LighthouseXy/VoxConductor/hardware/checks/README.md

# 2026-10-11 整理校验

工具：KiCad 10.0.6。本轮只迁移资料，没有修改电路设计。

- [DRC](drc.json)：违规 0，未连接 0，原理图一致性问题 0；读取原有铺铜状态，没有改写 PCB。
- [ERC](erc.json)：错误 0、警告 1。U6 PAD 的“未指定”类型与 GND 电源输入相连，是已有的引脚类型提示。
- 原理图 PDF 重新导出并渲染核对，BOM 与 PCB 顶层 SVG 从当前源文件导出。
- V3 STEP / STL、复用光学件及螺丝/接口通道复查通过；详细记录位于 [V3 checks](../mechanical/V3-SLA/checks/)。
- 后续逐文件复核发现原光学/扬声器报告为空：FreeCAD 内部对象名带下划线，旧筛选跳过了六个结构件。已修正为按零件标签筛选并要求六件/18 组检查；通过 `complete_assembly.py --check-only` 补检，18 组参考包络交叠均为 0。此次未改写 CAD 几何、STEP、STL 或 FreeCAD 装配。
- 当前 KiCad 与原制造版本哈希一致；自定义库、供应商路径与 V3 重建输入保留。

静态校验不代表返修焊点、SD 卡座、树脂公差或全部功能已通过实物验收。
