LighthouseXy/VoxConductor/hardware/docs/audio/README.md

# 扬声器与线束资料

[3020腔体..3瓦.docx](3020腔体..3瓦.docx) 是供应商原始资料，保留原样。文档含 LLX3020B8-02 / LLX3020B4-03 型号混用及功率说明不一致，不能把“最大 3 W”作为连续额定功率。

结构尺寸依据：30 ± 0.2 × 20 ± 0.2 mm，工作高度 6.8 ± 0.3 mm；线长 120 ± 10 mm，30AWG、外径 0.8 mm。阻抗标为 4Ω ± 20%，额定 1.8 W、最大 3 W，先低音量验证。

板端 J3 为 Molex PicoBlade 53261-0271，线端配 51021-0200 与 50058-8000 端子 ×2。供应商原资料只写“1.25-2P”，不保证原线端插头兼容；按具体系列配套。

J3 两脚是 MAX98357A 的桥接输出，两端均不得接地。按脚号核对线序，不凭照片左右猜测。线束转弯、实际长度和固定方式需实配。

V3 托架、压框与紧固件见 [装配说明](../../mechanical/V3-SLA/README.md)。供应商资料保留原有署名和版权。
