LighthouseXy/VoxConductor/docs/HARDWARE_DESIGN.md

# 从电路到整机：我的硬件设计与装配

更新：2026-10-11。这里按设计和装配过程介绍硬件；信号连接、GPIO 与电气检查另见 [硬件与接线](HARDWARE_V1.md)。

我希望它既能完成显示与语音交互，也是一台可以独立摆在桌上的设备。因此，我把模块原型逐步整理为定制 PCB，再围绕屏幕、棱镜、按键和声音设计外壳。下面分别展示电路设计、PCB、加工实物、结构图与整机，不把设计图当作实测结果。

## 1. 先看整机：正面、侧面与后侧

| 正面 | 侧面 | 后侧 |
| --- | --- | --- |
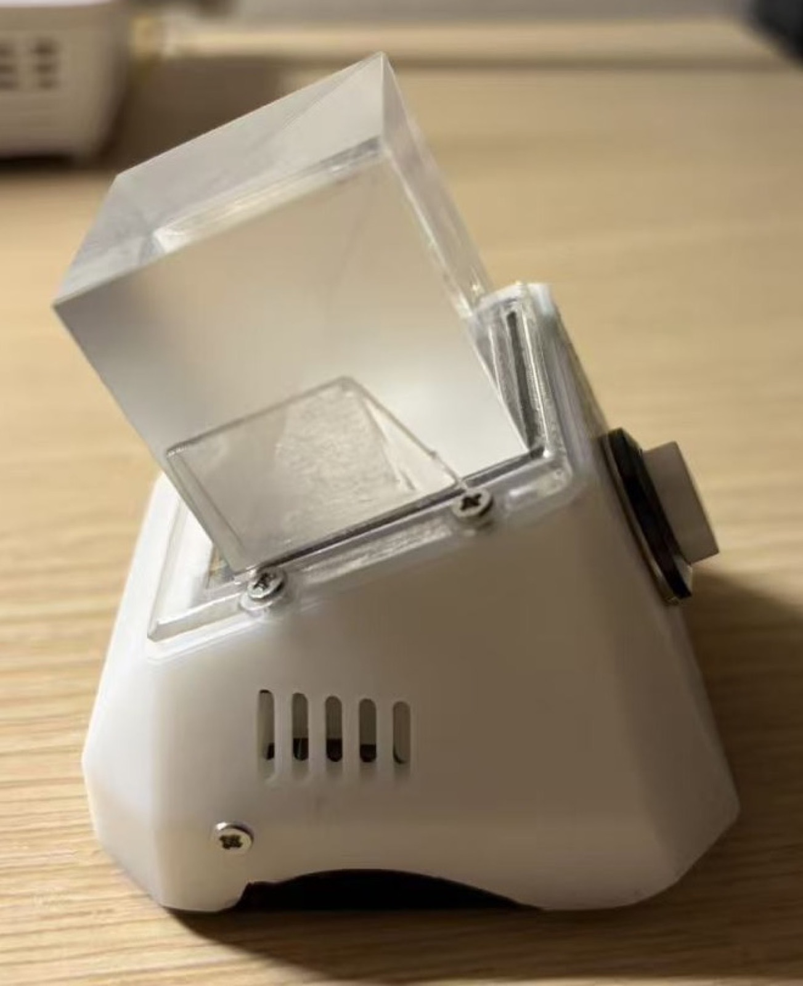
[picture p6: docs/images/2026-10-11/device-side.jpg]
侧面：棱镜倾角与外壳开孔
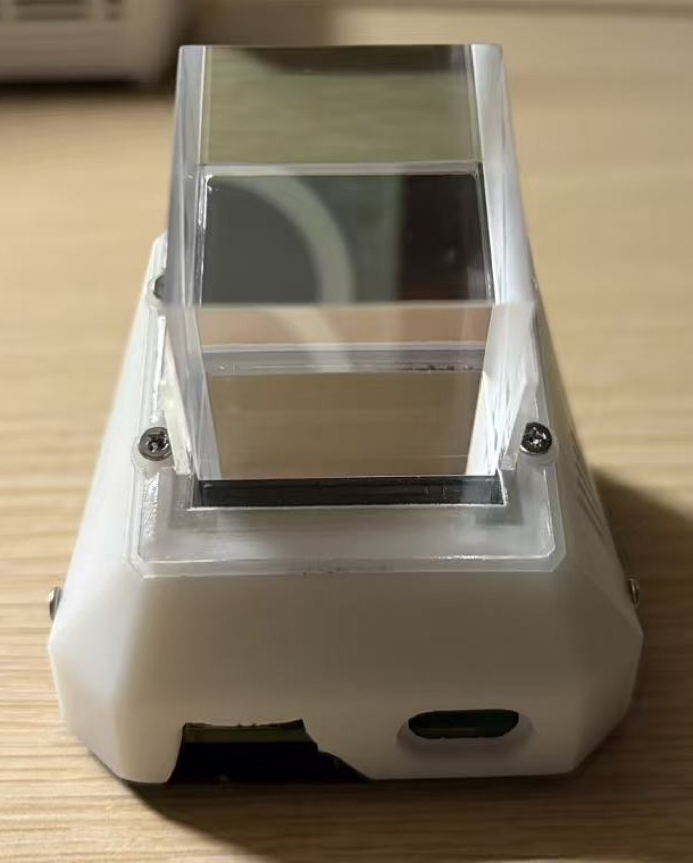
[picture p7: docs/images/2026-10-11/device-rear.jpg]
后侧：底部接口与结构
| 正面：棱镜、屏幕窗口与实体按键 |  |  |

这组是整机三个方向的实拍，不是带尺寸的工程三视图。另一侧的 [卡槽与结构开口照片](images/2026-10-11/device-side-slot.jpg) 用于补充接口观察。照片已从原图直接裁去多余背景，没有重绘设备或修改屏幕内容。

## 2. 电路：把显示、声音和交互放到同一块板上

| 模块 | 器件或接口 | 在设备中的职责 |
| --- | --- | --- |
| 主控与联网 | ESP32-S3-WROOM-1 | 运行固件、管理外设、连接 Wi-Fi 与云服务 |
| 显示 | ST7789 系列，240×240，FPC | 绘制时钟、天气、菜单与语音状态 |
| 采音 | INMP441，独立 I2S 输入 | 为语音识别、唤醒与声学诊断采集声音 |
| 播放 | MAX98357A、外接扬声器 | I2S 音频输出、语音播报与本地媒体 |
| 姿态 | MPU6050，I²C | 倾斜翻页、滚动与时间调节 |
| 存储 | microSD，独立 SPI | 媒体、文字记录、任务与快照 |
| 手动交互 | 外接实体按键 | 确认、返回、按住说话和取消会话 |
| 供电与维护 | USB、电源转换、复位/下载电路 | 供电、烧录、调试与外围电源管理 |

主原理图，从 KiCad 工程直接导出

[打开可放大的主原理图 SVG](images/2026-10-11/schematic-main.svg) · [完整原理图 PDF](../hardware/exports/VoxConductor-schematic.pdf) · [KiCad 工程](../hardware/VoxConductor.kicad_pro)。器件值和网络名称保留工程原样，核对接线请放大查看。

我将显示、SD、采音和播放安排到各自对应的接口上。这样软件可以分别管理它们的速率、队列和错误恢复；并不意味着外设之间不存在 CPU、内存或总线竞争。Flash/PSRAM 容量需要依据模组完整后缀和启动日志确认，不能只看到 WROOM-1 就推断容量。

## 3. PCB：设计布局与加工实物对应看

| 顶层布局（铜层、丝印、板框） | 底层布局（镜像查看底面） |
| --- | --- |
| PCB 顶层导出 | PCB 底层导出 |

当前工程为 52 × 50 mm 四层板：顶层主要布置器件和信号，内层包含地与电源分配，底层辅助布线与铺铜。这两张展示图只导出了外层；完整生产输出见 [2026-09-16 制造资料](../hardware/fabrication/2026-09-16/README.md)。[电子 BOM](../hardware/BOM.md) 单独列出 24 个电阻、22 个电容位置、6 个 IC/模组及连接器等，共 61 个位置；其中 C8、C9 不装配。逐位号明细已与原理图网表核对，采购规格未确认的部分明确留待补齐。

| 贴片前：裸板批次 | 贴片后：器件装配 |
| --- | --- |
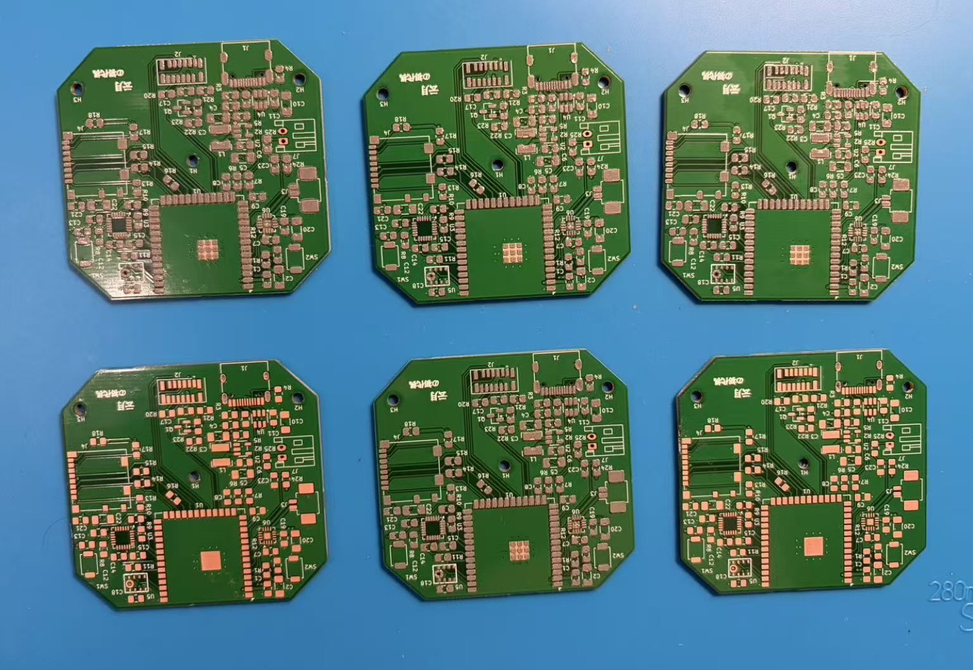
[picture p8: docs/images/2026-10-11/pcb-bare-batch.jpg]
加工完成的裸 PCB
|  | 装配元件后的 PCB |

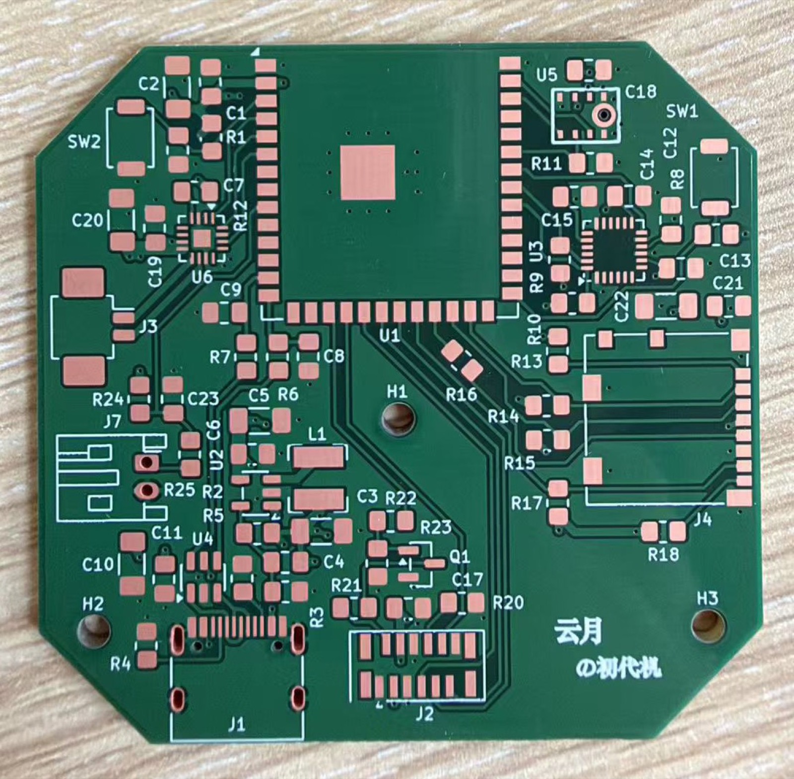
[picture p9: docs/images/2026-10-11/pcb-bare-detail.jpg]
裸板焊盘、板框与丝印细节


从裸板到贴片板，可以对应看到模组焊盘、FPC、USB、卡座和外围器件的位置。照片记录实际加工和装配；电源、焊接质量、音频噪声与长时间稳定性仍通过专项检查判断。

本轮硬件整理保留了 [ERC/DRC 校验记录](../hardware/checks/README.md)。KiCad 主文件仍与 9 月制板版本相同：实物屏幕接口 J2 曾旋转 180° 返修，但尚未写回设计。再次生产前必须完成这项修订并重新审图，不能直接将现有制造文件视为已修正版。

## 4. 装配部件：每一部分负责什么

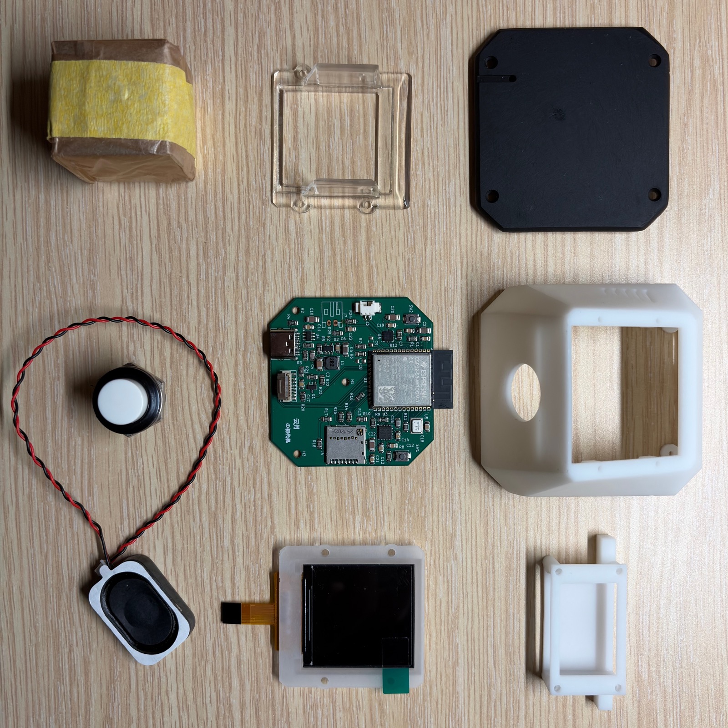
[picture p10: docs/images/2026-10-11/assembly-parts-overview.jpg]
装配部件全景，保留部件之间的位置关系


另一张 [不同角度的部件全景](images/2026-10-11/assembly-parts-angle.jpg) 补充屏幕、外壳和透明件的形状。图中黄色纸包裹的是方形分光棱镜；我补充了去掉包装的独立实拍，下面按电子、显示光学、结构与交互部件介绍。

| 部件 | 用途与装配关注点 |
| --- | --- |
| 主板 | 承载主控与外围电路，按底盖柱位固定，避免排线和线束压住接口 |
| 显示组件 | 屏幕与 FPC 提供图像；接触面和针序按实物接口确认，排线不能夹在接缝中 |
| 主壳与底盖 | 定位电路板、按键和光学组件，保留 USB、SD 与声音通道 |
| 显示固定框 | 固定屏幕/光学组件，检查螺钉、边缘压力和观察方向 |
| 方形分光棱镜 | 将屏幕光线通过分光界面反射至观察方向，形成悬浮显示观感；保护光学面，避免磕碰与污染 |
| 透明支架 | 承托光学组件并保持与屏幕的相对位置；装配时避免划伤或过紧夹持 |
| 实体按键 | 在不依赖语音时完成确认、返回、录音与取消，注意活动空间和走线 |
| 扬声器 | 播报语音与媒体，固定后检查出声通道、线束和结构振动 |

| 主板 | 屏幕与排线 | 外壳 |
| --- | --- | --- |
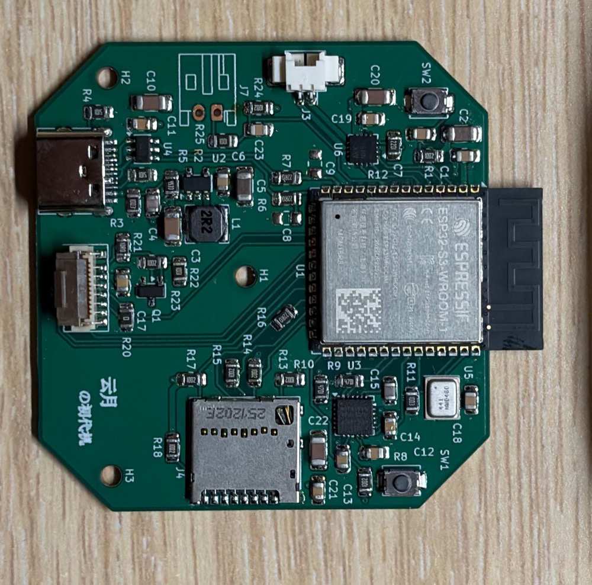
[picture p11: docs/images/2026-10-11/part-mainboard.jpg]
装配主板局部
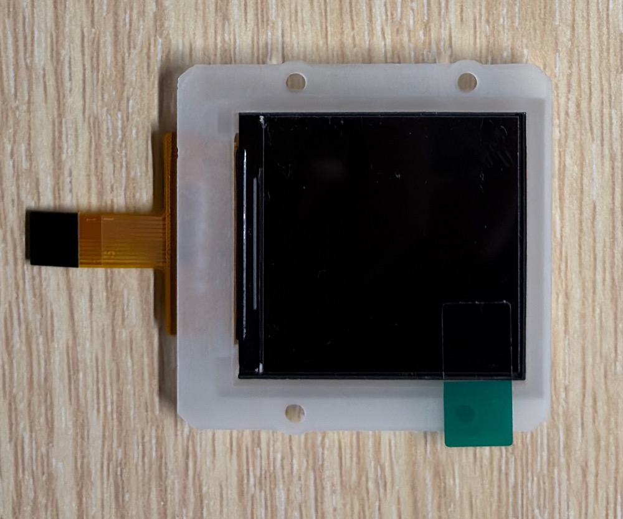
[picture p12: docs/images/2026-10-11/part-display.jpg]
显示组件局部
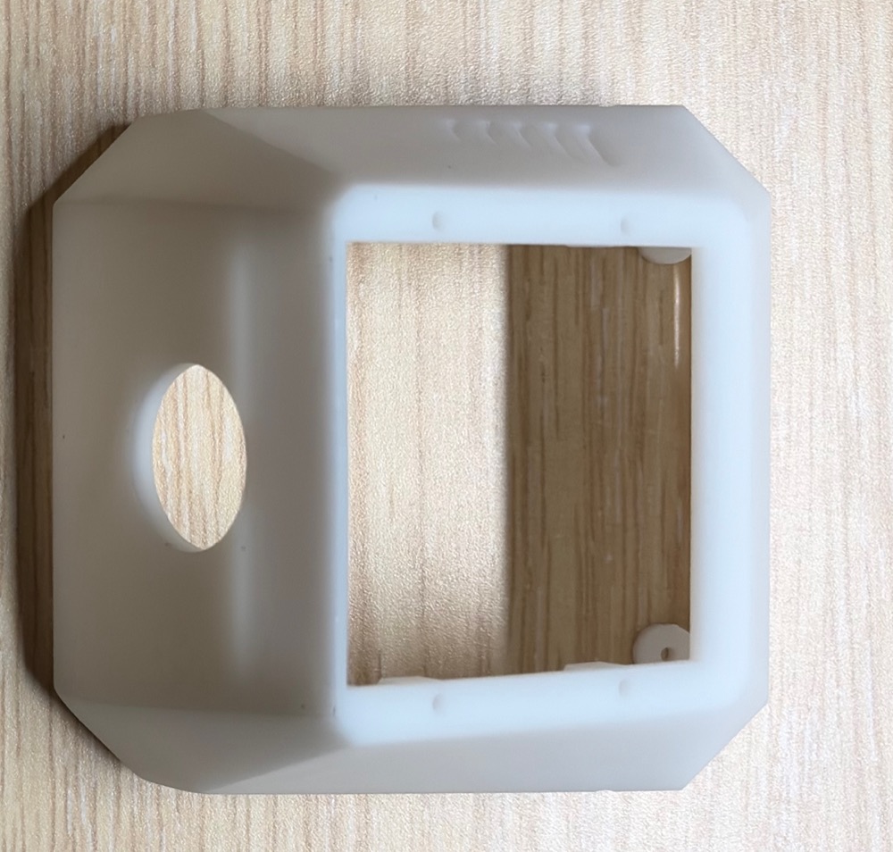
[picture p13: docs/images/2026-10-11/part-enclosure.jpg]
外壳局部
|  |  |  |

| 底盖 | 显示固定框 | 透明支架 |
| --- | --- | --- |
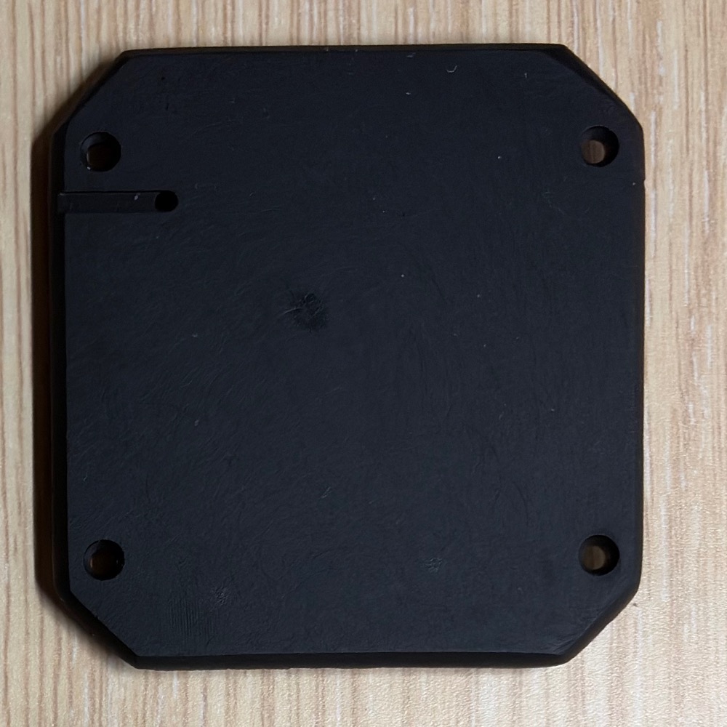
[picture p14: docs/images/2026-10-11/part-base.jpg]
底盖局部
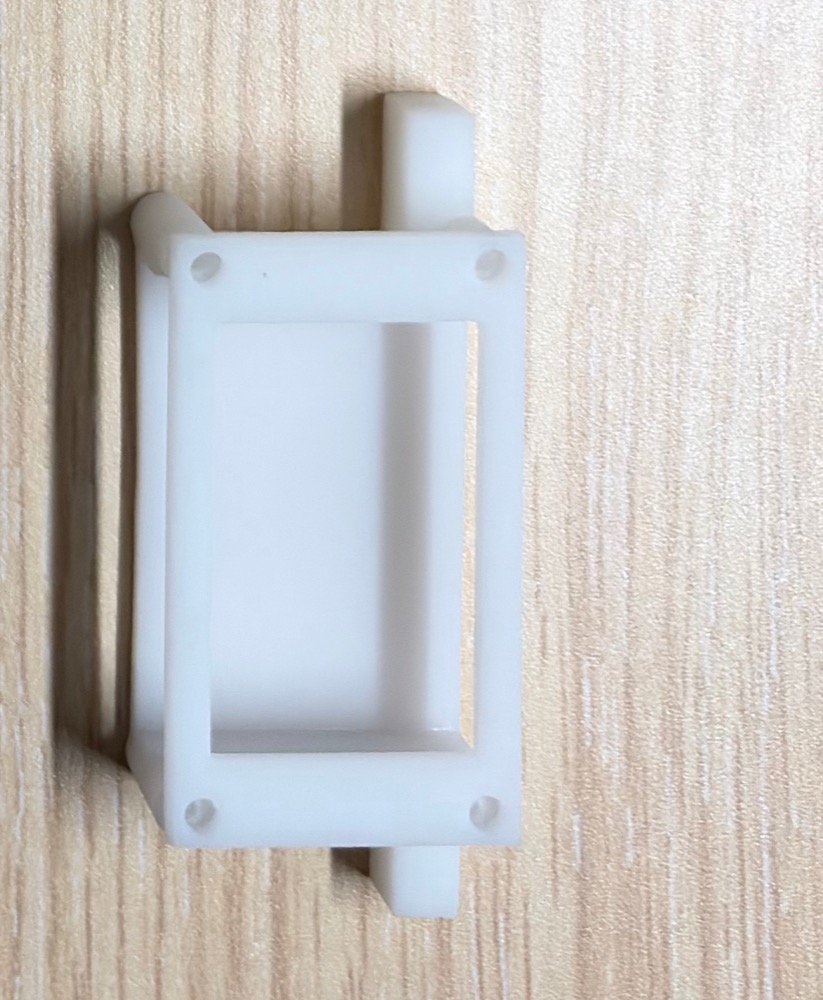
[picture p15: docs/images/2026-10-11/part-screen-frame.jpg]
显示固定框局部
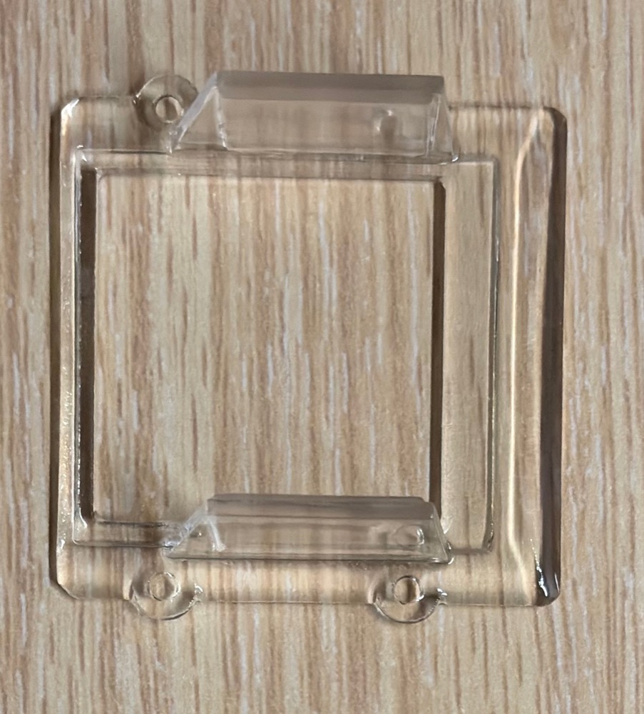
[picture p16: docs/images/2026-10-11/part-prism-carrier.jpg]
透明支架局部
|  |  |  |

| 实体按键 | 扬声器 |
| --- | --- |
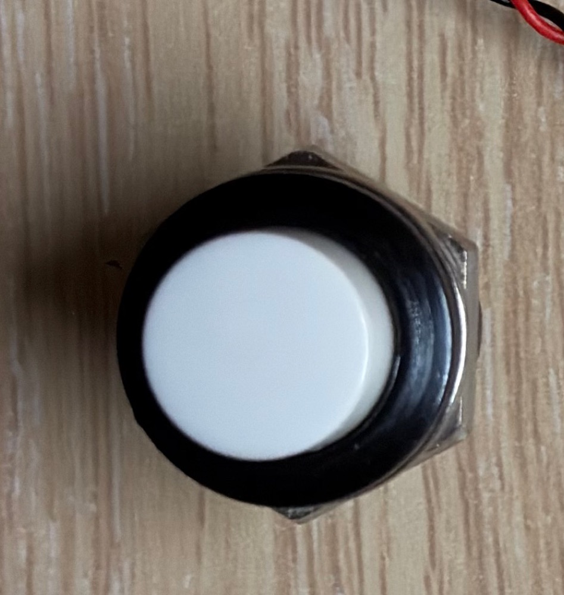
[picture p17: docs/images/2026-10-11/part-button.jpg]
实体按键局部
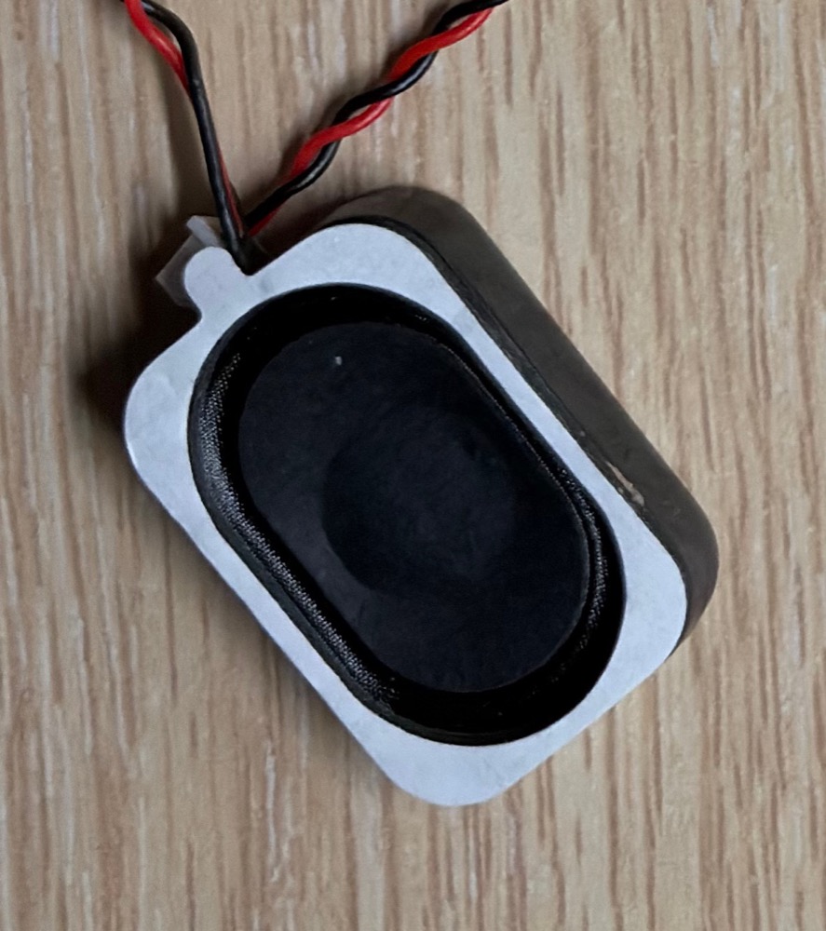
[picture p18: docs/images/2026-10-11/part-speaker.jpg]
扬声器局部
|  |  |

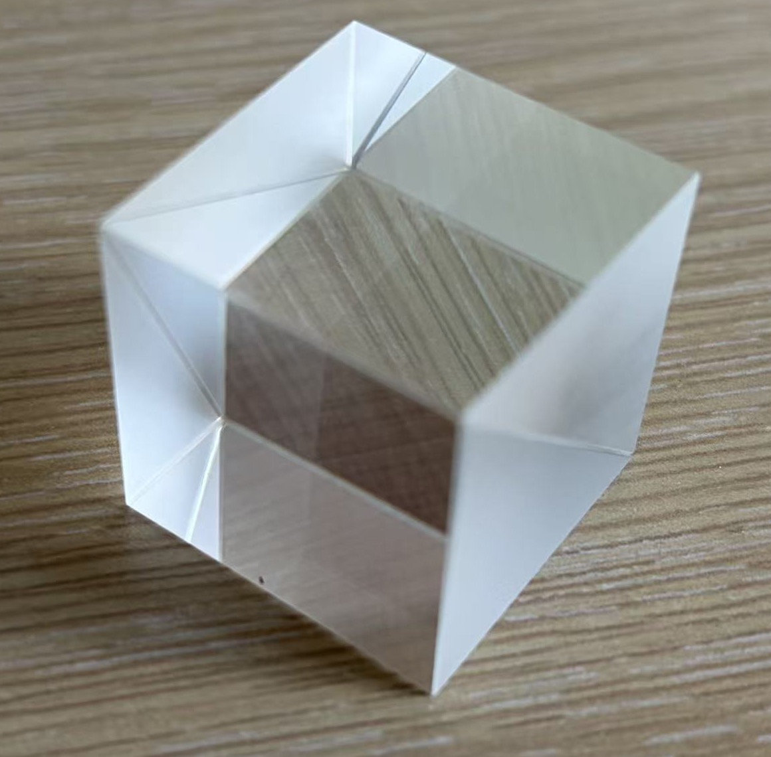
[picture p19: docs/images/2026-10-11/part-beamsplitter-prism.jpg]
去除包装后的方形分光棱镜实拍


八张局部图从部件全景裁出，棱镜图使用 10 月 11 日新增实拍，均未重绘器件。棱镜的分光比例、材料和镀膜规格没有可靠采购记录，不从照片推断。全景与局部图不代替采购清单；[原始部件照片](images/2026-10-10/assembly-parts-overview.jpg) 保留高分辨率版本。

显示链路是“SPI 屏幕图像 → 分光棱镜的内部界面 → 观察者”，不是体积全息显示。黑底减弱背景杂光，亮色字符提供反差；镜像/旋转补偿决定观察方向上的字形。光学件的定位、环境照明和观察角度共同影响清晰度，不能仅提高屏幕亮度解决。结构还要兼顾按键触达、接口插拔、麦克风收音与扬声器固定。

## 5. 3D 结构：已装配实物与后续设计分开记录

以下为 **V3-SLA-20261011 结构设计导出，待打印与试装**。它比上面的实物照片更新，不能把实物照片当作这个版本已经装配成功的证明。

| 外壳设计 | 内部装配分解 |
| --- | --- |
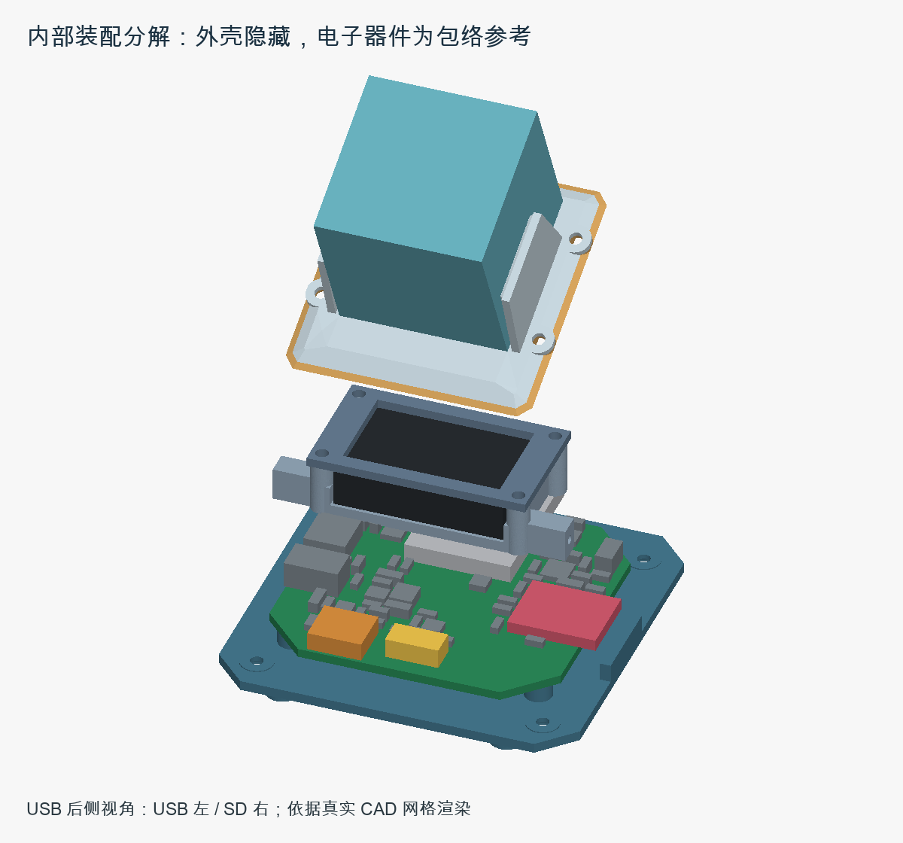
[picture p20: hardware/mechanical/V3-SLA/preview/02_internal_exploded.png]
V3 内部装配 CAD 渲染，待试装
| V3 外壳 CAD 渲染，待试装 |  |

[PCB 与固定柱关系图](../hardware/mechanical/V3-SLA/preview/03_board_and_bosses.png) · [STEP/STL、打印清单与装配说明](../hardware/mechanical/V3-SLA/README.md)。渲染中的电子器件为装配包络参考，不是每个器件的精细外形模型。

这轮结构迭代主要处理 PCB 方向映射、固定柱与装配路径、USB/SD 开口和麦克风位置。设计资料采用“先验证入口框和底盖，再替换外壳相关件”的试装顺序。模型检查只覆盖几何关系；树脂收缩、打印公差、排线弯折、螺钉咬合和声学表现仍需实物确认。

## 6. 资料版本与下一步补齐

| 材料 | 本次记录方式 | 不能据此推断 |
| --- | --- | --- |
| 主原理图与 PCB | 10 月 11 日从现有 KiCad 工程导出 | 不是本次重新电气审核或重新打板 |
| 裸板、贴片板、部件、整机 | 桌面文件夹中的真实照片，裁边展示 | 不保证与最新结构版本一一对应 |
| V3 结构图 | 独立标注版本和待试装状态 | 不等于已打印、装好、通过声学测试 |
| GPIO 与电气说明 | 保留已确认映射，另文维护 | 旧模块 BOM 不能代替定制板 BOM |

工程文件统一收录在 [hardware/](../hardware/README.md)，说明文档直接引用它们，不复制多套 STEP、STL 或 ZIP。必要的冻结输入用于重建 V3，会继续保留；展示照片和工程文件分别管理。

接下来我会将 J2 实物修正写回设计，补全采购料号和实物验收记录，并按 V3 打印清单完成试装。当前资料用于说明与复现设计，不作为量产验收结论。

[返回项目概述](../README.md) · [软件功能与页面](FEATURES.md) · [电气与 GPIO](HARDWARE_V1.md)
