LighthouseXy/VoxConductor/docs/GITHUB_PUBLICATION_CHECKLIST.md

# GitHub 文档、素材与后续代码发布

整理日期：2026-10-11。

2026-10-15 调整发布范围：开发日志和个人面试技术资料仅在本机保留，已从公开版本撤下，并由忽略规则排除后续提交。下文保留原批次的发布记录；当前公开范围以此项调整为准。

## 10 月 10 日展示素材发布范围

此节记录当日首次发布；完整视频在 10 月 11 日后续校订中改为提问阶段变调版，见本文末节。

我先把当前实物、功能演示与开发进展整理清楚。本次只提交 README、docs 文档及精选展示素材；不顺带提交本机尚未发布的固件、服务器代码或构建配置。

- 精选 15 张实拍：整机、PCB、组装部件、天气、闹钟、设置与语音状态。
- 两段完整原声视频：唤醒后查询时间/天气、语音调节音量。
- 两段原声回答阶段节选：保留原速度，注明来源时间，不作为端到端延迟证明。
- 两张视频取帧封面、逐文件来源与 SHA-256 清单。
- 当前使用说明、后续计划及管理网页设计。原已发布的按日开发日志现已撤下，改为仅本地保留。

[展示图集](SHOWCASE.md) · [素材清单](images/2026-10-10/manifest.json) · [文件清单](GITHUB_FILE_MANIFEST.md)

桌面的原始素材全部保留。重复角度和信息相近的照片没有全部放进仓库；高分辨率部件全景采用链接，避免首页自动加载大图。旧 V1 照片和验证记录保留为历史，不拿来证明新固件已经通过验收。

## 这次不发布的内容

- 最新固件、测试、工具、examples、server 代码及 .gitignore 的未提交修改。
- Wi-Fi 密码、API Key、局域网设备令牌、真实配置头文件和 .env。
- BIN/ELF、build、managed_components、本机缓存、虚拟环境与原始串口日志。
- SD 对话、快照、个人记忆、诊断录音、数据库和电脑备份。
- backups 下的旧工程/游戏归档。
- 完整音乐与壁纸资源包；第三方素材必须先核对分发许可和署名。

文档中的“当前开发版”描述我的实机开发进展，不表示这个文档提交已经带上全部新代码。代码发布另做完整性检查，不零散补几份文件制造不可构建的中间状态。

## 后续代码同步要准备什么

1. 固定固件版本和 ESP-IDF/组件锁文件，核对实际板卡、Flash、PSRAM、模型与分区。
2. 以 CMake 引用为准整理源码和辅助头文件，不把已移除游戏、旧播放路径当成当前依赖。
3. 同步配置示例、字体/提醒等必要资源、主机测试与工具，明确哪些测试需要额外媒体包。
4. 用占位符替换示例凭据；检查固件二进制是否包含个人密钥，不直接公开私人烧录文件。
5. 在干净克隆上检查依赖完整性，再构建、烧录和实测；三者与源码检查分别记录。
6. 完整媒体包另行发布，保留作者、许可、来源、格式和校验值，不同时提交 ZIP 与展开副本。

没有实际发布 Release 时不写下载地址，也不将历史资源包大小当作新版本统计。

## 还值得补拍的内容

| 素材 | 用途 |
| --- | --- |
| 长回答完整录音及同轮日志 | 验证卡顿，不靠短成功片段代替 |
| 打断成功、只唤醒后静音的对照 | 验证新输入不是旧回答尾音 |
| 音量/主页操作前后及重启回读 | 验证真正生效与持久保存 |
| 手机与电脑上的管理网页 | 展示当前页面，不使用未落地设计冒充实装 |
| 闹钟到期、预报滚动与姿态调节 | 静态照片看不到的交互 |
| 采购级料号与实测结构尺寸 | 位号级 BOM 已整理；公差、耐压、完整料号和装配实测仍需补齐 |

## 公开表述

我会使用第一人称讲清楚自己做了什么，同时保留事实边界：棱镜是二维屏幕反射；ASR/LLM/TTS 需要云服务；空气质量为网络模型数据与 US AQI；“已接入”“已有成功演示”“重复验收通过”分别表述。

目前不会写“稳定全双工”“零延迟”“所有功能均已验证”或“最新固件已完整发布”。项目文档独立维护，小红书稿暂停，不由 GitHub 推送代替社交平台发布。

## 提交检查

只按明确路径暂存，检查暂存清单与差异、链接、文件校验、凭据和大文件。远端无冲突才正常推送，不强推，不覆盖本机其他改动。最终推送结果以提交记录和远端 SHA 核对为准。

## 10 月 11 日硬件资料同步

新增整理后的 [hardware/](../hardware/README.md)，更新相关文档入口。原理图、PCB 主文件未改写；当前导出的 PDF/BOM/顶层图与生产资料有明确版本说明。V3 保留 CAD 校验与实物试配待完成的边界，实物 J2 返修未被描述为已写回 KiCad。未提交本机固件、凭据、构建或个人资料。

## 10 月 11 日作品文档更新

首页先说明项目目标和技术路线，再介绍硬件与软件。硬件说明增加三个实拍方向、两张部件全景和八个局部，直接链接更新后的工程资料；软件先列总览，再逐页介绍。文档导航区分作品、工程、验证和历史，不采用社交博文格式。

新增裁边展示图、原理图/PCB SVG 和网页模拟截图，来源与校验单独记录。网页改版保留在本机开发版：本批只推送说明与预览，不将未发布固件文件零散混入文档提交。10 月 11 日后续接口修改已编译通过，烧录与实机回归仍待完成。

更新后的硬件资料另做逐文件复核，修正光学/扬声器校验脚本的对象筛选，补齐原空报告的 18 组检查与文件哈希；几何和装配源文件没有改动。这项资料校验修正单独提交，不与固件改动混在一起。

## 10 月 11 日后续校订

补充技术架构，逐项区分当前开发版与 V1 历史说明，修正接线文档中的旧交互描述。定制 PCB BOM 展开为 61 个位号，并与新导出网表核对；采购规格未确认的部分明确保留，不把分组值当完整采购表。

新增方形分光棱镜照片并更正装配部件介绍。两段完整演示提问阶段变调，时间线与画面保留，视频移到首页功能与技术说明后；处理范围和历史原声边界写入视频说明。已有历史提交不重写。
