LighthouseXy/VoxConductor/docs/logs/2026-10-11.md

# 2026-10-11｜硬件归档、作品文档与网页布局

## 今日目标

将项目介绍、硬件工程和功能说明整理为清晰的阅读层次，补充我拍摄的部件照片，并改进同网设备管理网页。小红书稿暂停，不影响项目文档格式。

## 硬件资料整理

现有原理图、PCB、制造文件与 V3-SLA 结构统一归入 `hardware/`。保留源文件、供应商尺寸资料、板载 BOM、校验记录和必要重建输入；旧整包、临时文件和重复 ZIP 不在活动目录里。硬件整理已独立提交，本文档更新直接引用该目录。

KiCad 主文件与 9 月投板版本一致，J2 实物旋转返修尚未写回设计。V3 的 USB 镜像、固定柱干涉和通道已经进行 CAD 检查，打印公差、线束弯折和紧固强度仍待试装，不将模型检查写成实物验收。

逐文件复核发现光学/扬声器报告为空：FreeCAD 内部名称带下划线，脚本的数字前缀筛选跳过了结构件。改用零件标签并检查数量后，以只检查模式补跑 18 组参考包络，交叠均为 0；CAD 几何、STEP/STL 与装配文件未改变。校验报告与重建脚本保留，哈希同步刷新。

## 作品文档与图片

首页按“项目概述 → 演示 → 硬件 → 软件总览 → 实现与问题 → 计划”组织。硬件介绍与 GPIO 参考分开；功能说明先汇总再按页面展开；文档索引区分作品、工程、验证和历史。

部件照片使用一个主要全景、一个补充角度和八张局部图。原图保持不变，展示图裁去多余背景，核对 EXIF 方向后再裁切。包裹部分不猜测内部型号；结构预览直接引用硬件目录，避免重复副本。

两段完整视频和回答阶段节选沿用 10 月 10 日整理结果。本轮没有重剪或加速视频，也不将回答阶段节选作为响应延迟证明。

## 网页实现与问题处理

管理页从长页面改为概览、外观、媒体、事项、对话、诊断六区：电脑侧栏，手机底部导航。复用现有 API，不新增前端框架或云账号。

加入配置草稿提示、刷新保留脏字段、保存前合并最新状态、结果回读、事项筛选和稳定编号。修正图片预览/导出的压黑一致性，保留串行上传并显示传输进度；诊断默认折叠，按需手动开始。

检查中发现百分比单位与唤醒复选框被表单网格拆到独立行，调整为明确的单位标签与横向勾选；上传进度容器也改为实际传输时可见。

## 验证与发布边界

主机测试覆盖媒体上传/WAV、配置草稿与合并、非法数值、失败提示、任务时间、历史分页和安全文本。浏览器使用模拟接口检查电脑/手机布局及设置、事项、历史和诊断入口；截图明确标注未连接实机。

本轮没有编译、烧录或网页实机验收，没有据此修改语音卡顿与打断的结论。文档和展示素材单独提交推送，保留本机其他未发布改动。

## 遗留事项

1. 新固件烧录后回归配置保存、重启保持、媒体上传、语音忙与会话过期。
2. 旧媒体命令统一持久结果、轻量状态接口及有界传输工作槽仍需后端设计。
3. 写回 J2 修正，补采购料号并打印 V3 入口框/底盖试装。
4. 继续用同版本长回答和唤醒词打断对照，验证播报与新问题采集。

[文档导航](../README.md) · [网页说明](../WEB_MANAGEMENT_DESIGN.md) · [硬件介绍](../HARDWARE_DESIGN.md)

## 上午后续更新：技术说明、BOM 与管理功能

继续校订首页、硬件、板级接线、视频与管理说明，新增当前技术架构。视频入口移到功能和实现之后；旧 V1 说明保留历史口径，删除重复迁移提示。上面“未编译”的记录对应此前布局阶段，以下为这轮新增接口的结果。

黄色包装内的部件已确认为方形分光棱镜，新增去包装实拍并裁去背景。电子 BOM 从分组表展开为逐位号 CSV，与新导出 KiCad XML 网表逐项核对：61 个位置，59 个拟装配，C8/C9 为 DNP。补齐无源元件、IC、连接器说明，未确认的采购规格不猜填。

网页增加不读 SD 历史的轻量状态 GET、媒体命令回执查询、上传取消与单段 Range 试听；纪念日刷新保留草稿，未修改字段同步设备。继续复用有限作业槽，不新增前端框架。传输尚非独立异步任务，取消不保证撤回已提交文件。

两段完整视频提问阶段降低音高并补偿时长，视频画面流校验相同，桌面原件保留。没有分离说话者，同区间的环境或设备声音可能一同变调；也不承诺强匿名化或删除旧 Git 历史中的原声。

本轮增量固件编译通过，应用占 4 MiB 分区约 94%，尚未烧录。主机测试覆盖配置与纪念日草稿、媒体回执、取消清理、Range 边界、任务和历史流程。新增接口仍需设备回归，采购料号、J2 修订与 V3 试装继续保留为待办。

完整主机回归最初因测试日志桩缺少 `ESP_LOGW` 宏而停止；补齐桩后通过。该问题属于测试环境，不修改播放策略。最终检查涵盖 TTS 协议、队列取消、工具确认、存储快照、天气、任务与按键；它仍不验证扬声器听感。

## 后续更新：网页播报语速与音色

“主页与声音”加入 0.50～2.00 倍语速（0.05 步长）与六种内置音色，保留“固件默认”。音色列表由设备返回，草稿不立即改变设备；保存共用原协调任务与 NVS 提交，并回读实际值。语音占用时等待空闲，保存成功后从下一次 TTS 会话生效。

云端接收 `voice` / `speech_rate`，设备不做本地变速、不增加音频任务，24 kHz PCM、原播放缓冲和取消路径保持不变。新设置用于回答和云端提醒，不改变音乐、离线提示音或麦克风。旧 NVS v1～v4 迁移到 v5，使用两个保留整数，配置体积不增加；回退旧固件前仍应备份配置。

主机测试覆盖实际 TTS 请求、各音色、语速边界、会话快照、提醒、旧配置迁移、无效值拒绝、草稿与保存回读。电脑和 390 像素手机布局使用模拟接口检查，手机音色控件单独占一行，无横向溢出。固件编译通过，没有烧录、真实云端合成或扬声器听测。

下一步实机用同一句问题比较 0.80、1.00、1.25 倍与男女音色，随后检查重启保存、唤醒/打断、取消和提醒。语速设置不是卡顿修复，卡顿仍按音频供给与 I2S 输出的分层证据验证。
