LighthouseXy/VoxConductor/docs/logs/2026-09-25.md

# 2026-09-25｜定制 PCB 接入与屏幕排查

## 今日目标

把原模块化原型迁移到定制 PCB，核对外设引脚，解决黑屏与显示方向问题。

## 已完成

- 核对显示、按键、音频、SD 和 MPU6050 接口，固件采用新板引脚，不再沿用原型接线。
- 根据板级资料区分复位与下载按键：SW2 为 EN 复位，SW1 为 GPIO0 下载按键；不能仅凭编号判断其他板子的按键。
- 针对无背光，分开检查 3.3 V 电源、GPIO9 控制与背光电流回路。用户测得 GPIO9 约 3.23 V；C17 供电约 3.3 V，R22 两端对地约 0.73/3.23 V，R23 约 0.73/0 V，R21 两端约 0 V。
- 把板级测量和照片交给 PCB 对话继续核对。当天后续照片已出现正常画面，但方向倒置；显示初始化加入对应旋转/镜像调整。
- 保留新板迁移前的工程备份，不覆盖旧版本。

## 问题与解决

| 问题 | 分析与处理 | 结果边界 |
| --- | --- | --- |
| 初始化日志正常，屏幕却不亮 | 软件初始化完成不证明背光电流通路正常；电阻“跨两端电压”和“两端分别对地电压”需区分 | 后续照片证明屏幕可显示；没有足够记录确认最终进行了哪项硬件维修 |
| 画面上下颠倒 | 棱镜反射方向和面板安装方向需要统一处理 | 当日显示方向代码已调整并构建；不能代替后续装壳实测 |
| 不清楚当前亮度 | 当时背光为 GPIO 常高，软件占空比相当于 100% | 不是实测光亮度；后续才增加 PWM 调节 |

## 结论与遗留事项

不凭照片指定未核实的 A/K 焊点，不通过短接猜测背光故障。当前接线以 [硬件说明](../HARDWARE_V1.md) 为准；装壳后的姿态方向、背光与音频仍需联合测试。

本篇依据当日对话、串口截图、板级照片和测量记录补记；未保存到仓库的照片不算公开展示素材。
