LighthouseXy/VoxConductor/docs/logs/2026-09-27.md

# 2026-09-27｜姿态翻页诊断、方向修正与诊断日志收口

## 今日目标

解决装壳后左倾触发反向翻页、右倾没有反应的问题，并使日志便于采集。

## 已完成

- 备份工程名称整理为 Firmware backup，备份的工作区与构建配置同步，不把备份缓存混回主工程。
- 增加原始加速度、滤波、中位、偏移、有效性和 armed 状态诊断，区分采样频率与日志输出频率。
- MPU 检测保持约 20 ms 一次，诊断输出按用户要求降到约 500 ms 一次；不是每次采样都必须打印日志。
- 根据左倾三次、右倾三次的对照日志修正重新武装与安装方向映射；有效重力范围调整到约 0.65～1.50 g。
- 排查结束后移除 XYZ、偏移与识别过程日志，保留实际页面切换、启动和错误信息。
- 分析不改 PCB 的外接 5 V USB 电池模块方案，没有接入充电、电量采样或修改供电硬件。

## 问题与解决

右倾时日志已有约 -458～-480 mg 偏移，却出现 armed=0，不能归因于“用户倾斜不够”。重新回中与稳定状态判断使动作资格提前丢失；部分姿态的加速度模长又超过旧上限。处理包括稳定回中后再武装、离开水平时不提前清除动作资格，以及调整有效性范围。

方向映射在安装坐标到屏幕坐标的入口统一处理，不让页面与游戏各自反转。当天的源码检查与构建有通过记录；后续 10 月 6 日又按装壳反馈统一恢复正常方向，见 [当日日志](2026-10-06.md)。

## 结论与遗留事项

采样快是为了及时判断动作，日志应限速。实机重点是左右都能触发、一次倾斜只翻一次、回中可重新触发，而不是单纯降低阈值。电池仍为设计建议，不记作已实现。
