LighthouseXy/VoxConductor/docs/logs/2026-10-10.md

# 2026-10-10｜播放缓冲、结束对话与作品资料整理

## 今日目标

解决播报持续卡顿和打断后误收录的问题，补齐结束对话入口，并把当前实物与开发进展整理成可公开阅读的作品资料。

## 问题与分析

凌晨测试中，唤醒词打断比之前更容易触发，但只说唤醒词后不继续讲话，设备仍可能收录旧声音。预录缓冲和扬声器尾音需要与真正的新问题区分。

播报卡顿并不总伴随网络 PCM 队列耗尽：日志出现较长的输出写入耗时，提示还要检查任务调度、I2S 和 DMA 的持续供给，不能只增加云端预缓冲。

## 已调整的源码

- 打断接续加入旧音频尾部处理和新的有效人声要求，避免直接把预录内容当作新问题。
- 扬声器 DMA 从 4×160 帧调整为 8×256 帧，24 kHz 下覆盖时间约 26.7 ms → 85.3 ms；匹配写入分块，并同步补偿 AEC 参考排队时间。
- 加入“结束对话”“退出语音”“不聊了”等完整命令的本地处理；清理连续接话与待处理状态，保留历史及下一次唤醒能力。
- 保留按键取消，不把“谢谢”或“不要结束对话”当成退出请求。

这些是源码调整，不是本日已经完成的最新固件听测结论。主机检查、编译、烧录和声学验收仍分开记录。

## 文档与展示整理

我从 23 张照片中选出 15 张，分别说明整机、PCB、部件、天气、闹钟、设置和语音状态。两张信息重复的部件全景只保留一张高分辨率原图，重复角度不全部堆进首页。

两段原声视频分别演示唤醒后查询时间/天气（25.93 秒）和语音调节音量（29.27 秒），另提取回答阶段短片并注明原片区间。保留完整原片用于查看真实过程。

README、图集、使用说明、后续计划、网页设计、发布清单与日志索引同步更新，以第一人称介绍我做了什么，并明确云服务、棱镜反射与声学未完成项。参照第一篇小红书文章，另整理后续更新稿和配图顺序。

## 发布与后续

本批只同步文档与展示素材，不带上未发布固件、私人凭据、原始串口日志或诊断录音。小红书稿单独交付，不自动发布。

接下来用固定长回答、唤醒词打断、只唤醒后静音和结束命令做同版本回归；管理网页截图、闹钟到期及设置重启回读仍值得补充。实物见 [图集](../SHOWCASE.md)，优先级见 [开发计划](../ROADMAP.md)。
