LighthouseXy/VoxConductor/docs/logs/2026-08-08.md

# 2026-08-08 开发日志

## 当日目标

盘点音频器件并确认麦克风模块类型。

## 已完成

- 确认已有扬声器为 4 Ω/3 W 小型扬声器，只有红黑两根引线，不能直接由 ESP32 GPIO 驱动。
- 确认麦克风商品为已焊排针的 INMP441 数字 I2S 模块。
- 根据模块丝印确认接口：`VDD/GND/SCK/WS/SD/L/R`。
- 确认 INMP441 应使用 3.3 V 供电，不是 I2C 传感器。
- 确定麦克风首轮接线：SCK=GPIO8、WS=GPIO9、SD=GPIO14、L/R=GND。

## 结论

- INMP441 输出数字 I2S 采样数据，不需要模拟 ADC。
- L/R 接 GND 选择左声道；固件应读取对应声道的数据槽。
- 扬声器后续需要 MAX98357A 等 I2S D 类功放模块。

## 遗留事项

- 通过串口统计验证 INMP441 是否产生有效采样。
- 核对模块是否存在短路、虚焊或引脚错误。
