LighthouseXy/VoxConductor/docs/images/README.md

# 图片与展示素材

## 当前展示版 · 2026-10-11

我将图片按用途分为整机、加工/装配、功能页面和网页预览。展示图直接从原图裁边，保留完整主体；没有重绘设备、补画器件或修改屏幕内容。八张部件局部图来自同一张装配全景，另一角度作为补充链接。

- [硬件设计与部件说明](../HARDWARE_DESIGN.md)：三个实拍方向、裸板/贴片板、部件全景与局部。
- [功能与页面](../FEATURES.md)：时钟、闹钟、天气、设置、菜单与语音状态。
- [网页布局](../WEB_MANAGEMENT_DESIGN.md)：包含语速与音色设置的电脑/手机预览；截图使用模拟接口，未连接实机。
- [裁切来源与 SHA-256](2026-10-11/manifest.json)：原图名称、方向、裁切坐标、导出来源与文件校验。

V3 CAD 预览直接引用 `hardware/mechanical/V3-SLA/preview/`，不在图片目录保存副本。其待试装状态与实物照片分开标注。黄色包装中的部件已确认是方形分光棱镜，新增拆包实拍作为独立说明；不凭照片猜测镀膜或分光比例。重复角度不全部堆在首页。

## 原始发布素材 · 2026-10-10

我从 23 张原始照片中选择了 15 张信息互补的照片，保留整机、PCB、部件全景、天气、闹钟、设置和语音状态。没有把重复侧面或相近编辑状态全部放上来。

- [完整图集与图注](../SHOWCASE.md)
- [逐文件来源、尺寸与 SHA-256](2026-10-10/manifest.json)
- [提问阶段变调的完整视频及回答阶段节选](../videos/2026-10-10/README.md)

`2026-10-10/` 内另有两张视频取帧封面，不计入 15 张实拍。照片没有生成式改画；部件全景保留高分辨率并通过链接打开。桌面原件不改名、不删除。

天气值只代表拍摄时状态，来源为 Open-Meteo/CAMS，US AQI 不是中国 AQI；设备并非室内空气传感器。语音状态照片不证明所有打断或播放场景已经稳定。

## V1 历史素材

本目录根下原有的原型、主页、天气、语音状态和四轮上下文截图属于旧服务端阶段。它们继续用于 [V1 验证记录](../DEMO_AND_VERIFICATION.md)，不覆盖为新整机照片，不回写成新架构实测。
