LighthouseXy/VoxConductor/docs/logs/README.md

# VoxConductor 开发日志

本目录按实际开发日期记录项目的实现、验证、问题修复和遗留事项。2026-08-26 起，项目对外名称由 AmbientDesk 更新为 VoxConductor；此前日志保留当时使用的名称，不回写历史。

2026-10-07 补齐定制 PCB、设备直连语音、桌面功能与媒体管理阶段。日期按当日对话时间（北京时间）核对，截图和后续源码辅助核实；9 月 28～29 日没有足够日期证据，不补写推测性日记。后续版本改变功能时，在后续日志记录，不回写为早期已经实现。

2026-10-10 补记 10 月 8～10 日的内存与网络梳理、唤醒词打断、播放缓冲、结束对话及展示素材整理。最新修改与后续实测分别记录。

## 日志索引

| 日期 | 主要内容 |
| --- | --- |
| [2026-08-04](2026-08-04.md) | ESP-IDF 开发环境安装与终端验证 |
| [2026-08-05](2026-08-05.md) | 最小固件工程、ESP32-S3 烧录与 ST7789 接入准备 |
| [2026-08-07](2026-08-07.md) | ST7789 点亮、LVGL 9 接入与页面框架 |
| [2026-08-08](2026-08-08.md) | 音频硬件盘点与 INMP441 模块确认 |
| [2026-08-09](2026-08-09.md) | INMP441 故障定位、替换与音量检测 |
| [2026-08-17](2026-08-17.md) | 分区扩容、Wi-Fi、SNTP 校时与主页时间 |
| [2026-08-18](2026-08-18.md) | FastAPI、DeepSeek、设备联网和录音上传 |
| [2026-08-19](2026-08-19.md) | 千问 ASR、MAX98357A、TTS 与完整语音闭环 |
| [2026-08-20](2026-08-20.md) | 进度复核与延迟优化准备 |
| [2026-08-26](2026-08-26.md) | V1 阶段收口、当前实现盘点与公开文档整理 |
| [2026-08-27](2026-08-27.md) | 服务端观测输出整理与四轮上下文实机验证 |
| [2026-09-25](2026-09-25.md) | 定制 PCB 引脚、背光电测与显示方向 |
| [2026-09-26](2026-09-26.md) | Agent 工具停顿、SD 检查与解压工程构建 |
| [2026-09-27](2026-09-27.md) | 姿态方向、重新武装、日志限速与备份工程 |
| [2026-09-30](2026-09-30.md) | 长回答停顿原因与连续语音方案 |
| [2026-10-01](2026-10-01.md) | 单会话 TTS、长回答、讨论与定向删除 |
| [2026-10-02](2026-10-02.md) | 提醒连续播报与字体缺字 |
| [2026-10-03](2026-10-03.md) | 任务、专注、初版游戏与统一透明交互 |
| [2026-10-04](2026-10-04.md) | 音乐/环境音/壁纸、网页上传与资源包 |
| [2026-10-05](2026-10-05.md) | 模拟时钟、预报、主页组合与模型选择 |
| [2026-10-06](2026-10-06.md) | 内存黑屏、天气、网页管理、五款游戏与 Computer 联调 |
| [2026-10-07](2026-10-07.md) | 语音打断源码、阶段文档与公开展示准备 |
| [2026-10-08](2026-10-08.md) | 整体梳理内存、网络、轮次协调与游戏移除 |
| [2026-10-09](2026-10-09.md) | 唤醒词打断、音频诊断、增益与中文模型 |
| [2026-10-10](2026-10-10.md) | 播放缓冲、结束对话、实物视频与公开文档 |
| [2026-10-11](2026-10-11.md) | 硬件归档、部件裁切、作品文档层次与六区管理网页 |

## 记录规则

- “已完成”只记录已有代码、构建产物、串口输出、生成文件或实机现象支持的结果。
- API Key、Wi-Fi 密码及其他真实凭据不得写入日志。
- 代码已接入但未实测，明确标注“源码完成 / 待验收”；计划未实施则放入“遗留事项”。主机检查、构建、烧录、实机听测分别记录。
- 后续每天新增 `YYYY-MM-DD.md`，并同步更新本索引。
- 缺少当日原始证据时不补写推测性日记；阶段总结统一记在实际整理日期。
