LighthouseXy/VoxConductor/docs/videos/2026-10-10/README.md

# 2026-10-10 演示视频

两个主题由拍摄者确认。2026-10-11 更新公开展示版：对提问阶段音轨降低音高并补偿时长，画面流保持相同，不加速视频。桌面拍摄原件保留不变。

| 文件 | 内容 | 时长 / 来源区间 |
| --- | --- | --- |
| [wake-time-weather.mp4](wake-time-weather.mp4?raw=true) | 唤醒并查询时间、天气，完整过程变调版 | 25.93 秒 |
| [voice-volume-control.mp4](voice-volume-control.mp4?raw=true) | 语音调节音量，完整过程变调版 | 29.27 秒 |
| [wake-time-weather-answer-clip.mp4](wake-time-weather-answer-clip.mp4?raw=true) | 查询演示的回答阶段节选 | 15.93 秒，原片 00:10.00–00:25.93 |
| [voice-volume-answer-clip.mp4](voice-volume-answer-clip.mp4?raw=true) | 音量控制演示的回答阶段节选 | 11.27 秒，原片 00:18.00–00:29.27 |

节选不含完整唤醒、提问与等待过程，只用于快速预览，不测量端到端延迟；验证完整操作请看完整过程。没有加速、补配音或把不同时刻拼成一次操作。

## 音轨处理说明

查询视频 00:00–00:10、音量视频 00:00–00:18 的音轨以 0.8 倍音高、1.25 倍节奏补偿处理，保留同样时长与操作顺序。后续回答阶段不主动变调；音轨重新编码为 AAC，画面仍直接复制。处理的是时间区间，不是声纹分离，同一区间里的环境声或设备声音也可能受影响。回答节选沿用此前从原件截取的连续区间。

[处理参数与画面一致性校验](audio-processing.json) 记录来源与输出 SHA-256。变调不是不可逆匿名化；以前的 Git 提交可能仍保留原声，本轮不重写仓库历史。文中不将变调音色作为设备实际 TTS 音色证明。

封面从查询视频约 23.47 秒、音量视频约 26.40 秒取帧。文件校验与来源见 [素材清单](../../images/2026-10-10/manifest.json)，图文介绍见 [图集](../../SHOWCASE.md)。

这不是长时间可靠性或最新底层缓冲改动的验收报告。
