LighthouseXy/VoxConductor/docs/PROGRESS.md

# VoxConductor 开发进度与源码同步（2026-11-03）

本次在远端main最新文档/许可提交基础上，同步此前仅保存在本地的ESP-IDF C固件、宿主测试与工程脚本。原开发工作区保留，未重置或提交其中的私人资料。当前同步是可审查的开发分支，不是新固件二进制发布。

## 已实现的代码

- ESP32-S3 / FreeRTOS / LVGL；按键或WakeNet→实时ASR→本地精确命令或有限模型工具循环→设备ACK→释放模型连接→TTS/I2S。旧server目录是历史实验，不是生产必经服务；实验流式音频桥未计入当前能力。
- 在语音成功轮次边界串行服务提醒和网页作业；共享180秒软件deadline传递到网络/模型/设备操作，不把存储和驱动清理称作硬实时保证。
- 会话提交显式区分成功、可重试失败、永久失败和结果不确定。设备有写前意图、已确认/未知持久回执；未知动作不自动重放，容量满则拒绝新动作。
- 模型提醒与备忘录先形成候选，下一轮精确“确认执行”才保存。重复确认不重复写入，取消和重载不恢复易失执行授权。
- “查看任务保存状态”实际读取校验快照；“重试任务保存”先对账，已有ID恢复运行态任务但不重写，不存在时重新展示候选并等待确认。比较成功后才恢复generation、解除不确定写入栅栏。
- 取消检查覆盖本地命令准入与最终模型回答；本机候选取消同时清理任务重试授权；工具回执按call ID回传。保留记忆来源、TTL、版本、旧值与删除屏障。

## 验证层级

本分支的当次宿主验证结果见[验证记录](SYNC_VALIDATION.md)。使用离线合成输入、虚拟时钟、模拟网络/设备，以及真实快照文件读写和ASan/UBSan；不外发私人语音或记忆。

2026-10-25的本地最终ESP32-S3构建已通过；该历史结果不能替代本次分支的全新固件构建。本次不刷机，也不声称完成实机声学、断电或家居设备验收。

## 本地保留的材料

不上传真实Wi-Fi/模型/设备凭据、SD数据、对话与运行日志、备份、媒体包、大型设计/硬件导入资料和原始审计包。第三方字体源保留既有OFL声明与licenses文件。提醒语音reminder.pcm的再分发权尚未确认，保留本地且忽略；本次没有重授权或上传该音频。原始审计中的私人Library链接、本机路径和原始日志不随本次同步。

## 构建与复现前提

ESP-IDF 6.0.2 / ESP32-S3，本机既有组件锁定版本见firmware/dependencies.lock。

1. 依据firmware/main下*.example.h创建本地凭据头；填写自己的配置，禁止提交。
2. 提供有使用权的24 kHz、16-bit little-endian、单声道PCM到firmware/main/reminder.pcm；它是当前CMake嵌入资源，干净克隆缺少此文件时不能直接完成固件链接。本次未提供该资源或对来源不明音频授予权利。
3. 在firmware目录使用ESP-IDF的idf.py build；依赖下载需要自己的网络环境。本次没有新增云端账号、权限、付费调用或发布固件。
4. 主机测试入口：python3 tests/agent_safety/run_checks.py；python3 tests/agent_safety/run_task_reconcile.py。需要C编译器、Python3与托管cJSON组件源码。

## 尚待完成

多设备预览/版本绑定计划、通用能力注册、跨天任务续办、可控主动提醒设置及全量语义评估仍是计划。当前14工具、有限模型请求、8任务/16记忆/4设备等资源上限未扩容。尚需设备测试：WakeNet/按键打断竞态、I2S取消尾延迟、SD拔出/断电双槽恢复、真实ACK丢失对账、LVGL/音频持续负载下内存峰值、watchdog和端到端p50/p95。
