LighthouseXy/VoxConductor/docs/logs/2026-09-26.md

# 2026-09-26｜Agent 查询停顿、SD 检查与备份构建修复

## 今日目标

消除每次问答都先查询历史并播报过程的停顿，检查提醒保存失败，以及旧工程解压后的构建问题。

## 已完成

- 工具改为按问题开放：普通常识直接回答，时间、天气和旧对话才开放相应工具。
- 工具阶段的“我先查一下”等文字不送入播放队列；最终回答仍保留流式输出。
- 模型文本接收与句段播放分离，合并过短句段；取消时清理待播内容和旧音频。
- 核对 SD 引脚 CS=48、SCK=21、MOSI=47、MISO=14，以及快照恢复、校验和失败回滚。
- 旧工程解压后使用独立构建目录，修正 IntelliSense/编译数据库路径，不复用归档内的绝对路径缓存。

## 问题与解决

| 问题 | 原因与处理 | 验证 |
| --- | --- | --- |
| 每个问题先查缓存、先说一句，再等待 | 无关工具默认开放，工具旁白被播出；接收和播放还存在串行等待 | 当时 10 项主机检查、并发检查与固件构建通过；听感待实机 |
| 提醒报告 SD 写入失败 | 同一提示可能来自未挂载、写失败或读回校验失败；不能只看语音功能是否可用 | 引脚和主机快照测试正常，未确认实板 SD 故障原因；没有格式化卡 |
| 解压后头文件红线、循环重新构建 | 旧 build/CMake 缓存包含旧绝对路径，不是“工程没有改名”导致 | 重新生成独立构建数据后，当时完整构建通过 |

## 结论与遗留事项

本日仍是“合并句段后各自建立 TTS 连接”，尚未实现后来的单会话连续 TTS。构建通过不等于已经烧录，主机存储测试不等于 SD 卡实机读写通过。

当前操作规则和语音实现以 [设备直连说明](../DEVICE_CLOUD_VOICE.md) 为准；后续已由用户自行编译、烧录。
