LighthouseXy/VoxConductor/docs/logs/2026-09-30.md

# 2026-09-30｜长回答语音停顿的链路分析

## 今日目标

定位长回答中途卡顿的原因，确定下一轮优化顺序。

## 已完成

- 沿模型流接收、分句、TTS 建连、PCM 接收和播放路径分析等待位置。
- 识别当时“每个片段独立 TTS 连接”的开销：下一句可能已经生成，却仍需等待上一段播放和新连接握手。
- 确定优先解决连续语音，再推进上下文、讨论状态、工具路由和历史检索；保留设备直连，不引入新的通用 Agent 框架。

## 问题与解决方向

单纯提高音量、增大输出 Token 或添加更多日志不能消除逐段建连的间隔。建议一次最终回答复用同一 TTS 会话，通过有界队列持续追加文本，使网络输入与音频消费并行。

## 结论与遗留事项

本日为原因分析和方案取舍，没有把建议记成已实施。具体代码改动在 [10 月 1 日日志](2026-10-01.md)，声音连贯性仍需实机听测。
