LighthouseXy/VoxConductor/docs/logs/2026-10-02.md

# 2026-10-02｜提醒播报连续性与字体缺字修复

## 今日目标

解决喝水提醒到期后声音卡顿、屏幕文字出现方框的问题，同步进度说明。

## 已完成

- 短提醒优先完整接收后起播，长提醒接近有界缓冲容量时开始消费，避免等待完整接收与满队列互相阻塞。
- 播报期间提高提醒任务优先级，结束、失败或取消后恢复；保留普通回答的低延迟预缓冲。
- 不额外复制一整份 PCM，继续复用现有播放缓冲。
- 为 14 px 字体子集补齐“醒”、中文冒号和固定提醒文案需要的字形、标点。
- 增加起播完整接收、缓冲等待与优先级字段；同步设备直连、语音实施与拓展文档。

## 问题与解决

用户已确认提醒能在时间到达时触发，因此重点是音频消费和显示资源，而不是重新实现提醒计时。方框来自字体缺字，不是需要删掉所有标点。短提示先收齐再播放可能增加首声等待，目的是避免整句中途缺音。

## 检查与遗留事项

字体覆盖及非编译源码检查有通过记录；没有重新构建、烧录或完成听测。需要重复三次短提醒，观察中途停顿、方框、短按取消和随后普通问答；日志“等待为零”不能独立证明扬声器没有卡顿。
