LighthouseXy/VoxConductor/docs/logs/2026-10-03.md

# 2026-10-03｜桌面工具、任务管理与透明界面扩展

## 今日目标

把语音创建的事项变为可见、可管理的桌面功能，统一单键与姿态交互，并加入本地游戏。

## 已完成

- 任务使用稳定 ID 管理，复用最多八条任务记录；接入查看、修改、稍后、完成、取消和删除，以及每天/工作日/每周循环。
- 加入固定离线提醒语音，具体事项显示在屏幕；到期不调用 LLM，没有前置提示音。
- 接入单调时钟倒计时、25/5 分钟番茄钟、暂停与 NVS 恢复；重启后恢复为暂停，不假设断电期间仍在计时。
- 初版九款几何小游戏接入，随后按精选设计稿扩充透明像素风版本；规则与图形固定有界，没有每帧云请求。
- 时钟、天气、语音、桌面工具形成四个基础页；页面切换改为姿态，单击进入/确认，双击返回。
- 游戏进行中长按暂停，再双击退出，避免连击动作触发误退出。
- 统一黑底亮图案、菜单层级和按键职责，梳理回答结束状态、取消路径及联网校时重试。

## 问题与解决

任务、设置、游戏入口原先割裂；通过共用导航与工具入口统一。连续快速点击游戏与双击返回存在冲突，采用用户选择的“先暂停再返回”。网络初始化不能长时间阻塞本地工具，后台重试和资源失败应有明确状态。

## 结论与遗留事项

本日代码与非编译检查有记录，不等于九款游戏都已实机验收。这批旧游戏在 [10 月 6 日](2026-10-06.md) 被五款新游戏替换，不再是当前目录。最新操作见 [桌面功能说明](../DESKTOP_TOOLS_AND_GAMES.md)。
