LighthouseXy/VoxConductor/docs/logs/2026-10-04.md

# 2026-10-04｜SD 媒体、浏览器传输与资源包

## 今日目标

加入音乐、环境音和壁纸，把同网浏览器作为设备资源管理入口。

## 已完成

- 接入 SD 音频与图片目录、播放控制、壁纸选择及浏览器上传/删除。
- 右上角恢复 Wi-Fi 图标，不以固定“已联网”文字代替连接状态。
- 准备十首可再分发轻音乐、八种程序合成环境音和六张静态壁纸；音乐保留 Kevin MacLeod 的 CC BY 4.0 署名与转换说明。
- 浏览器将兼容音频解码、转换为设备支持的 24 kHz/16 位/单声道 PCM WAV；图片转换为 240×240 RGB565。
- 管理窗口改为十分钟无操作超时；成功请求/传输推进会续期，单文件另有三十分钟总时长和三十秒停滞限制。
- 上传使用临时文件、格式校验和旧文件保留，失败不把半文件当成有效媒体。

## 问题与解决

| 问题 | 处理与边界 |
| --- | --- |
| app_media 的 snprintf 被 Werror 拦截 | 限制文件名复制长度、检查目标路径容量；不关闭截断告警 |
| 十分钟内上传不完 | 区分会话空闲时间与文件传输时长，不把所有上传限制在固定十分钟内 |
| MP3/FLAC 能否直接播放 | 由浏览器兼容解码后转 WAV；不是 ESP32 原生支持这些压缩格式 |
| 音质不如源文件 | 当前仍是 24 kHz 单声道；48 kHz 高质量播放只是讨论建议，尚未实现 |

## 检查与遗留事项

资源包和网页源代码检查不能替代浏览器兼容性、上传实测和扬声器听感。音乐/环境音留在 SD，不把整包编入固件。新壁纸在棱镜上的暗部漏光，需要下一轮重新处理。
