LighthouseXy/VoxConductor/docs/logs/2026-10-05.md

# 2026-10-05｜模拟钟表、天气预报、主页组合与唤醒模型选择

## 今日目标

改善棱镜显示效果，加入闹钟与逐小时天气，确定免按键语音方案。

## 已完成

- 先保存时钟界面源码备份，再接入圆形指针时钟、日期和前后层次效果；这是二维绘制/视差，不是实际三维投影。
- 增加闹钟时间编辑、语音闹钟/备忘录能力，以及“圆形时钟 / 壁纸加数字时间”的主页组合。
- 接入逐小时天气与紫外线数据，明确未来十二小时、四列视窗的方案。
- 静态壁纸改为黑底亮图案，压黑无图案区域，避免整屏背景发光；效果需在棱镜而非普通显示器上判断。
- 网页入口整理为设备根地址加配对认证，避免把配对码错误拼到路径。
- 选择 ESP-SR 内置英文 Computer 模型作为当前唤醒词；定制“小助小助”申请有提交记录，但没有模型交付/验收依据。

## 问题与解决

任意文字配置不能改变已训练模型的唤醒词；TTS 音源定制申请与在线 TTS 播报不是同一功能。Computer 需要对应模型、模型分区和运行开关；只烧应用并不保证模型可用。

网页二维码和扩展管理功能在本日提出，完成接入记录在 [10 月 6 日](2026-10-06.md)，不提前记为已完成。

## 检查与遗留事项

备份位置、时钟代码与资源文件有依据，新增效果尚需用户编译/烧录确认。日期与时间白天可读性、主页与屏保分离、预报完整滚动和模型加载在下一日继续修正。
