LighthouseXy/VoxConductor/docs/logs/2026-10-06.md

# 2026-10-06｜显示内存、网页管理、天气与 Computer 唤醒联调

## 今日目标

解决烧录后黑屏、联网/空气质量失败、界面忙和唤醒无效，并完成新页面与连续对话。

## 已完成

- 删除旧游戏，改为俄罗斯方块、反应测试、星际飞机、2048、贪吃蛇五款；透明图形、固定资源与暂停规则共用。
- 二级工具菜单采用三列九宫格，超出部分按行浏览；移除全页重复操作说明。
- 加入星空、轨道、浮游水母和光点花园四款动态壁纸；主页可恢复圆形时钟，屏保固定为不带壁纸的圆形时钟。
- 放大并提亮主页日期/时间；十二小时天气四列视窗采用倾斜角度越大、滚动越快的连续控制。
- 天气参数加入 USAQI/PM2.5、实时 UV、当日最高 UV 与 UV>3 时段、风力/阵风、湿度与体感，时段放入 UV 卡片。
- 管理网页接入二维码配对、状态/主页/壁纸/音量/亮度/唤醒设置、闹钟/待办/备忘录管理及当前卷语音记录查询。
- 修正 Computer 模型生命周期、输入增益与检测阈值检查；用户反馈已能唤醒进入聆听。
- 自动录音使用 VAD 静音结束，ASR 按协议提交末尾数据；回答后十二秒接话窗口内可直接问下一句。
- 时钟单击直接进入闹钟，不再进入待办；闹钟小时/分钟采用按倾斜幅度连续变速。
- 姿态方向按最新要求恢复正常映射，页面、滚动与游戏共享坐标入口。

## 问题与解决

| 现象 | 定位 | 处理 |
| --- | --- | --- |
| 完全无背光、反复重启 | app_display_init 返回 ESP_ERR_NO_MEM；单个 LVGL 内存池大小超出配置能力 | 先分池，再将基础池/大显示内存正确放入 PSRAM，失败清理，增加内存诊断 |
| 屏幕恢复，天气/维护/提醒任务创建失败 | 显示、TLS 和任务栈仍竞争内部 RAM | 收紧内部常驻占用、调整启动/任务资源；SD 不能替代实时 RAM |
| 天气页“界面忙”、倾斜丢动作 | 动作等待 LVGL 锁超时，更新中存在不必要长锁占用 | 减少重复绘制，输入在 UI 线程递交，连续滚动不在 IMU 任务里占显示锁 |
| UV/PM2.5/阵风显示字母 f | 当前 libc 格式输出未提供预期浮点显示 | 用定点/整数格式输出具体值，不把它误判为天气接口没数据 |
| Computer 开启后崩溃 | WakeNet 清理/重置路径进入无效内部状态 | 生命周期由模型拥有者处理，避免不安全 clean；队列扩到十六帧 PSRAM |
| 模型误显示“未加载” | 阈值请求 0.55 被库量化为约 0.546，精确相等检查误判 | 接受合理量化差异，输入增加 DC 去除、增益和削波统计 |
| 唤醒后问完请求失败 | 自动结束与 ASR 最终提交时序不完整 | VAD 静音约 1200 ms，提交再结束；无活动/最长时限受约束 |
| 空气质量 HTTP=0 / TLS 超时 | 连接失败而非 USAQI 格式不适用于杭州；诊断发现 DNS 路由问题 | IPv4/TLS 诊断、成功数据缓存与重试、优先 DNS；不关闭证书验证 |
| idf.py command not found | 普通终端没有加载 ESP-IDF 环境 | 使用扩展的 ESP-IDF 终端或加载 export.sh，再选择实际串口 |
| 2048 数字格式截断编译错误 | 缓冲只有八字节，不足容纳 uint32 最大十位数字与结尾 | 缓冲扩为十一字节并用 sizeof；不关闭 Werror |

## 检查与遗留事项

用户截图/反馈支持：新板可显示、基础语音可正常回答、提醒到期触发、Computer 能进入聆听；不能据此推定全部后续改动已通过。多轮非编译检查有通过记录，没有替用户构建或烧录最新版本。

仍需回归空气质量稳定刷新、弱网、连续自动接话、闹钟变速、长时间游戏共存和二维码跨浏览器兼容。网页已有十分钟“空闲”续期，不是彻底取消会话限制。SD 临时替换不是 FAT 断电原子事务，电源故障恢复仍有边界。
