LighthouseXy/VoxConductor/docs/logs/2026-10-09.md

# 2026-10-09｜从自由语音打断转向唤醒词打断

## 今日目标

让设备在播放回答时能够可靠地被打断，同时避免扬声器的声音被当成我的新问题。

## 遇到的问题

- 设备回答一小段就暂停，随后误进入聆听，甚至把自己的尾音识别成输入。
- 串口能看到反复“疑似讲话、暂停、恢复”，这与实际卡顿对应，说明判定路径本身会影响播放。
- Computer 空闲唤醒和播放中检测表现差异很大；说得更大声也不一定改善，增益和削顶可能让音频失真。
- 简化日志之后能更容易区分正常结束、打断取消和按键取消。

## 调整与实现

我放弃把任意 VAD 人声候选直接当作取消依据，改为回答播放中经过 AEC 后检测唤醒词，命中后再交接到新一轮。按键取消继续保留。

增加按需唤醒/打断诊断及音频分轨下载，让判断不再只靠一张串口截图；同网网页按我的使用需求移除配对码要求，但仍在设备侧开启管理窗口。

本地唤醒增益从较大倍数逐步降到 1 倍，随后把模型从 Computer 切换为“小冰小冰”，并调试检测阈值。这些调整只改变对应检测环节，不代表所有音频处理都取消增益。

## 观察到的结果

当晚日志已有“播放中检测到唤醒词 → 接受打断 → 旧轮取消 → 新轮聆听”的记录，说明交接链路确实能够工作。但多次测试仍有漏检和卡顿，我没有把一次成功当作功能稳定。

## 后续安排

继续检查只说唤醒词后保持安静时的行为、旧音频尾部清理，以及缓冲充足时为什么仍然卡顿。原始诊断录音只用于本地分析，不作为公开展示素材。
