LighthouseXy/VoxConductor/docs/logs/2026-08-26.md

# 2026-08-26｜V1 阶段收口

## 今日目标

- 以当前代码和实机结果为准，移除早期方案中的过期描述。
- 整理公开仓库所需的 README、架构、硬件、验收和限制说明。
- 引入实机界面图片，并准备可公开提交的配置示例。
- 在首次 Git 提交前检查密钥、运行数据和生成文件。

## 当前实现盘点

### 设备端

- ESP32-S3 N16R8 Nano，ESP-IDF 6.0.2，16 MB Flash 和 8 MB PSRAM。
- ST7789 240×240 显示与 LVGL 9 页面完成；棱镜方向由显示驱动补偿。
- 单键短按切页、长按 500 ms 开始录音、松开发送。
- INMP441 以 16 kHz 采集；录音长度限制为 1～20 秒。
- MAX98357A 播放 24 kHz PCM；TTS 音频下行采用 HTTP 分块流和 16 KiB 预缓冲。
- microSD 追加写入 `conversations.txt`，记录时间、用户文字和 AI 回答。
- Wi-Fi、SNTP 和天气定时更新已经接入。

### 服务端

- FastAPI 接收原始 PCM，校验长度后生成 WAV 供 ASR 使用。
- 千问 ASR 返回文字，DeepSeek 结合最近 12 条 SQLite 消息生成回答。
- 千问实时 TTS 通过 WebSocket 生成 PCM，FastAPI 使用 `StreamingResponse` 下发。
- `session_id` 与 `turn_id` 用于会话和轮次标识；设备在播放前校验返回轮次。
- Open-Meteo 提供当前天气，服务端缓存 10 分钟。

## 文档与仓库整理

- README 改为当前实装架构，不再保留“尚未开工”“屏幕/麦克风待确认”等过期内容。
- 新增 `ARCHITECTURE.md`，记录真实数据流、状态、上下文、错误降级和限制。
- 重写 `HARDWARE_V1.md`，给出当前 GPIO 与电气安全约束。
- 新增 `DEMO_AND_VERIFICATION.md`，提供可重复的端到端验收流程和能力边界。
- 增加 `server/.env.example`、`server/requirements.txt` 和 Wi-Fi 示例头文件。
- 将 SQLite、录音、TTS 输出、构建目录和真实凭据排除在 Git 之外。
- 从开发照片中选择实机原型和各页面图片，统一保存到 `docs/images/`。

## 明确未完成

- 播放中取消、自然语音打断、VAD、唤醒词、AEC 和全双工语音。
- 流式 ASR 与流式 DeepSeek 文本。
- HTTPS/WSS 设备认证、运行时配网和服务地址配置。
- 多用户/多设备隔离、长期记忆、工具调用 Agent 和联网搜索。
- 定制 PCB、成品外壳、电池、电源完整设计和量产验证。
- 正式延迟分位数、识别准确率、连续运行与弱网测试报告。

上述项目在 V1 文档中只作为边界或后续工作，不记为当前成果。

## 项目命名更新

- 对外名称由 `AmbientDesk` 更新为 `VoxConductor 桌面智能语音中枢`。
- `Vox` 表示语音入口，`Conductor` 表示对模型、音频、信息服务和未来设备能力的统一协调。
- 屏幕品牌、服务标题、模型身份、默认会话标识和固件产物名同步更新。
- 固件目录重命名为 `firmware/`，入口文件重命名为 `firmware/main/main.c`，项目根目录同步更新为 `voxconductor/`。
- 早期日志保留当时使用的名称，不回写历史；旧数据库名称仅保留在一次性迁移逻辑中。
