LighthouseXy/VoxConductor/docs/logs/2026-08-19.md

# 2026-08-19 开发日志

## 当日目标

完成 AmbientDesk V1 最核心的真实语音问答闭环。

## 已完成

### 云端语音链路

- 选择并接入千问 `qwen3-asr-flash`，成功识别中文和英文录音。
- `/audio/turn` 接口完成：录音 → ASR → DeepSeek → TTS → PCM 返回。
- DeepSeek 回答限制为简短中文，降低等待时间和 TTS 音频体积。
- 接入千问 `qwen3-tts-flash`，音色使用环境变量配置。
- TTS 输出验证为 24 kHz、16位、单声道。
- 服务端保留最新输入录音 `recordings/latest.wav` 和最新回答 `tts/latest.wav`。

### 扬声器与播放

- 接入 MAX98357A 和 4 Ω/3 W 扬声器。
- 接线确定为 BCLK=GPIO15、LRC=GPIO16、DIN=GPIO17、VIN=5 V、共地。
- 扬声器只接 MAX98357A 的正负输出端，负端不接 GND。
- 先播放低音量测试音，再验证服务器 PCM 下载和真实 TTS 播放。
- 固件按 24 kHz 接收单声道 PCM，复制为左右相同的 I2S 数据发送给功放。
- 软件播放音量初始设置为 20%。

### 完整设备流程

- BOOT 从临时页面切换键改为开发期语音触发键。
- 短按 BOOT 后执行：

```text
LISTENING（录音3秒）
→ THINKING（上传、ASR、DeepSeek、TTS）
→ SPEAKING（播放AI回答）
→ HOME
```

- 增加“系统未就绪”和“对话正在进行”保护，避免重复创建请求。
- 关闭上电自动蜂鸣、固定聊天、自动录音和固定 TTS 测试。
- 使用 FreeRTOS 互斥锁协调音量检测和正式录音，修复 I2S 内部信号量冲突。
- 完成实机验证：说话后 AI 能识别、回答并从扬声器播放。

## 关键证据

- `server/recordings/latest.wav`：约 94 KiB，最后生成于 23:00。
- `server/tts/latest.wav`：约 409 KiB，最后生成于 23:00。
- `ambient_desk_firmware/build/ambient_desk_firmware.bin`：最后构建于 22:56。
- 串口出现“本次语音对话完成”，并有实际扬声器播放结果。

## 遗留事项

- 当前为固定3秒录音，不是按住说话、松开提交。
- 服务端全部处理完成后才返回整段 PCM，尚未流式播放。
- 尚未实现取消、`session_id/turn_id` 和迟到数据丢弃。
- BOOT 是启动绑带脚，只适合作为开发期临时语音键。
