LighthouseXy/VoxConductor/docs/images/2026-10-10/alarm-edit-hour.jpg

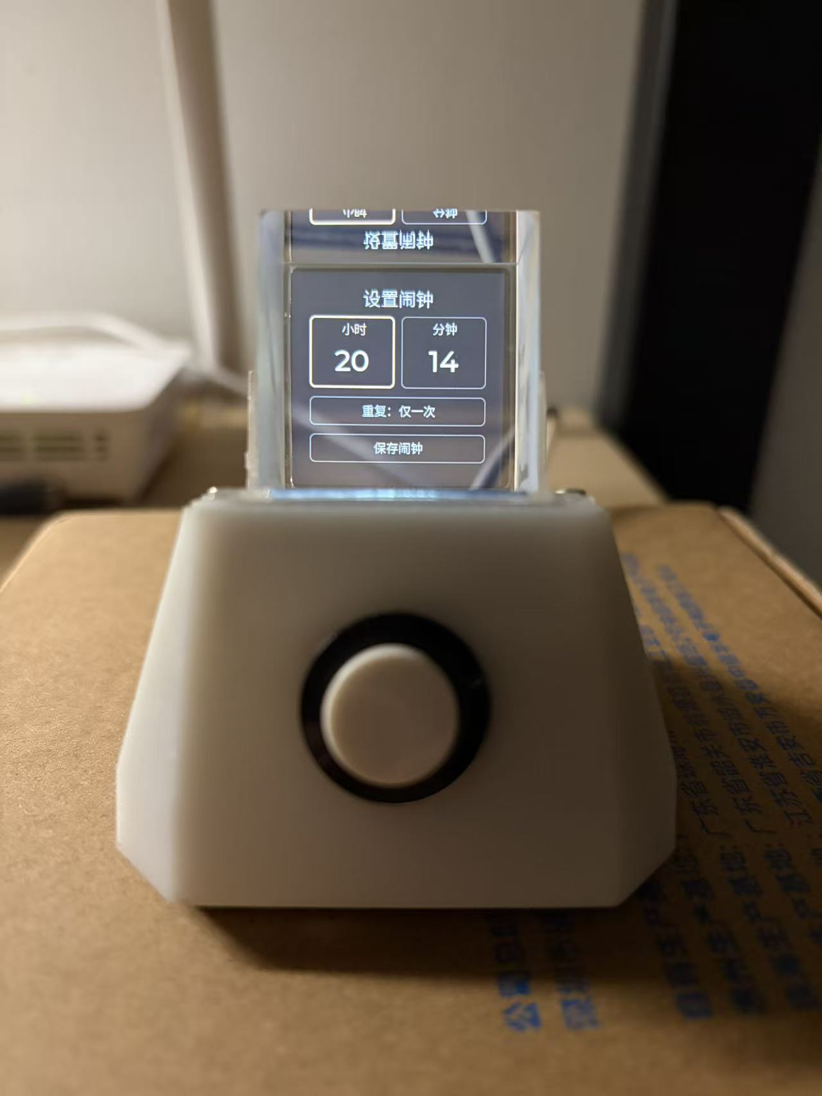
docs/images/2026-10-10/alarm-edit-hour.jpg
