LighthouseXy/VoxConductor/docs/images/2026-10-10/desktop-menu.jpg

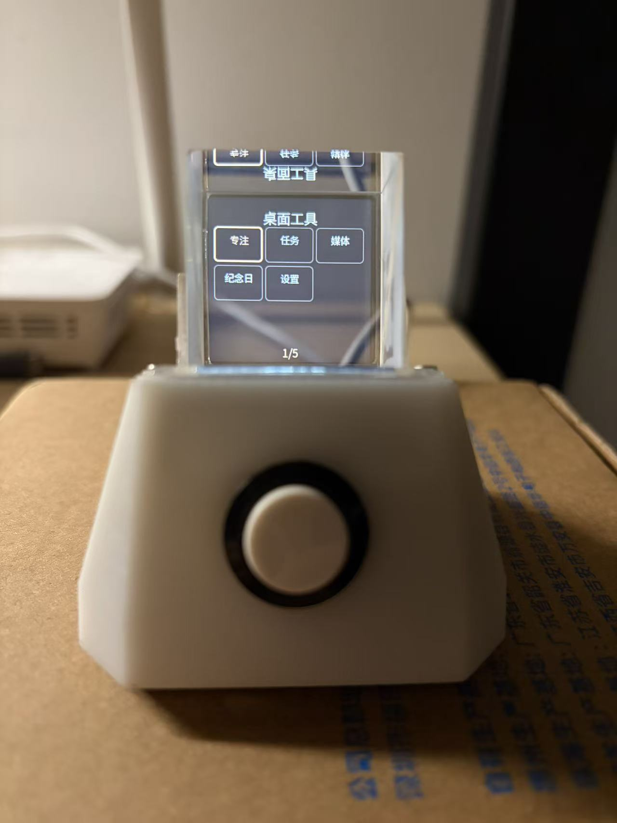
docs/images/2026-10-10/desktop-menu.jpg
