LighthouseXy/VoxConductor/docs/images/2026-10-10/device-clock-front.jpg

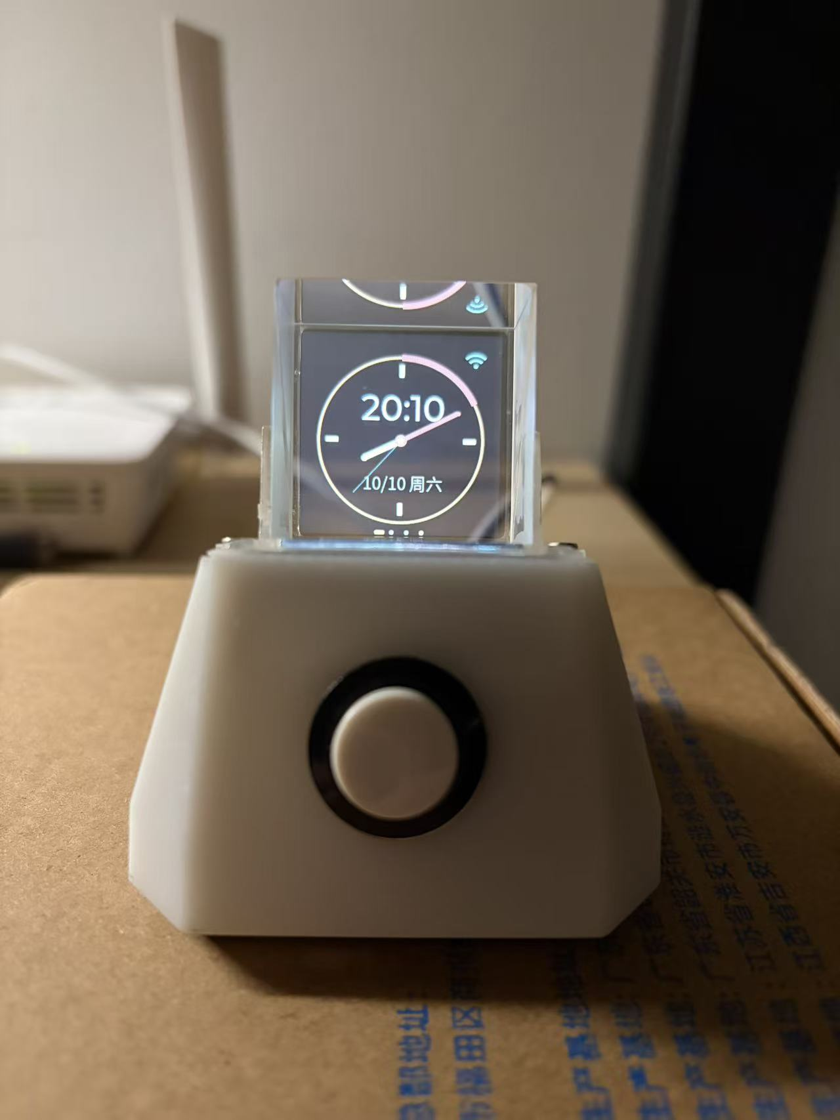
docs/images/2026-10-10/device-clock-front.jpg
