LighthouseXy/VoxConductor/docs/images/2026-10-10/device-rear.jpg

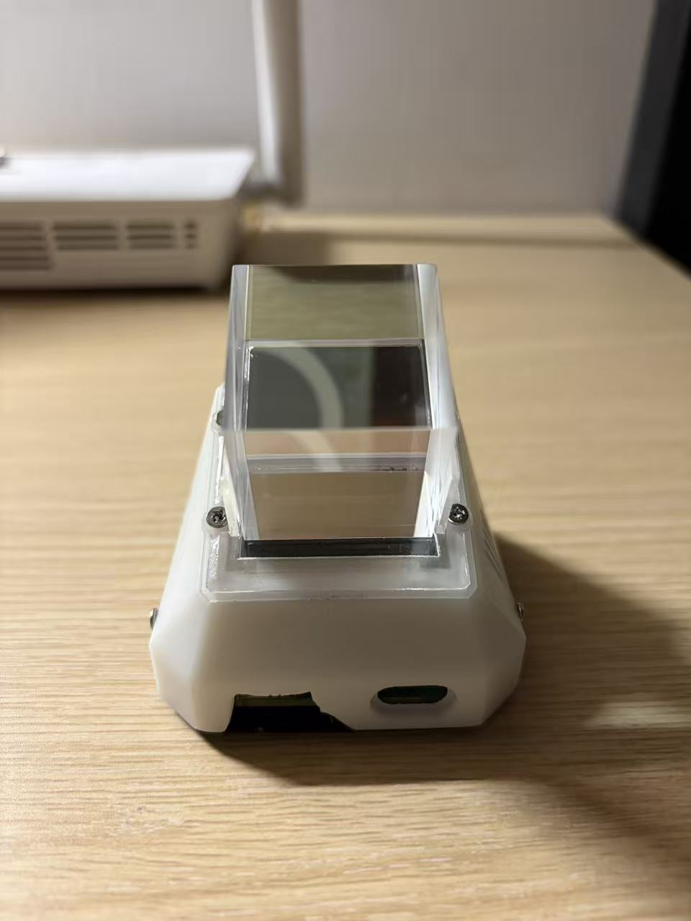
docs/images/2026-10-10/device-rear.jpg
