LighthouseXy/VoxConductor/docs/images/2026-10-10/device-side.jpg

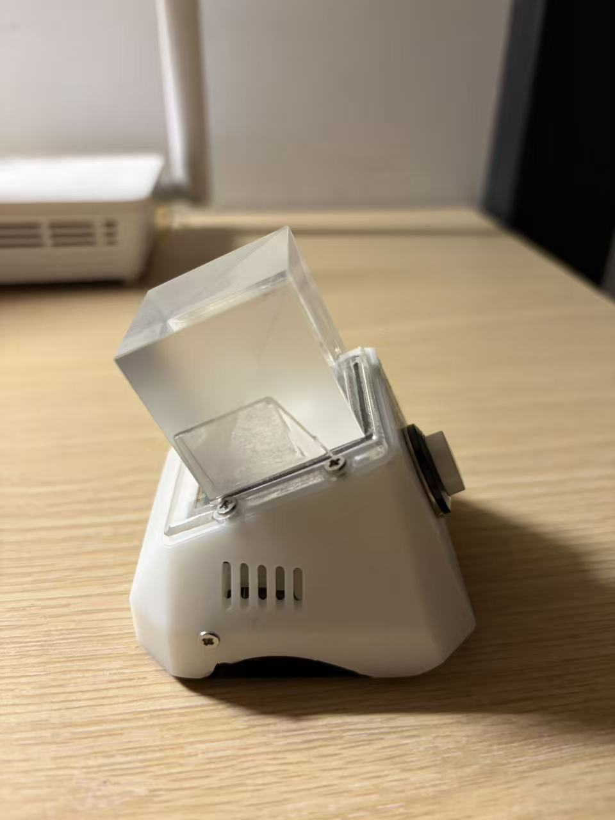
docs/images/2026-10-10/device-side.jpg
