LighthouseXy/VoxConductor/docs/images/2026-10-10/pcb-bare-detail.jpg

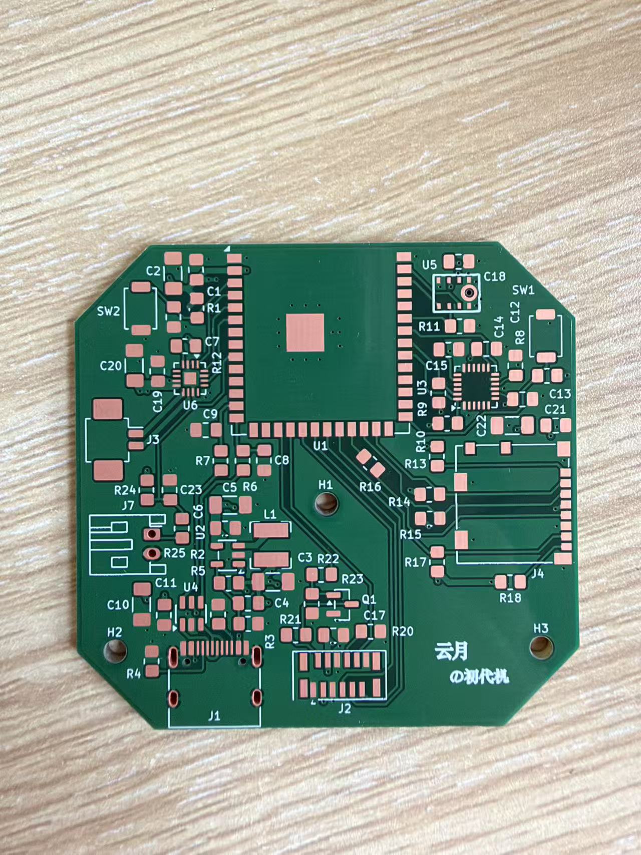
docs/images/2026-10-10/pcb-bare-detail.jpg
