LighthouseXy/VoxConductor/docs/images/2026-10-10/voice-listening.jpg

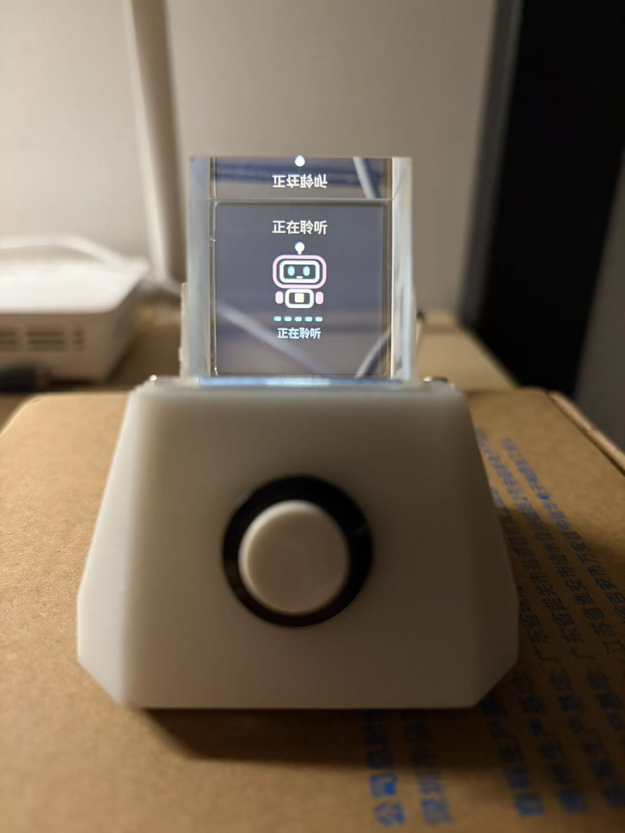
docs/images/2026-10-10/voice-listening.jpg
