LighthouseXy/VoxConductor/docs/images/2026-10-10/weather-current.jpg

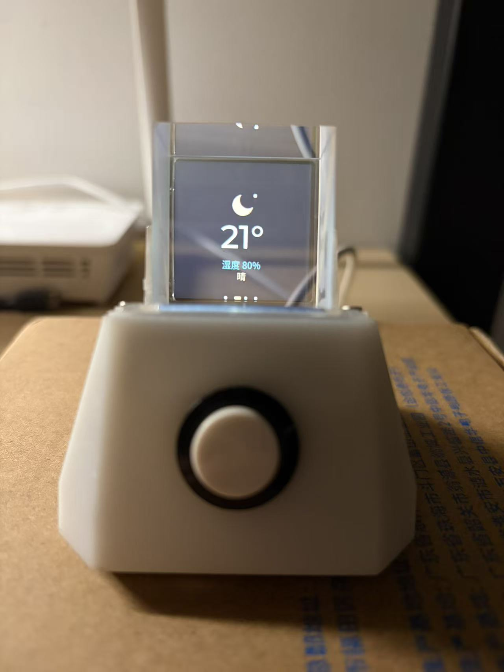
docs/images/2026-10-10/weather-current.jpg
