LighthouseXy/VoxConductor/docs/images/2026-10-10/weather-hourly.jpg

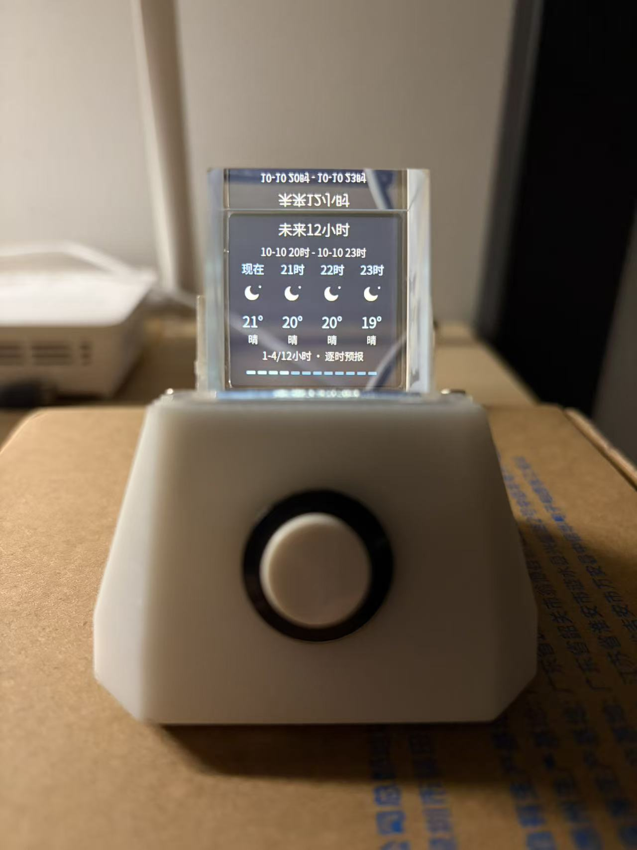
docs/images/2026-10-10/weather-hourly.jpg
