LighthouseXy/VoxConductor/docs/images/2026-10-10/weather-metrics.jpg

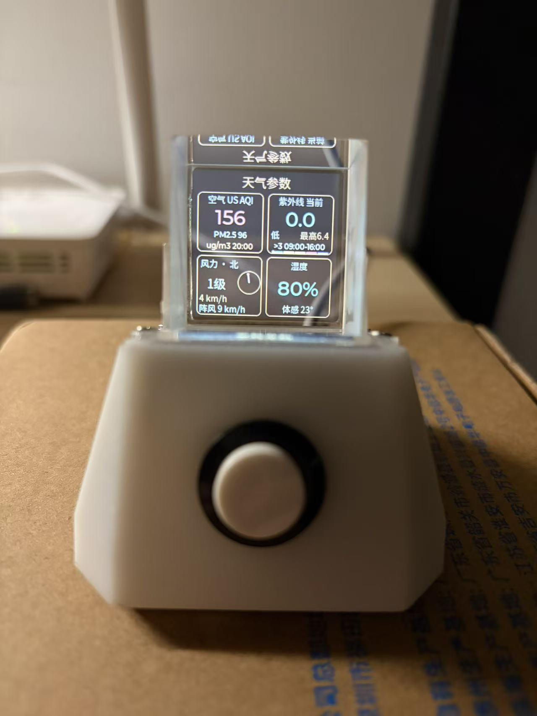
docs/images/2026-10-10/weather-metrics.jpg
