LighthouseXy/VoxConductor/docs/images/2026-10-11/device-side-slot.jpg

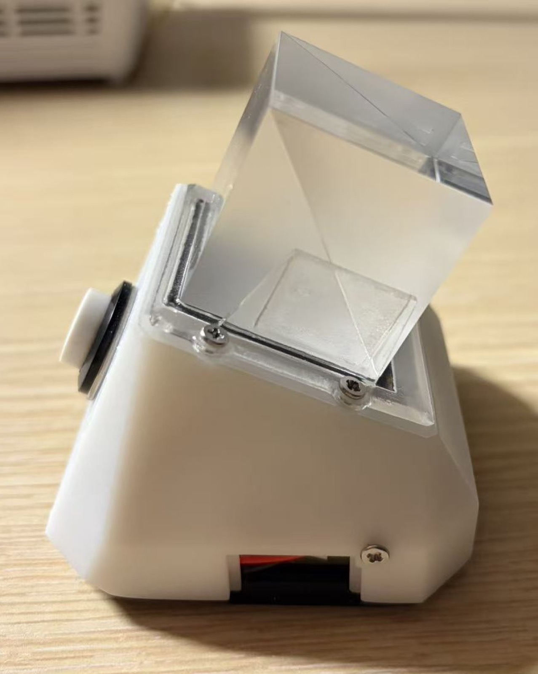
docs/images/2026-10-11/device-side-slot.jpg
