LighthouseXy/VoxConductor/docs/images/2026-10-11/web-tasks-desktop.jpg

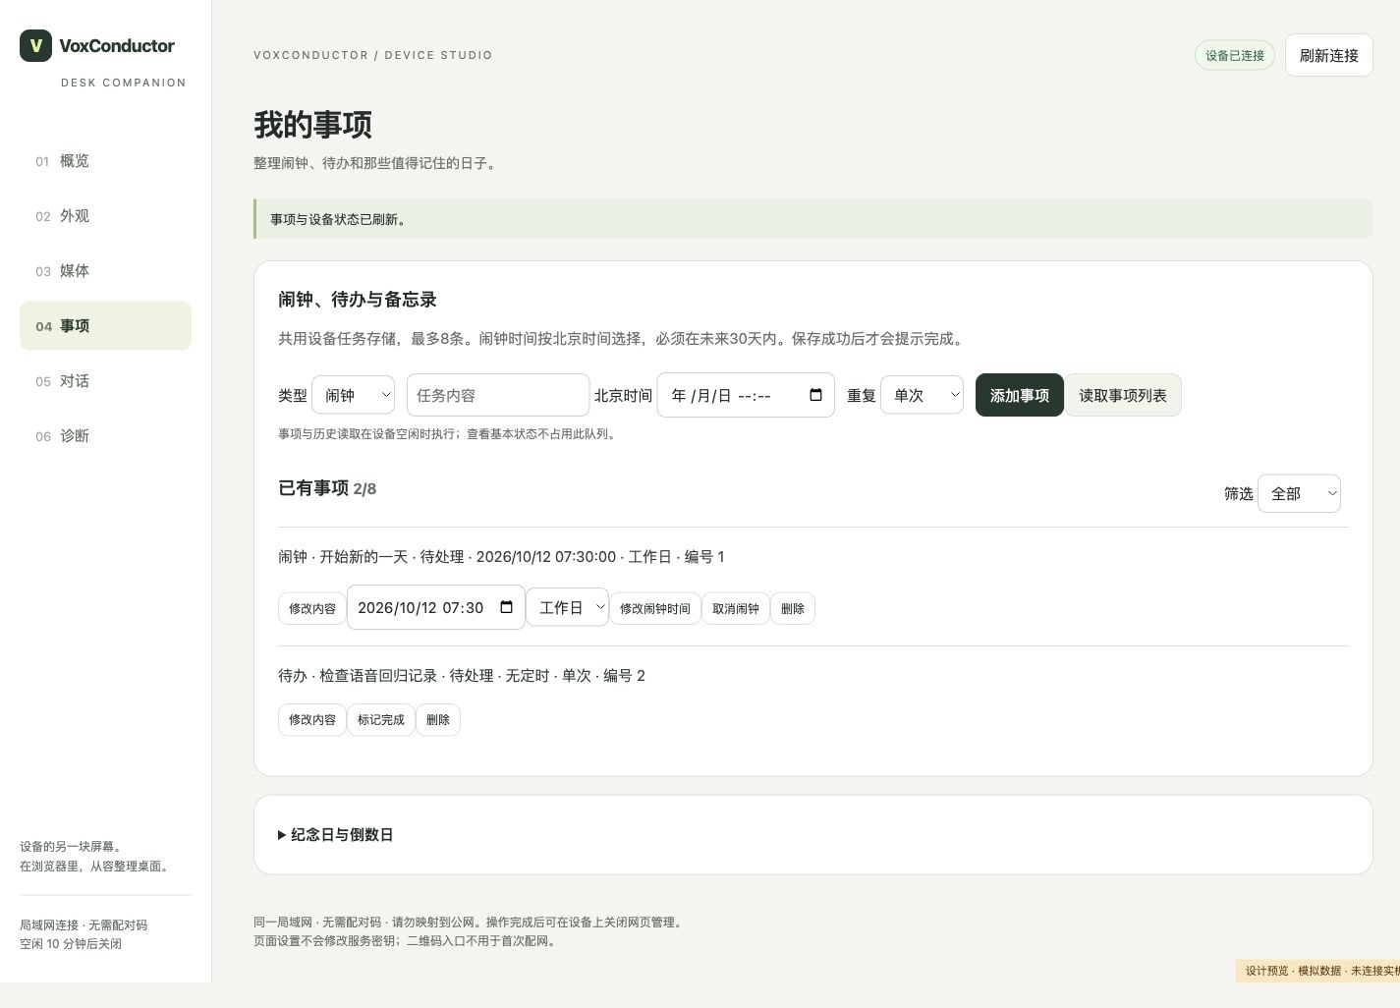
docs/images/2026-10-11/web-tasks-desktop.jpg
