LighthouseXy/VoxConductor/docs/images/2026-10-11/web-voice-settings-mobile.jpg

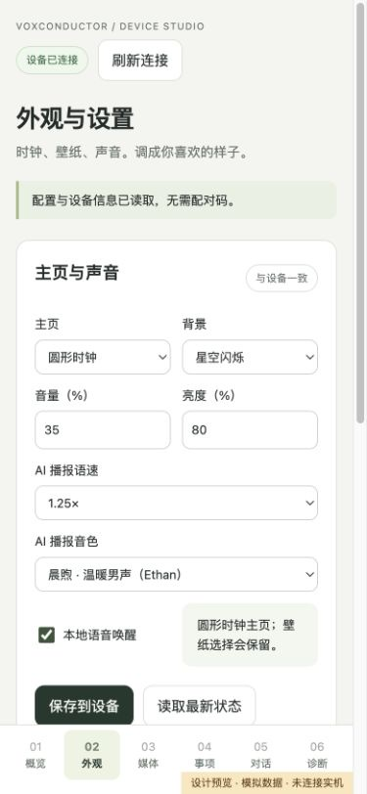
docs/images/2026-10-11/web-voice-settings-mobile.jpg
