LighthouseXy/VoxConductor/docs/images/context-dialog-turns-1-2.png

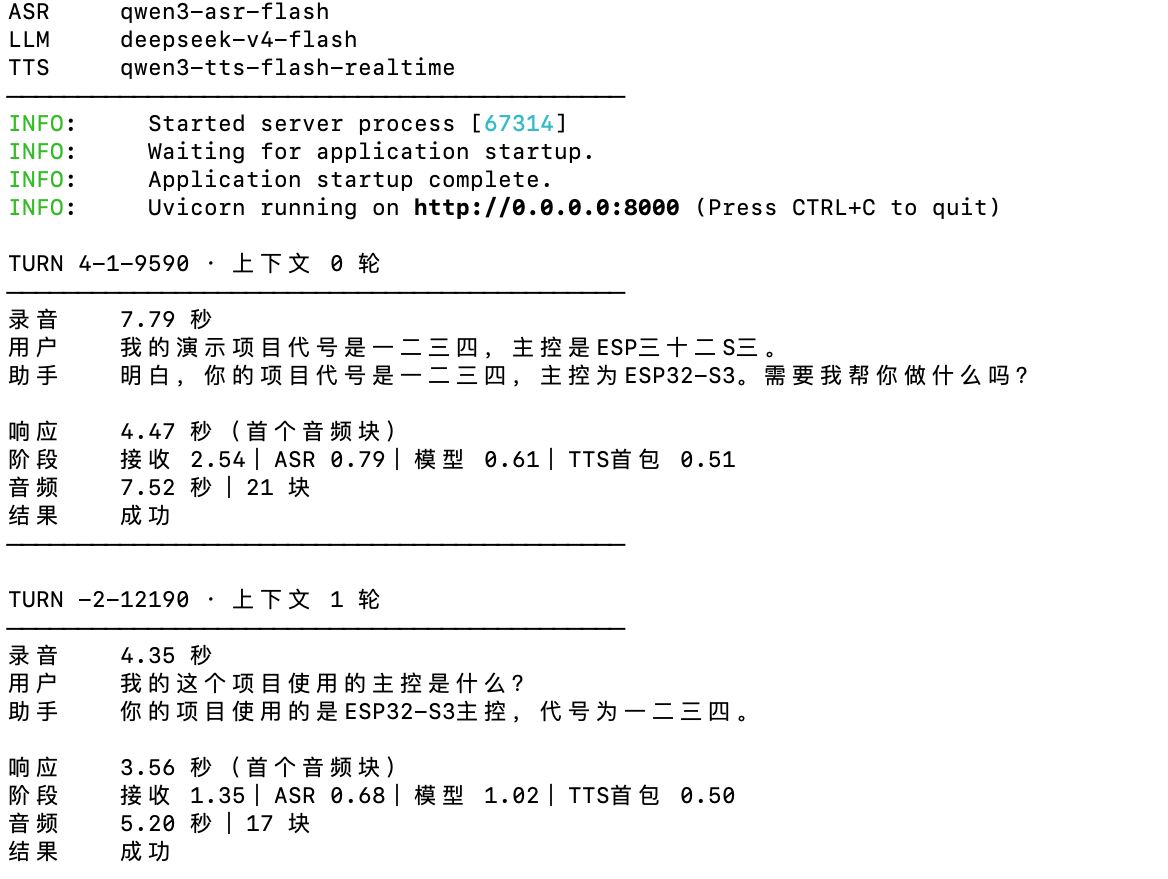
docs/images/context-dialog-turns-1-2.png
