LighthouseXy/VoxConductor/docs/images/context-dialog-turns-3-4.png

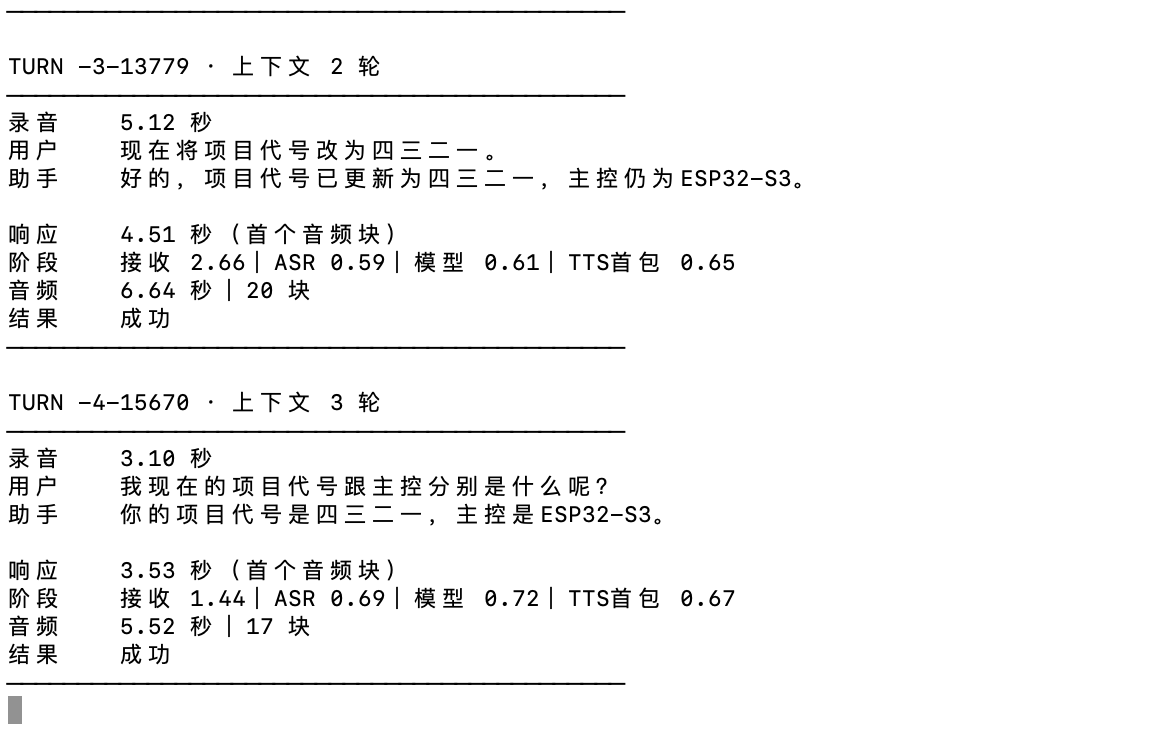
docs/images/context-dialog-turns-3-4.png
