LighthouseXy/VoxConductor/docs/images/home-page.jpg

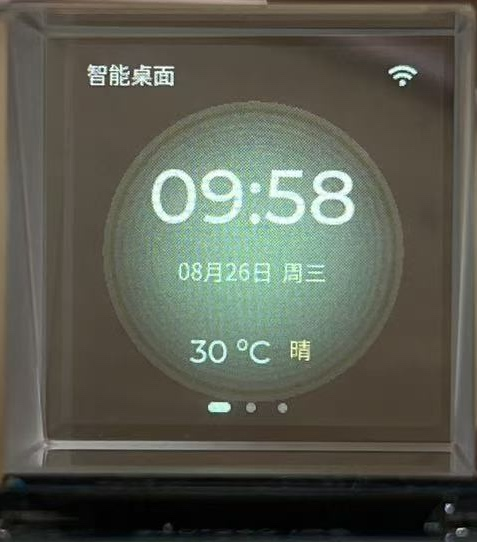
docs/images/home-page.jpg
