LighthouseXy/VoxConductor/docs/images/voice-listening.jpg

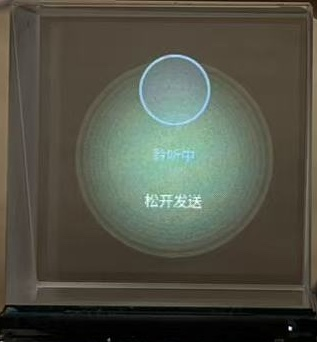
docs/images/voice-listening.jpg
