LighthouseXy/VoxConductor/docs/images/voice-ready.jpg

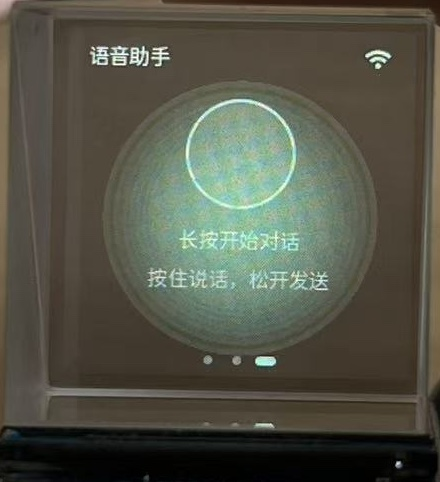
docs/images/voice-ready.jpg
