LighthouseXy/VoxConductor/docs/images/voice-speaking.jpg

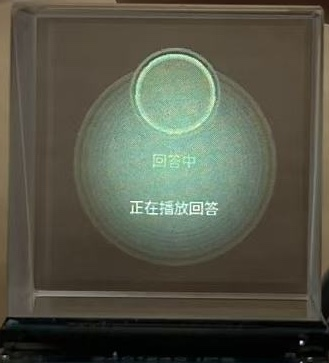
docs/images/voice-speaking.jpg
