LighthouseXy/VoxConductor/docs/images/voice-thinking.jpg

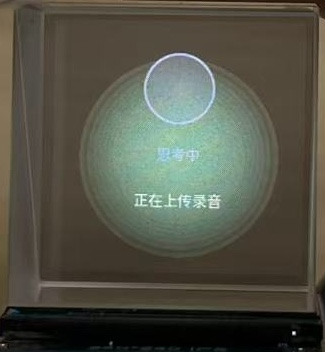
docs/images/voice-thinking.jpg
