LighthouseXy/VoxConductor/docs/images/voxconductor-prototype.jpg

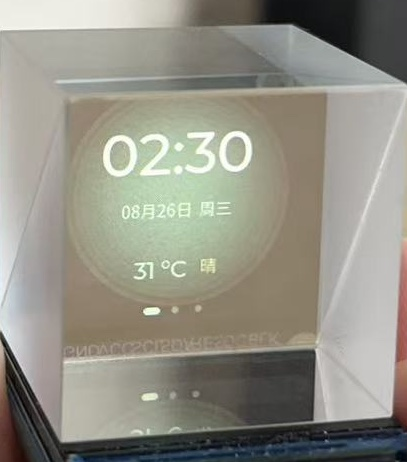
docs/images/voxconductor-prototype.jpg
