LighthouseXy/VoxConductor/docs/images/weather-page.jpg

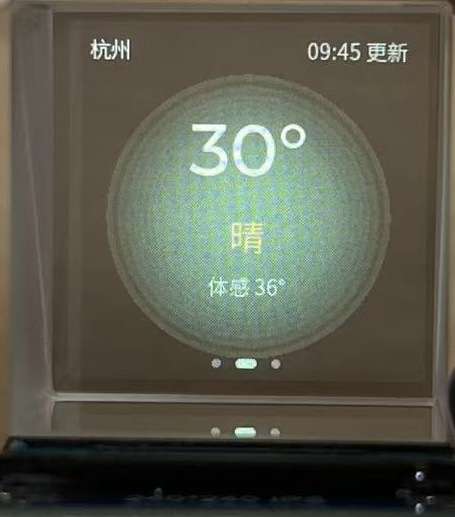
docs/images/weather-page.jpg
