LighthouseXy/VoxConductor/hardware/docs/display/T154H7-C12-01-V2/产品正反图.png

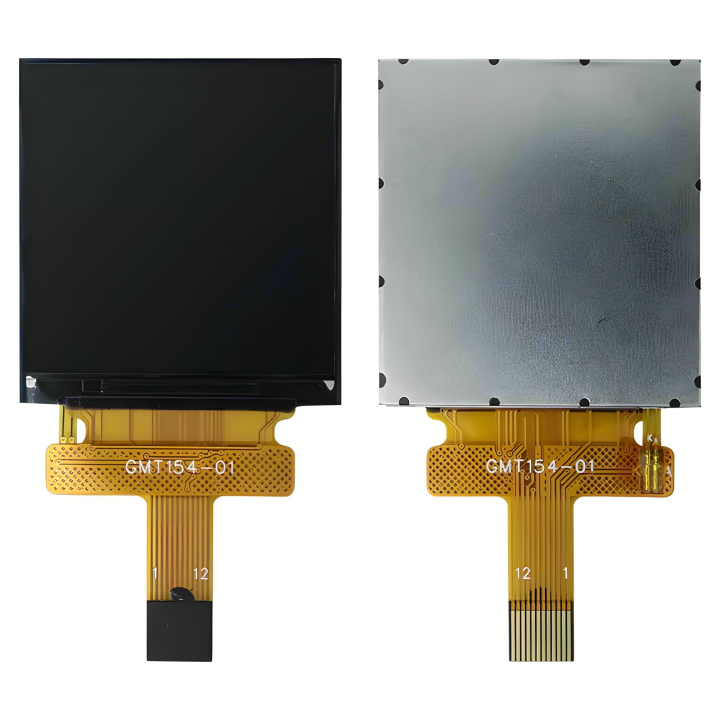
hardware/docs/display/T154H7-C12-01-V2/产品正反图.png
