LighthouseXy/VoxConductor/hardware/mechanical/V3-SLA/preview/03_board_and_bosses.png

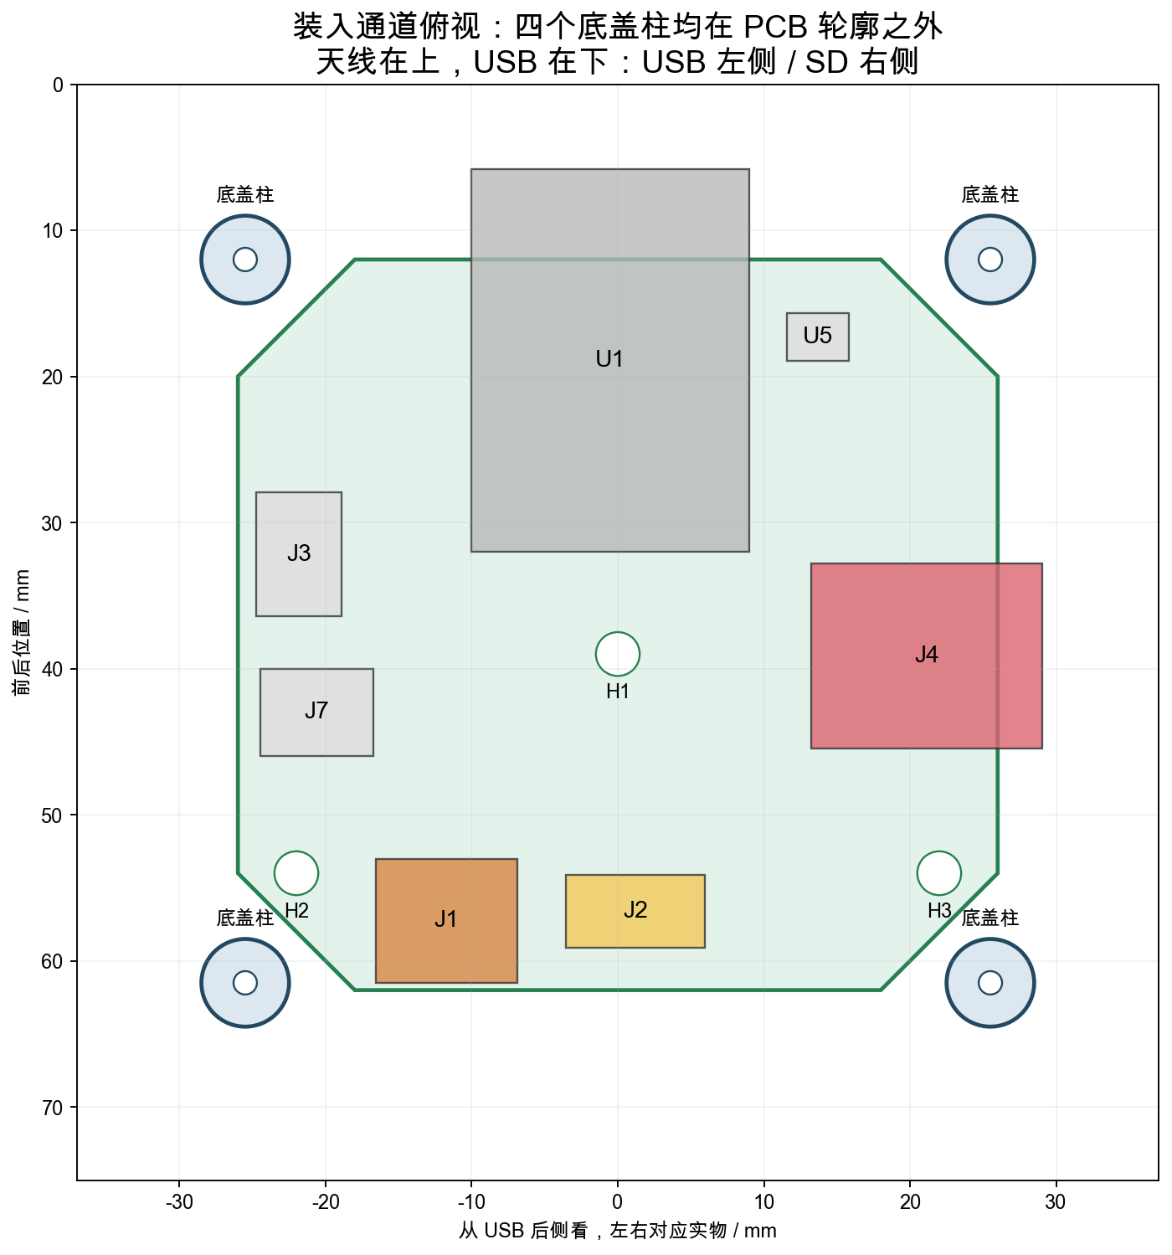
hardware/mechanical/V3-SLA/preview/03_board_and_bosses.png
