LighthouseXy/VoxConductor/hardware/BOM.md

# 定制 PCB 物料清单

更新：2026-10-11。此表对应仓库中的 KiCad 原理图，不是早期模块原型清单，也不是已完成采购审核的替代件清单。

我将原始分组 BOM 展开为逐位号明细，并与本次重新导出的 KiCad 网表核对：**61 个器件位置，59 个拟装配位置，C8、C9 两个 DNP 位置**。器件值与封装逐项一致；位号并不连续，不能按最大编号计算数量。

| 文件 | 用途 |
| --- | --- |
| [分组 BOM](exports/board-bom.csv) | 保留原理图的原始名称、分组、封装和 DNP 标记 |
| [逐位号 BOM](exports/board-bom-detailed.csv) | 每行一个位号，便于核对焊接、贴装和采购数量 |
| [原理图 PDF](exports/VoxConductor-schematic.pdf) | 核对网络连接和器件所在电路 |
| [制板坐标表](fabrication/2026-09-16/README.md) | 制造资料的入口；下单前重新核对修订版本 |

## 1. 数量汇总

| 类别 | 位置数 | 拟装配数 |
| --- | ---: | ---: |
| 电阻 R | 24 | 24 |
| 电容 C | 22 | 20 |
| IC / 主控模组 U | 6 | 6 |
| 连接器 J | 5 | 5 |
| 开关 SW | 2 | 2 |
| 电感 L | 1 | 1 |
| 三极管 Q | 1 | 1 |
| 合计 | 61 | 59 |

“拟装配”依据原理图 DNP 标记，不是对照片中每个焊点的验收结论。原理图内 R19、C16、J5、J6 等编号未出现，不自行补入物料。

## 2. 电阻

全部采用原理图指定的 0805 封装。此处仅统一大小写与单位；完整封装名见 CSV。

| 阻值 | 位号 | 数量 |
| --- | --- | ---: |
| 0 Ω | R20 | 1 |
| 10 Ω | R21 | 1 |
| 22 Ω | R6、R7、R16 | 3 |
| 1 kΩ | R22、R25 | 2 |
| 2.2 kΩ | R12 | 1 |
| 4.7 kΩ | R9、R10 | 2 |
| 5.1 kΩ | R4、R5 | 2 |
| 10 kΩ | R1、R8、R13–R15、R17、R18、R23、R24 | 9 |
| 100 kΩ | R3、R11 | 2 |
| 453 kΩ | R2 | 1 |

## 3. 电容

| 容值 | 位号 | 封装 | 数量 | 装配 |
| --- | --- | --- | ---: | --- |
| 6.8 pF | C4 | 0805 | 1 | 装配 |
| 2.2 nF | C15 | 0805 | 1 | 装配 |
| 10 nF | C13 | 0805 | 1 | 装配 |
| 100 nF / 0.1 µF | C1、C6、C11、C12、C14、C17–C19、C21、C23 | 0805 | 10 | 装配 |
| 1 µF | C7 | 0805 | 1 | 装配 |
| 10 µF | C2、C5、C10、C20、C22 | 1206 | 5 | 装配 |
| 22 µF | C3 | 1206 | 1 | 装配 |
| 未指定容值 | C8、C9 | 0805 | 2 | DNP，不装配 |

## 4. 主控、IC 与其他板载元件

| 位号 | 原理图型号 / 值 | 职责或封装依据 |
| --- | --- | --- |
| U1 | ESP32-S3-WROOM-1 | 主控、Wi-Fi；项目定制焊盘。完整模组后缀待补，不由名称推断 Flash/PSRAM 容量 |
| U2 | TLV62569DBV | 降压电源，SOT-23-5 |
| U3 | MPU-6050 | 姿态传感器，QFN-24，4 × 4 mm |
| U4 | USBLC6-2SC6 | USB 接口静电保护，SOT-23-6 |
| U5 | INMP441ACEZ-R7 | 数字 MEMS 麦克风，项目封装 |
| U6 | MAX98357AETE+T | I2S 输入功放，TQFN-16，3 × 3 mm |
| L1 | 2.2 µH | 采用 Bourns SRN4018 封装；不是完整电感采购型号 |
| Q1 | SS8050 | 三极管，SOT-23；替换时必须核对引脚定义 |
| SW1、SW2 | TS-1088-AR02016 | 板载按键开关，共 2 个 |

## 5. 连接器

| 位号 | 原理图值 / 封装依据 | 数量 |
| --- | --- | ---: |
| J1 | USB-C USB2.0 16P；HRO TYPE-C-31-M-12 封装 | 1 |
| J2 | Hirose FH12-12S-0.5SVA(54)，12P、0.5 mm、立式 | 1 |
| J3 | Molex PicoBlade 53261-0271，2P、1.25 mm | 1 |
| J4 | microSD 卡座，Molex 104031-0811 封装 | 1 |
| J7 | JST S2B-PH-K-S(LF)(SN)，2P、2.0 mm | 1 |

J2 实物曾旋转 180° 返修，尚未写回当前 KiCad 文件。下一次制板前必须修订并重新核对 FPC 针序、接触面及插座方向，不能直接复用现有制造包。

## 6. 整机材料与采购前检查

PCB BOM 不包含屏幕、分光棱镜、扬声器、外接操作按键、外壳、透明支架、线束、螺钉与 SD 卡。这些按整机材料记录在 [硬件设计与装配](../docs/HARDWARE_DESIGN.md#4-装配部件每一部分负责什么)，不与板载电子元器件混计。

目前仍需补齐：无源元件的额定电压、容差、介质及功率；电感的完整料号、额定/饱和电流；模组完整后缀；连接器的实际采购型号和供应商。不能仅凭“0805、10 kΩ”就确认替代件。采购前按电路电压、电源负载、封装焊盘和数据手册逐项核对，再将确认过的料号写入新的采购版本。

[硬件工程](README.md) · [电气与 GPIO](../docs/HARDWARE_V1.md)
