LighthouseXy/VoxConductor/hardware/exports/board-bom-detailed.csv

Ref | Value | Footprint | Populate
C1 | 0.1uF | Capacitor_SMD:C_0805_2012Metric_Pad1.18x1.45mm_HandSolder | yes
C2 | 10uF | Capacitor_SMD:C_1206_3216Metric_Pad1.33x1.80mm_HandSolder | yes
C3 | 22uF | Capacitor_SMD:C_1206_3216Metric_Pad1.33x1.80mm_HandSolder | yes
C4 | 6.8pF | Capacitor_SMD:C_0805_2012Metric_Pad1.18x1.45mm_HandSolder | yes
C5 | 10uF | Capacitor_SMD:C_1206_3216Metric_Pad1.33x1.80mm_HandSolder | yes
C6 | 0.1uF | Capacitor_SMD:C_0805_2012Metric_Pad1.18x1.45mm_HandSolder | yes
C7 | 1uF | Capacitor_SMD:C_0805_2012Metric_Pad1.18x1.45mm_HandSolder | yes
C8 | DNP | Capacitor_SMD:C_0805_2012Metric_Pad1.18x1.45mm_HandSolder | no
C9 | DNP | Capacitor_SMD:C_0805_2012Metric_Pad1.18x1.45mm_HandSolder | no
C10 | 10uF | Capacitor_SMD:C_1206_3216Metric_Pad1.33x1.80mm_HandSolder | yes
C11 | 0.1uF | Capacitor_SMD:C_0805_2012Metric_Pad1.18x1.45mm_HandSolder | yes
C12 | 0.1uF | Capacitor_SMD:C_0805_2012Metric_Pad1.18x1.45mm_HandSolder | yes
C13 | 10nF | Capacitor_SMD:C_0805_2012Metric_Pad1.18x1.45mm_HandSolder | yes
C14 | 0.1uF | Capacitor_SMD:C_0805_2012Metric_Pad1.18x1.45mm_HandSolder | yes
C15 | 2.2nF | Capacitor_SMD:C_0805_2012Metric_Pad1.18x1.45mm_HandSolder | yes
C17 | 0.1uF | Capacitor_SMD:C_0805_2012Metric_Pad1.18x1.45mm_HandSolder | yes
C18 | 0.1uF | Capacitor_SMD:C_0805_2012Metric_Pad1.18x1.45mm_HandSolder | yes
C19 | 0.1uF | Capacitor_SMD:C_0805_2012Metric_Pad1.18x1.45mm_HandSolder | yes
C20 | 10uF | Capacitor_SMD:C_1206_3216Metric_Pad1.33x1.80mm_HandSolder | yes
C21 | 0.1uF | Capacitor_SMD:C_0805_2012Metric_Pad1.18x1.45mm_HandSolder | yes
C22 | 10uF | Capacitor_SMD:C_1206_3216Metric_Pad1.33x1.80mm_HandSolder | yes
C23 | 100nF | Capacitor_SMD:C_0805_2012Metric_Pad1.18x1.45mm_HandSolder | yes
J1 | USB_C_Receptacle_USB2.0_16P | Connector_USB:USB_C_Receptacle_HRO_TYPE-C-31-M-12 | yes
J2 | FH12-12S-0.5SVA(54) | VoxConductor_Footprints:Hirose_FH12-12S-0.5SVA_Vertical | yes
J3 | 53261-0271 | Connector_Molex:Molex_PicoBlade_53261-0271_1x02-1MP_P1.25mm_Horizontal | yes
J4 | Micro_SD_Card_Det2 | Connector_Card:microSD_HC_Molex_104031-0811 | yes
J7 | S2B-PH-K-S(LF)(SN) | Connector_JST:JST_PH_S2B-PH-K_1x02_P2.00mm_Horizontal | yes
L1 | 2.2uH | Inductor_SMD:L_Bourns-SRN4018 | yes
Q1 | SS8050 | Package_TO_SOT_SMD:SOT-23 | yes
R1 | 10K | Resistor_SMD:R_0805_2012Metric_Pad1.20x1.40mm_HandSolder | yes
R2 | 453k | Resistor_SMD:R_0805_2012Metric_Pad1.20x1.40mm_HandSolder | yes
R3 | 100k | Resistor_SMD:R_0805_2012Metric_Pad1.20x1.40mm_HandSolder | yes
R4 | 5.1K | Resistor_SMD:R_0805_2012Metric_Pad1.20x1.40mm_HandSolder | yes
R5 | 5.1K | Resistor_SMD:R_0805_2012Metric_Pad1.20x1.40mm_HandSolder | yes
R6 | 22R | Resistor_SMD:R_0805_2012Metric_Pad1.20x1.40mm_HandSolder | yes
R7 | 22R | Resistor_SMD:R_0805_2012Metric_Pad1.20x1.40mm_HandSolder | yes
R8 | 10K | Resistor_SMD:R_0805_2012Metric_Pad1.20x1.40mm_HandSolder | yes
R9 | 4.7K | Resistor_SMD:R_0805_2012Metric_Pad1.20x1.40mm_HandSolder | yes
R10 | 4.7K | Resistor_SMD:R_0805_2012Metric_Pad1.20x1.40mm_HandSolder | yes
R11 | 100K | Resistor_SMD:R_0805_2012Metric_Pad1.20x1.40mm_HandSolder | yes
R12 | 2.2K | Resistor_SMD:R_0805_2012Metric_Pad1.20x1.40mm_HandSolder | yes
R13 | 10K | Resistor_SMD:R_0805_2012Metric_Pad1.20x1.40mm_HandSolder | yes
R14 | 10K | Resistor_SMD:R_0805_2012Metric_Pad1.20x1.40mm_HandSolder | yes
R15 | 10K | Resistor_SMD:R_0805_2012Metric_Pad1.20x1.40mm_HandSolder | yes
R16 | 22R | Resistor_SMD:R_0805_2012Metric_Pad1.20x1.40mm_HandSolder | yes
R17 | 10K | Resistor_SMD:R_0805_2012Metric_Pad1.20x1.40mm_HandSolder | yes
R18 | 10K | Resistor_SMD:R_0805_2012Metric_Pad1.20x1.40mm_HandSolder | yes
R20 | 0R | Resistor_SMD:R_0805_2012Metric_Pad1.20x1.40mm_HandSolder | yes
R21 | 10R | Resistor_SMD:R_0805_2012Metric_Pad1.20x1.40mm_HandSolder | yes
R22 | 1K | Resistor_SMD:R_0805_2012Metric_Pad1.20x1.40mm_HandSolder | yes
R23 | 10K | Resistor_SMD:R_0805_2012Metric_Pad1.20x1.40mm_HandSolder | yes
R24 | 10k | Resistor_SMD:R_0805_2012Metric_Pad1.20x1.40mm_HandSolder | yes
R25 | 1k | Resistor_SMD:R_0805_2012Metric_Pad1.20x1.40mm_HandSolder | yes
SW1 | TS-1088-AR02016 | Button_Switch_SMD:SW_SPST_TS-1088-xR020 | yes
SW2 | TS-1088-AR02016 | Button_Switch_SMD:SW_SPST_TS-1088-xR020 | yes
U1 | ESP32-S3-WROOM-1 | VoxConductor_Footprints:ESP32-S3-WROOM-1_Thermal_0p3 | yes
U2 | TLV62569DBV | Package_TO_SOT_SMD:SOT-23-5 | yes
U3 | MPU-6050 | Sensor_Motion:InvenSense_QFN-24_4x4mm_P0.5mm | yes
U4 | USBLC6-2SC6 | Package_TO_SOT_SMD:SOT-23-6 | yes
U5 | INMP441ACEZ-R7 | VoxConductor_Footprints:INMP441ACEZ-R7 | yes
U6 | MAX98357AETE+T | Package_DFN_QFN:TQFN-16-1EP_3x3mm_P0.5mm_EP1.23x1.23mm | yes
