LighthouseXy/VoxConductor/docs/images/2026-10-11/assembly-parts-angle.jpg

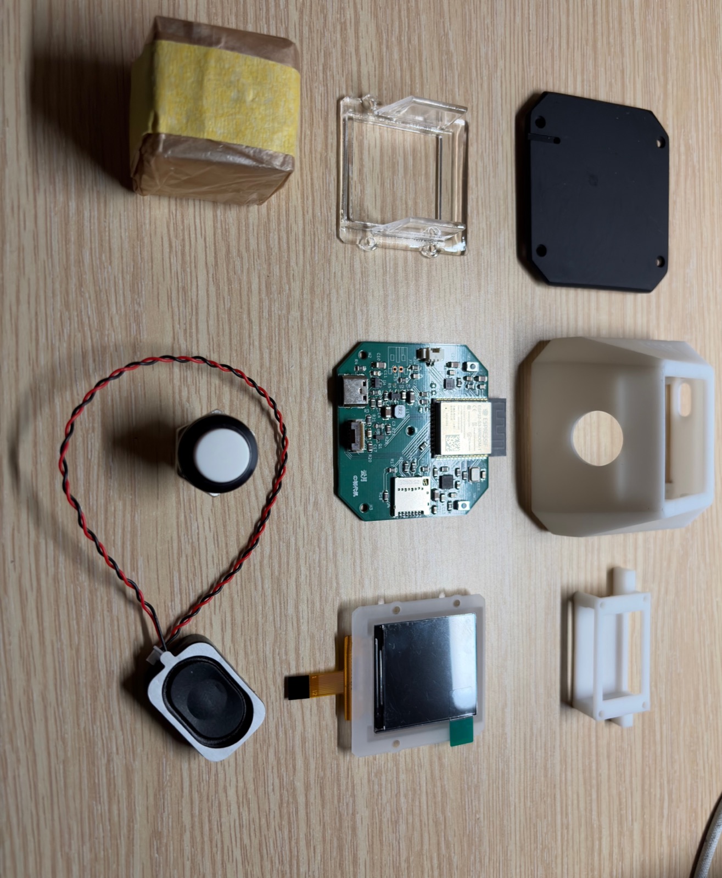
docs/images/2026-10-11/assembly-parts-angle.jpg
