LighthouseXy/VoxConductor/hardware/mechanical/V3-SLA/assembly/V3_assembly.FCStd

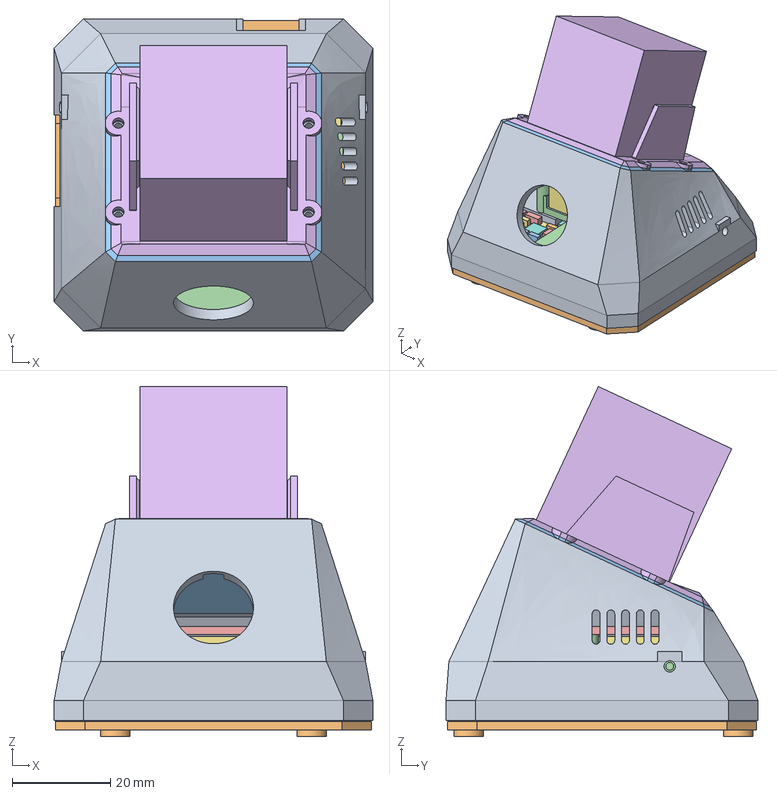
[picture p62: CAD file, 2026-10-10]
hardware/mechanical/V3-SLA/assembly/V3_assembly.FCStd
65.0 x 63.6 x 71.3 mm
01_main_shell
02_base
03_LCD_retainer
04_speaker_cradle
05_speaker_retainer
06_prism_carrier
PCB_reference
C17
R4
R9
C23
Q1
R1
R11
J1
U3
C14
R15
SW2
C6
C21
R21
R17
C2
J4
C20
C10
R8
R2
J3
R7
R24
C1
C18
U2
SW1
R10
U5
C7
U6
R18
J2
C15
U1
C22
R14
C13
U4
J7
R5
R6
R12
R3
R20
R22
C11
R23
C4
C19
C5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
