LighthouseXy/VoxConductor/hardware/mechanical/V3-SLA/parts/01_main_shell.step

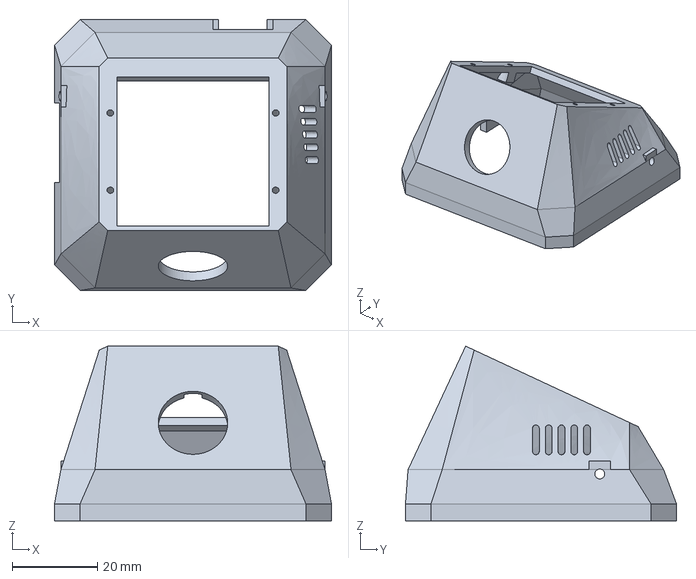
[picture p63: CAD file, 2026-10-10]
hardware/mechanical/V3-SLA/parts/01_main_shell.step
65.0 x 63.6 x 41.0 mm
