LighthouseXy/VoxConductor/hardware/mechanical/V3-SLA/source/frozen_v2/01_main_shell.step

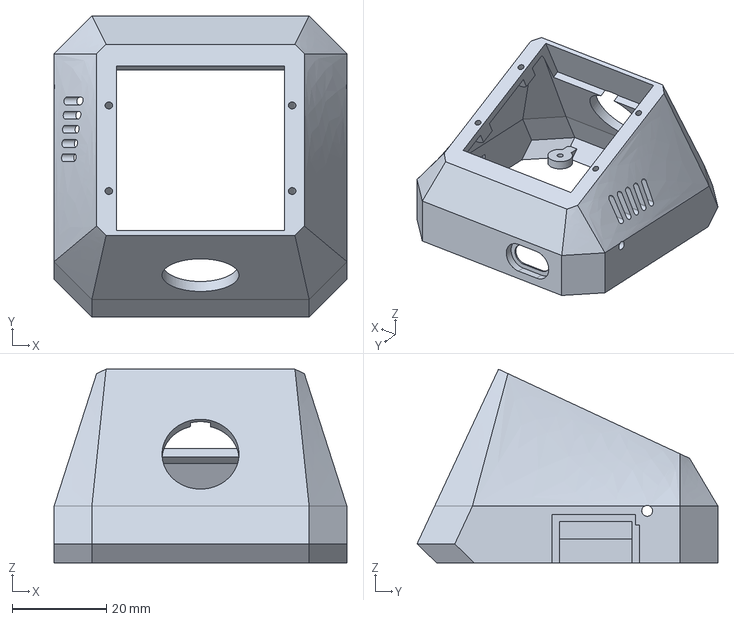
[picture p64: CAD file, 2026-10-10]
hardware/mechanical/V3-SLA/source/frozen_v2/01_main_shell.step
62.0 x 63.7 x 41.0 mm
