LighthouseXy/VoxConductor/hardware/mechanical/V3-SLA/parts/05_speaker_retainer.step

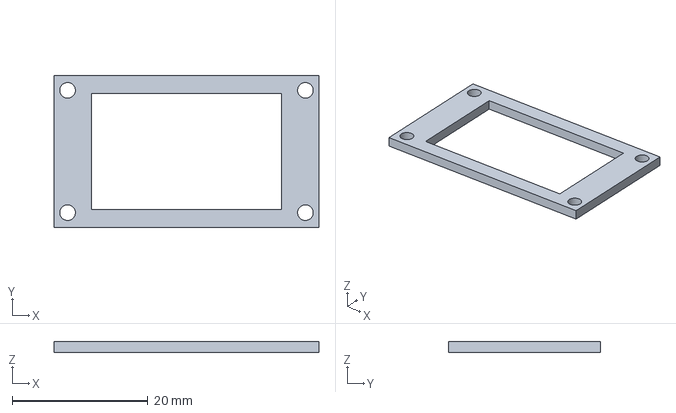
[picture p65: CAD file, 2026-10-10]
hardware/mechanical/V3-SLA/parts/05_speaker_retainer.step
39.0 x 22.4 x 1.60 mm
