LighthouseXy/VoxConductor/hardware/mechanical/V3-SLA/source/frozen_v2/06_prism_carrier.step

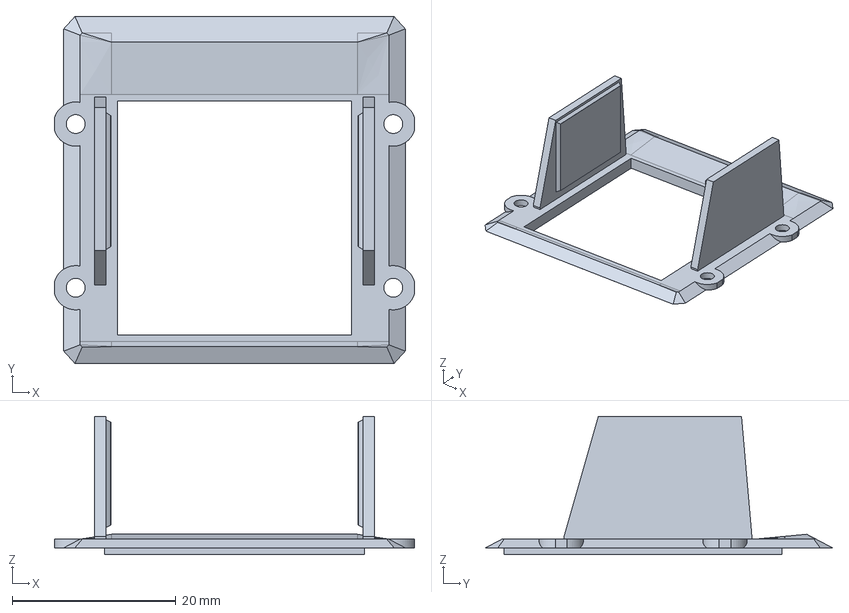
[picture p66: CAD file, 2026-10-10]
hardware/mechanical/V3-SLA/source/frozen_v2/06_prism_carrier.step
44.0 x 42.4 x 16.9 mm
