LighthouseXy/VoxConductor/hardware/mechanical/V3-SLA/trial/08_pilot_coupon_1p5_1p6_1p7.step

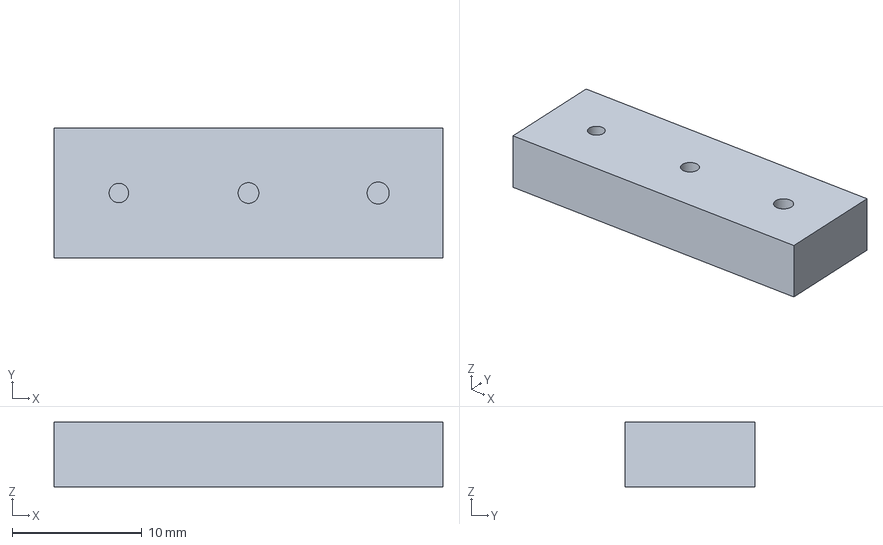
[picture p67: CAD file, 2026-10-10]
hardware/mechanical/V3-SLA/trial/08_pilot_coupon_1p5_1p6_1p7.step
30.0 x 10.0 x 5.00 mm
