LighthouseXy/VoxConductor/hardware/mechanical/V3-SLA/parts/03_LCD_retainer.step

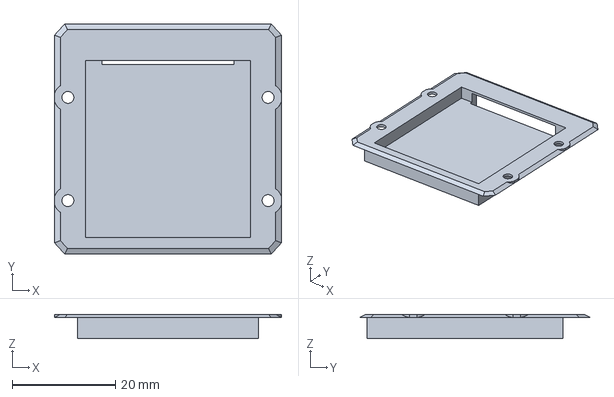
[picture p68: CAD file, 2026-10-10]
hardware/mechanical/V3-SLA/parts/03_LCD_retainer.step
44.0 x 44.7 x 4.70 mm
