LighthouseXy/VoxConductor/hardware/mechanical/V3-SLA/source/frozen_v2/04_speaker_cradle.step

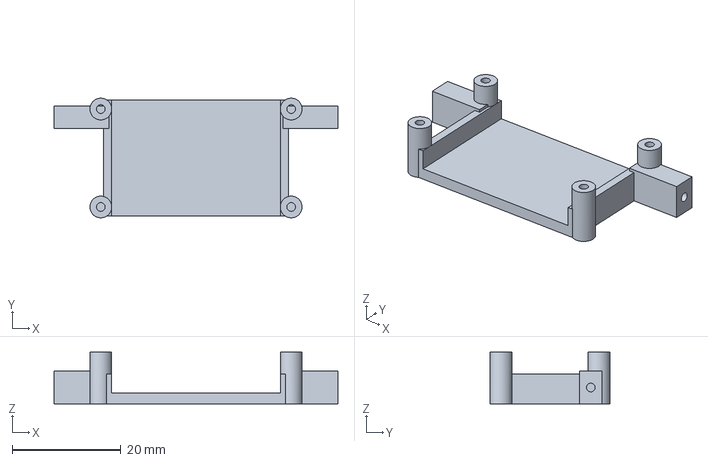
[picture p69: CAD file, 2026-10-10]
hardware/mechanical/V3-SLA/source/frozen_v2/04_speaker_cradle.step
52.2 x 22.0 x 9.50 mm
