LighthouseXy/VoxConductor/hardware/mechanical/V3-SLA/trial/07_entry_frame_first_print.step

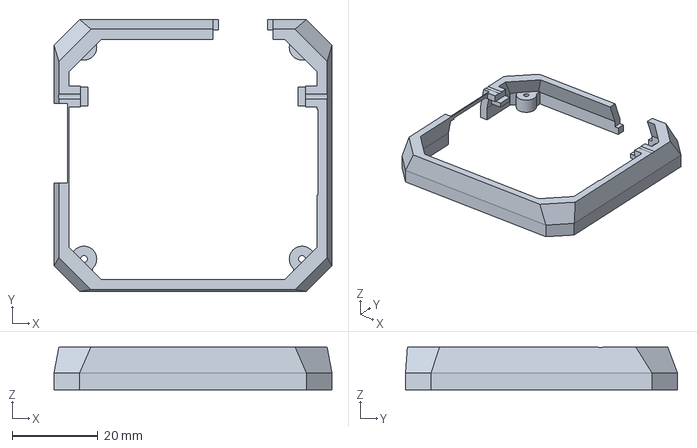
[picture p70: CAD file, 2026-10-10]
hardware/mechanical/V3-SLA/trial/07_entry_frame_first_print.step
65.0 x 63.6 x 10.0 mm
