LighthouseXy/VoxConductor/hardware/mechanical/V3-SLA/source/frozen_v2/02_base.step

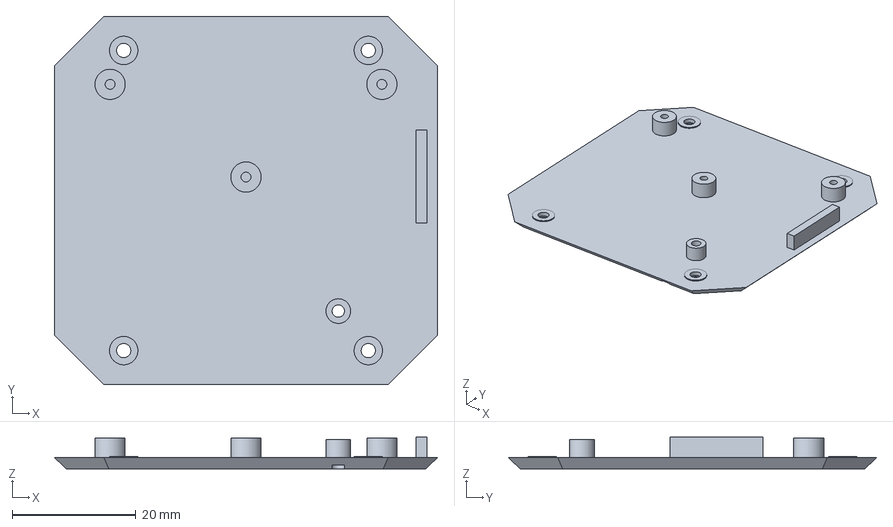
[picture p71: CAD file, 2026-10-10]
hardware/mechanical/V3-SLA/source/frozen_v2/02_base.step
62.0 x 59.6 x 5.10 mm
