LighthouseXy/VoxConductor/hardware/mechanical/V3-SLA/parts/02_base.step

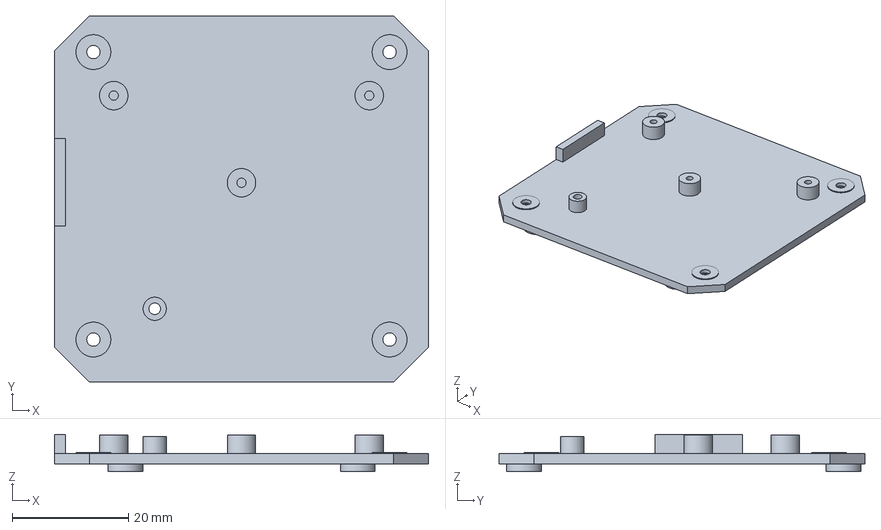
[picture p72: CAD file, 2026-10-10]
hardware/mechanical/V3-SLA/parts/02_base.step
64.4 x 63.0 x 6.40 mm
