LighthouseXy/VoxConductor/(list of files, cad)

Other CAD files:
hardware/mechanical/V3-SLA/assembly/V3_assembly_DO_NOT_PRINT.step
hardware/mechanical/V3-SLA/parts/04_speaker_cradle.step
hardware/mechanical/V3-SLA/parts/06_prism_carrier.step
hardware/mechanical/V3-SLA/source/frozen_v2/05_speaker_retainer.step
hardware/mechanical/V3-SLA/source/frozen_v2/03_LCD_retainer.step
hardware/mechanical/V3-SLA/print/01_main_shell.stl
hardware/mechanical/V3-SLA/print/02_base.stl
hardware/mechanical/V3-SLA/print/03_LCD_retainer.stl
hardware/mechanical/V3-SLA/print/04_speaker_cradle.stl
hardware/mechanical/V3-SLA/print/05_speaker_retainer.stl
hardware/mechanical/V3-SLA/print/06_prism_carrier.stl
hardware/mechanical/V3-SLA/trial/07_entry_frame_first_print.stl
hardware/mechanical/V3-SLA/trial/08_pilot_coupon_1p5_1p6_1p7.stl
