LighthouseXy/VoxConductor/hardware/fabrication/2026-09-16/制造说明.txt

VoxConductor 四层验证板 — 2026-09-16 最终复核版

层序：F.Cu / In1.Cu / In2.Cu / B.Cu。
单片板框：52 × 50 mm。板框中心线为准。
下单参考：FR-4，成品板厚 1.6 mm，外层 1 oz / 内层 0.5 oz，绿油白字，OSP；最终数量和订单参数由客户填写。
文件格式：RS-274X Gerber，钻孔为公制 Excellon，PTH / NPTH 分开。

过孔处理要求：
1. 普通双面不开窗的 0.30 mm 接地/信号过孔，按常规过孔塞油工艺制作；保留文件阻焊开窗，不得因塞油覆盖元件的焊接表面。
2. U1 外围 12 个 0.30 mm 接地/散热孔在钻孔文件中归类为 ComponentDrill，但同样是需要常规盖油/塞油处理的热孔；不是装元件引脚的孔。这些孔已移出 U1 中央焊盘开窗。
3. U6 中央焊盘已无孔，外侧两个 0.30 mm GND 孔采用常规双面盖油/塞油；不指定树脂填孔、电镀盖帽或铜浆塞孔。
4. J1 USB 固定镀槽附近原重叠的多余 0.30 mm 孔已删除。USB 固定焊盘保持常规开窗，四个镀槽保留，不盖油、不塞死。
5. USB/J7 等用于装配的镀孔和镀槽、全部 NPTH、麦克风 U5 声孔及螺丝孔保持通透；不得堵塞。
6. 请确认生产稿：若上述常规塞油要求与工艺能力不符，请在生产前反馈，不要自动升级收费工艺或扩大/删除元件焊盘开窗。

U5 麦克风声孔须保持无阻焊油墨、无锡膏及无塞孔材料堵塞。
钻孔核对：PTH 共 114 个（96 普通过孔＋12 U1 热孔＋4 USB 镀槽＋2 J7 引脚孔）；NPTH 共 6 个（麦克风声孔 1、USB 定位孔 2、安装孔 3）。
本包不指定差分阻抗控制服务；既有 USB 布线未在本次修改，功能和信号完整性留待样机验证。
