LighthouseXy/VoxConductor/docs/images/2026-10-10/pcb-assembled.jpg

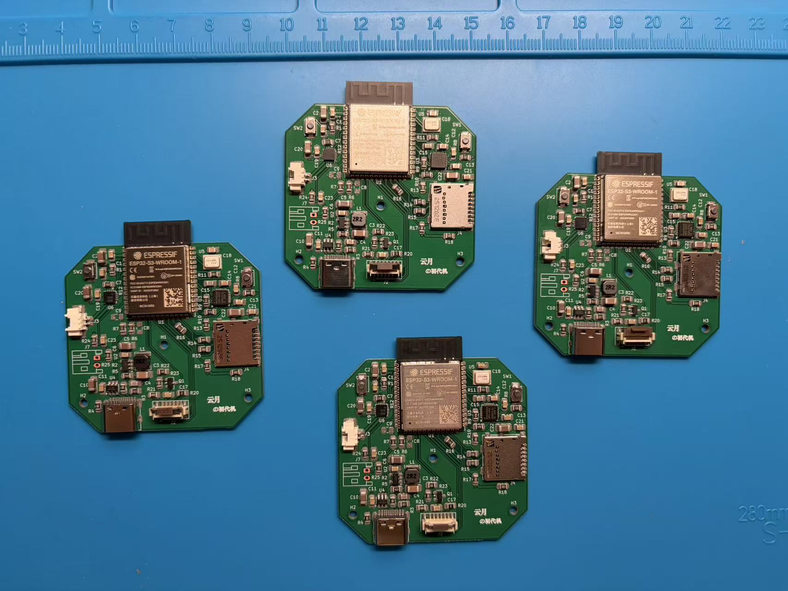
docs/images/2026-10-10/pcb-assembled.jpg
