LighthouseXy/VoxConductor/hardware/exports/VoxConductor-schematic.pdf

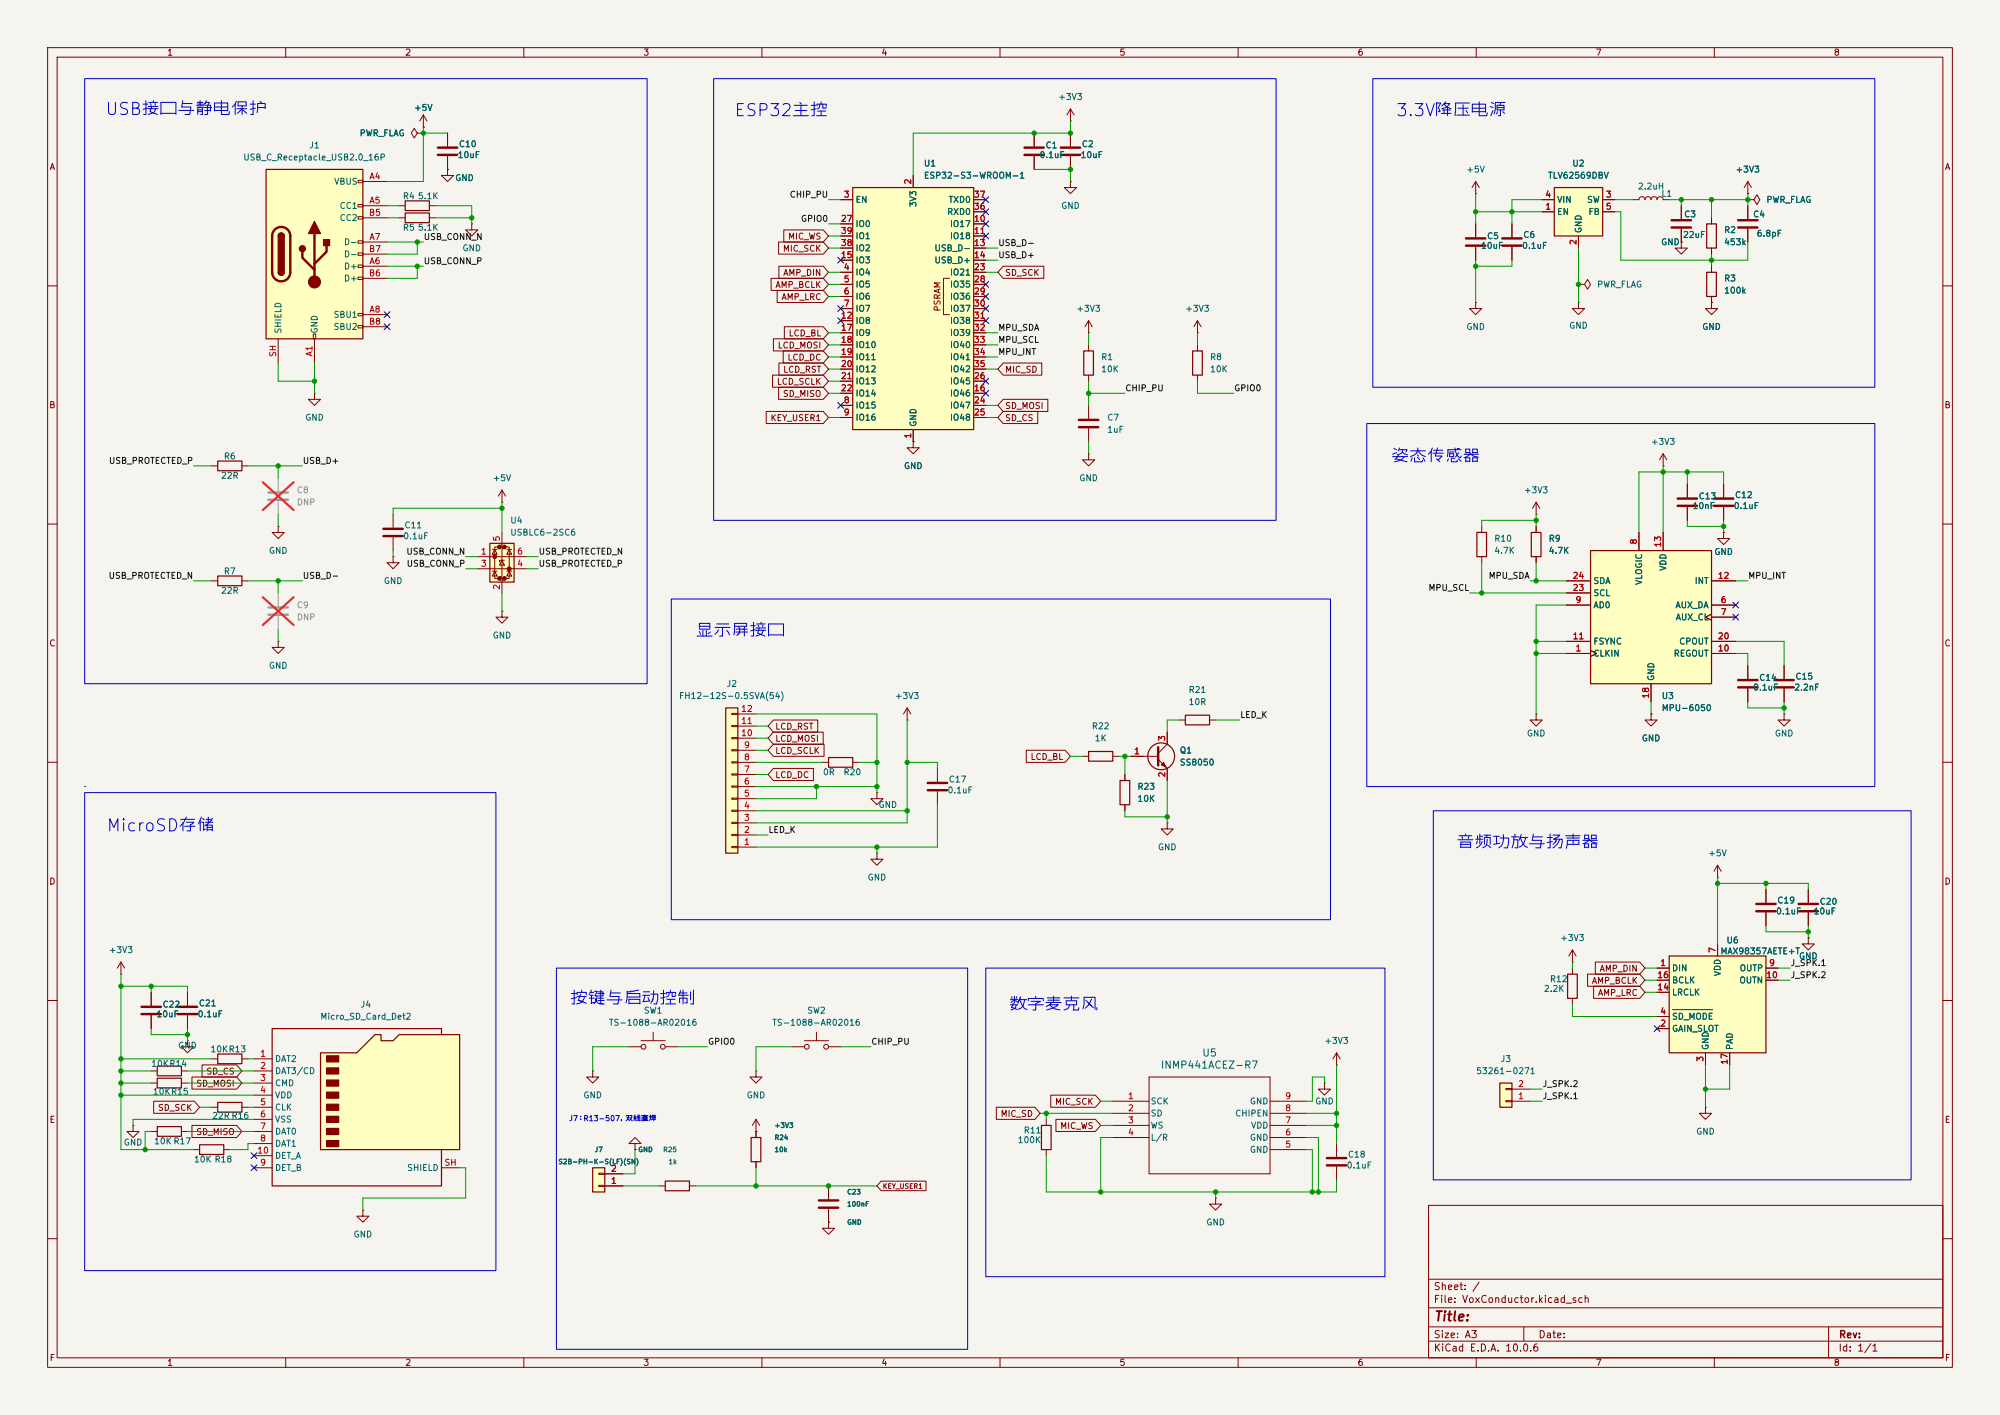
[picture p74: page 1]

Size: A3 | Rev: | F Date:
KiCad E.D.A. 10.0.6 | Id: 1/1
