LighthouseXy/VoxConductor/hardware/docs/display/FH12-SVA-EDC3-159266-03.pdf

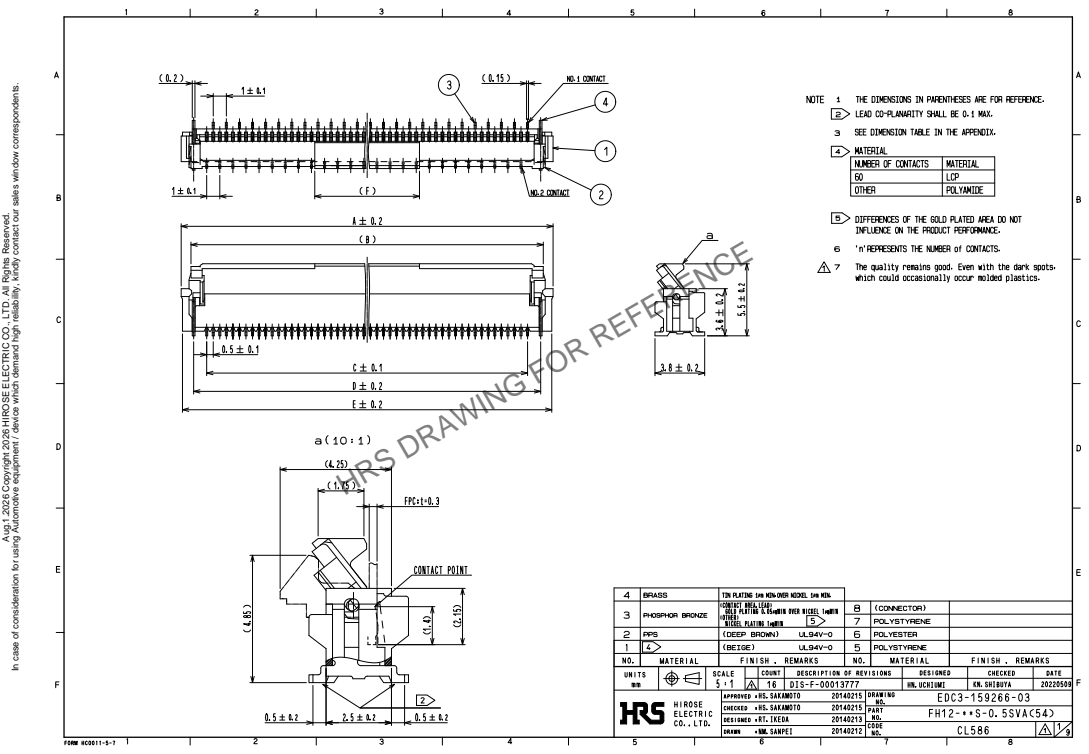
[picture p75: page 1]

HRS DRAWING FOR REFERENCE

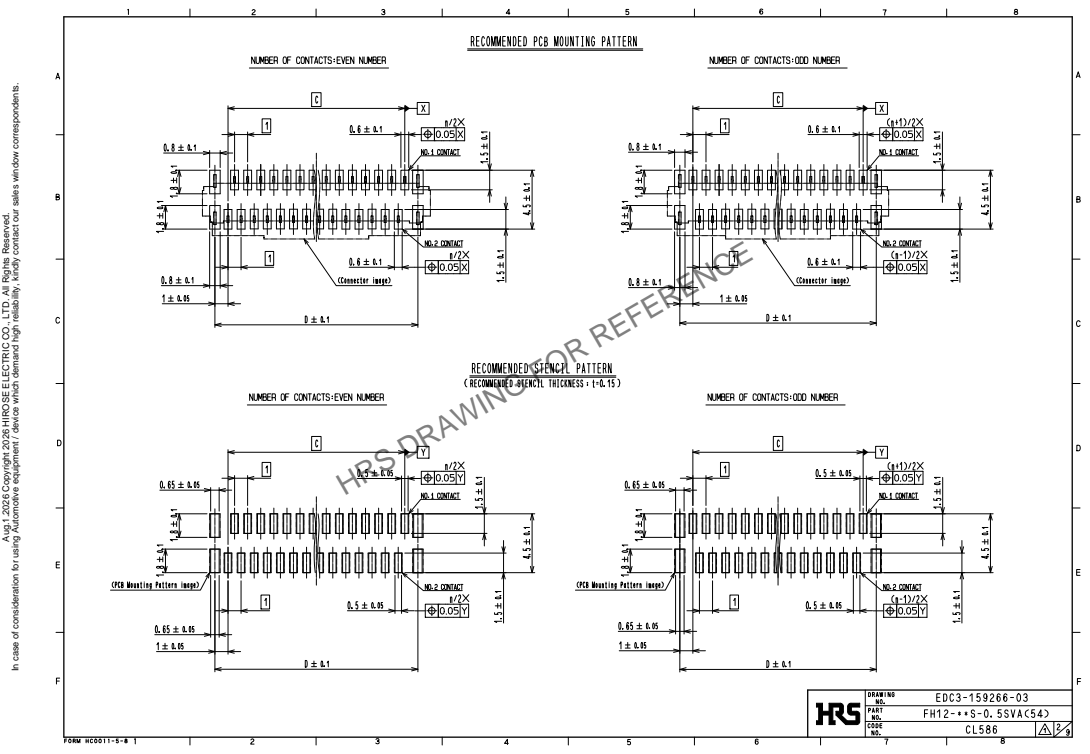
[picture p76: page 2]

HRS DRAWING FOR REFERENCE

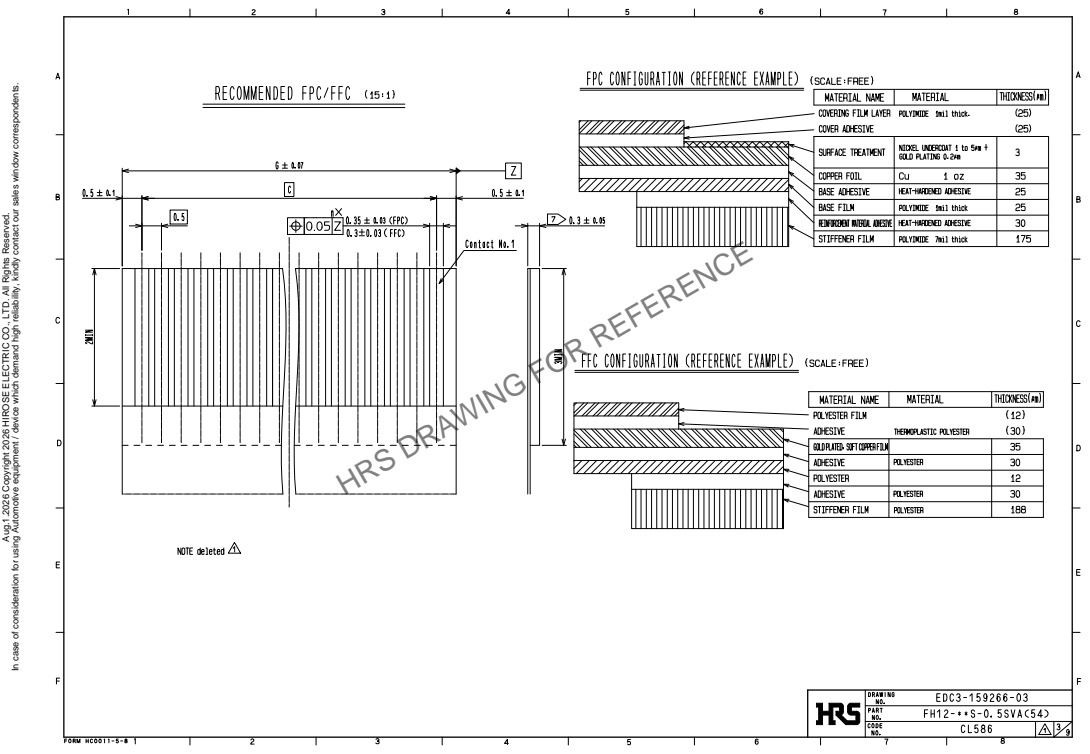
[picture p77: page 3]

HRS DRAWING FOR REFERENCE

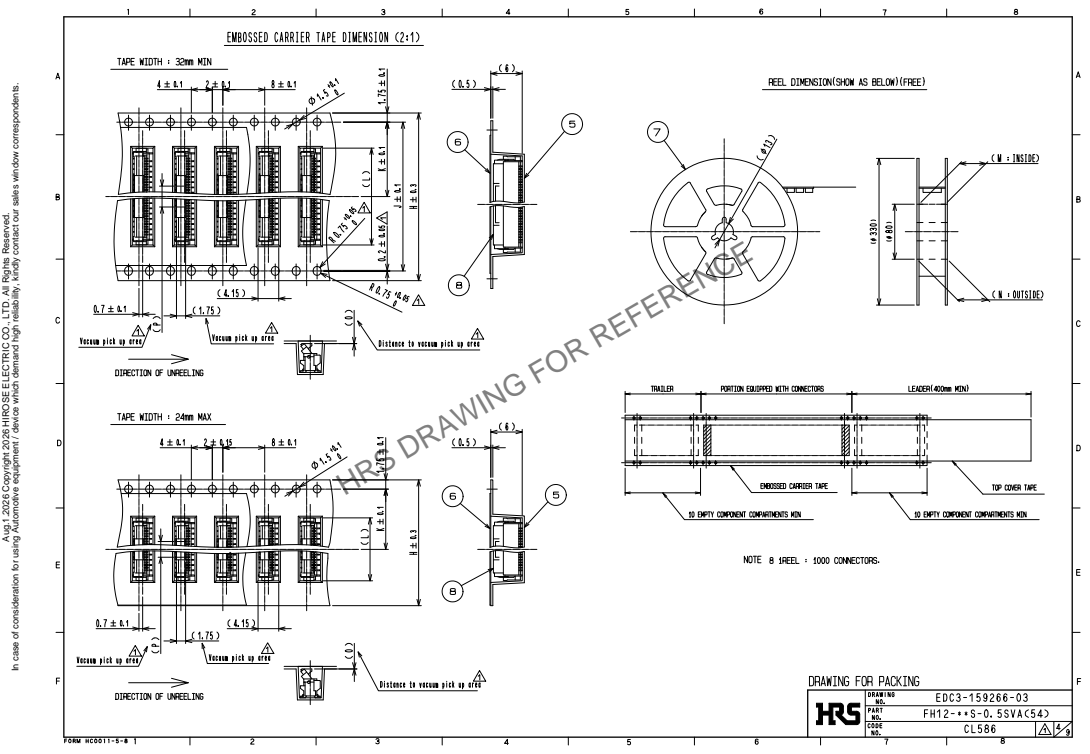
[picture p78: page 4]

HRS DRAWING FOR REFERENCE

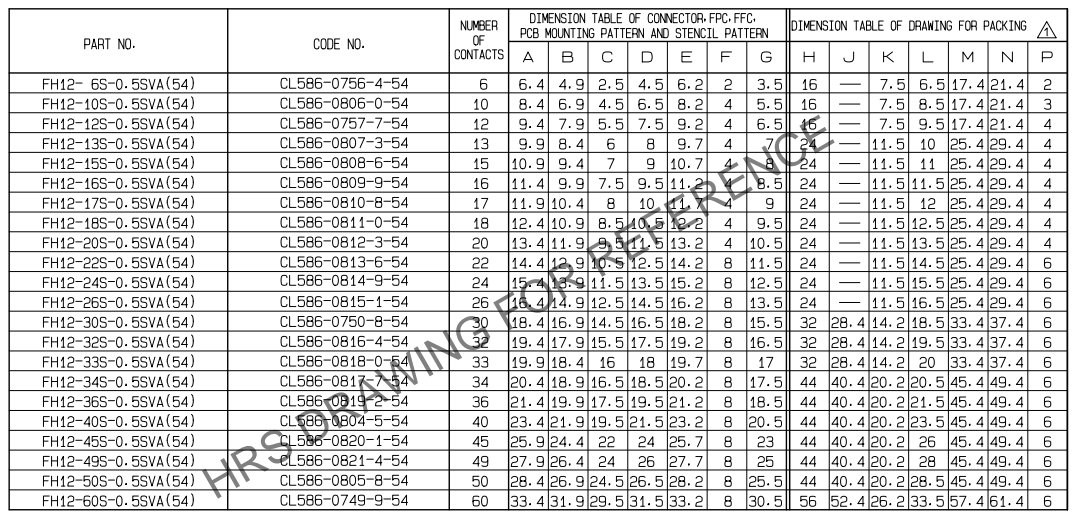
[picture p79: page 5]

HRS DRAWING FOR REFERENCE

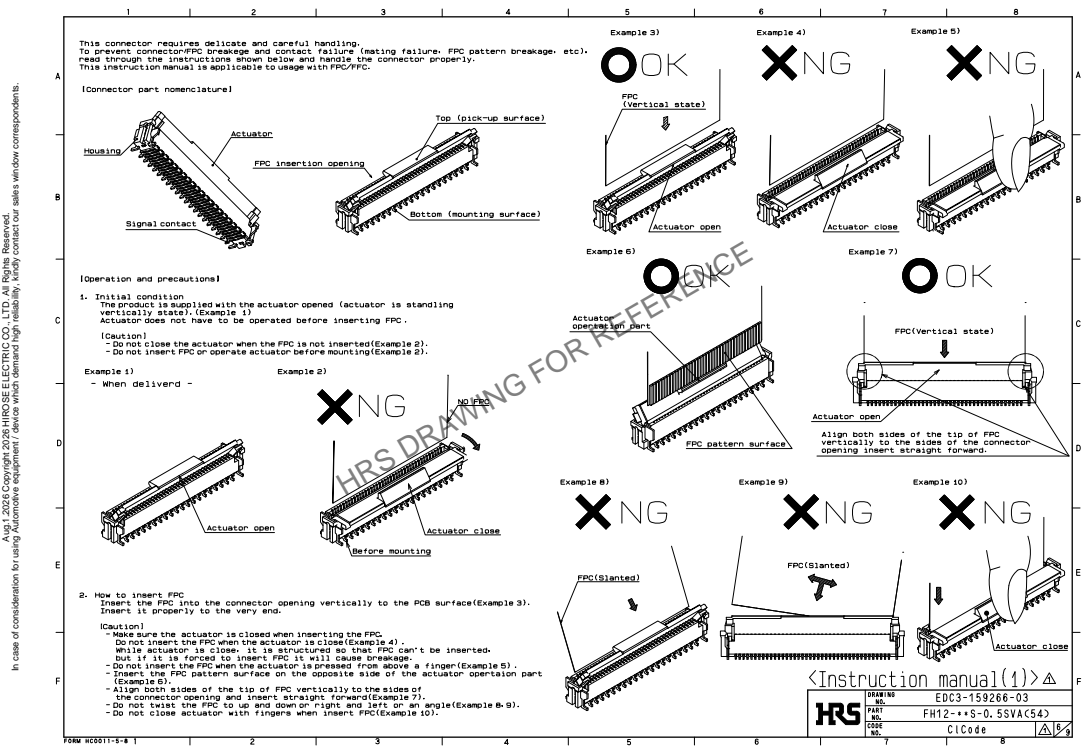
[picture p80: page 6]

HRS DRAWING FOR REFERENCE

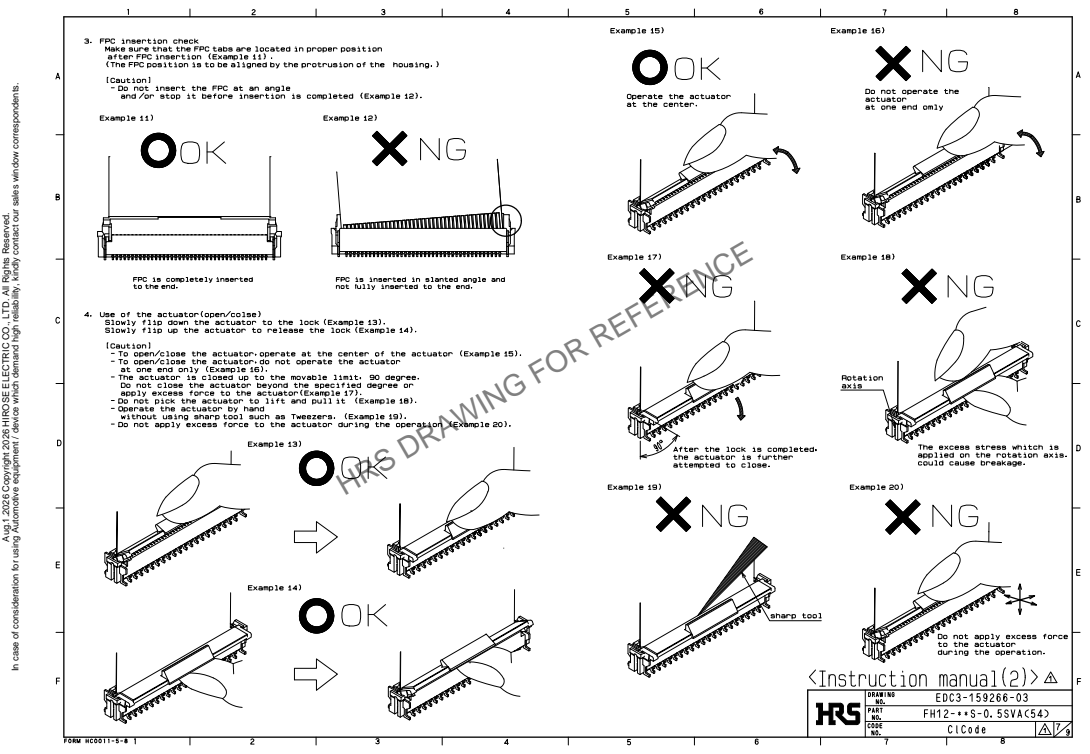
[picture p81: page 7]

HRS DRAWING FOR REFERENCE

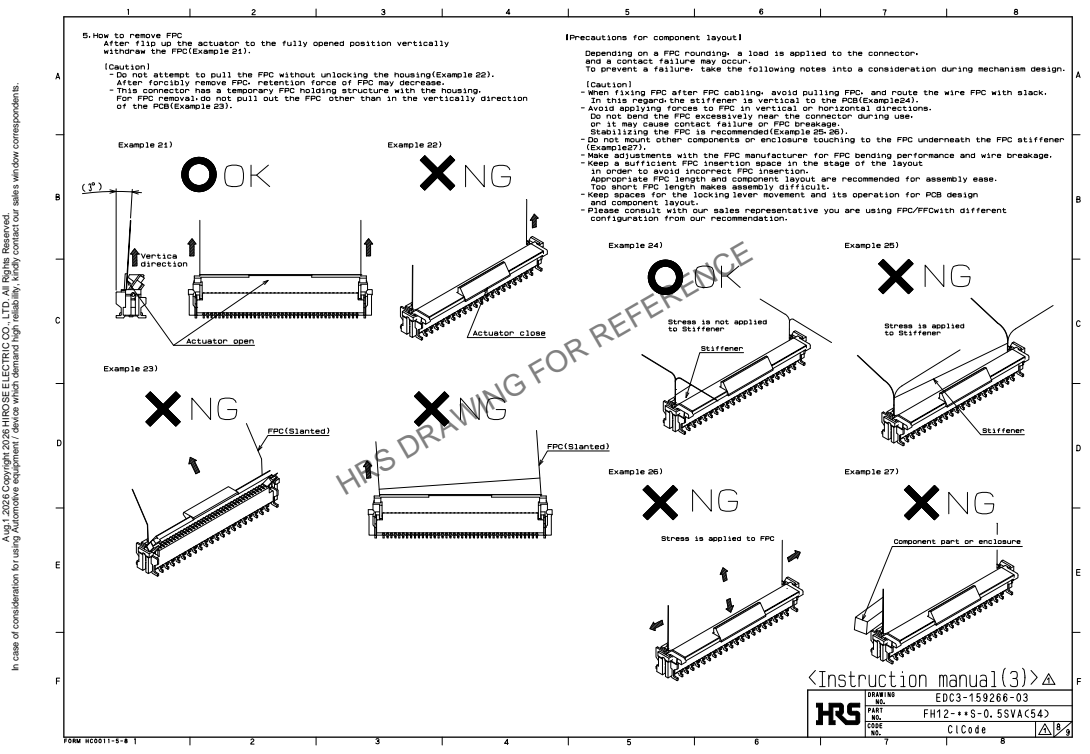
[picture p82: page 8]

HRS DRAWING FOR REFERENCE

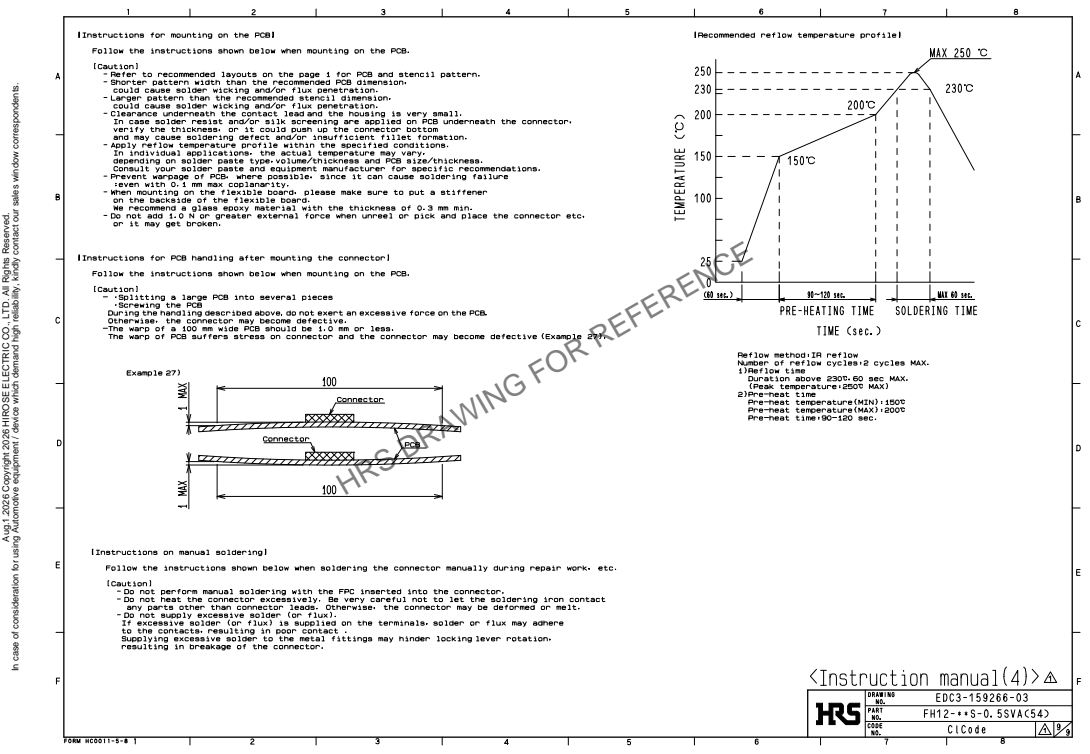
[picture p83: page 9]

HRS DRAWING FOR REFERENCE
