LighthouseXy/VoxConductor/(list of files, drawings)

Other design files:
hardware/mechanical/V3-SLA/source/pcb_actual.json
