LighthouseXy/VoxConductor/hardware/VoxConductor.kicad_pcb

## KiCad design hardware/VoxConductor.kicad_pcb (2026-10-10)

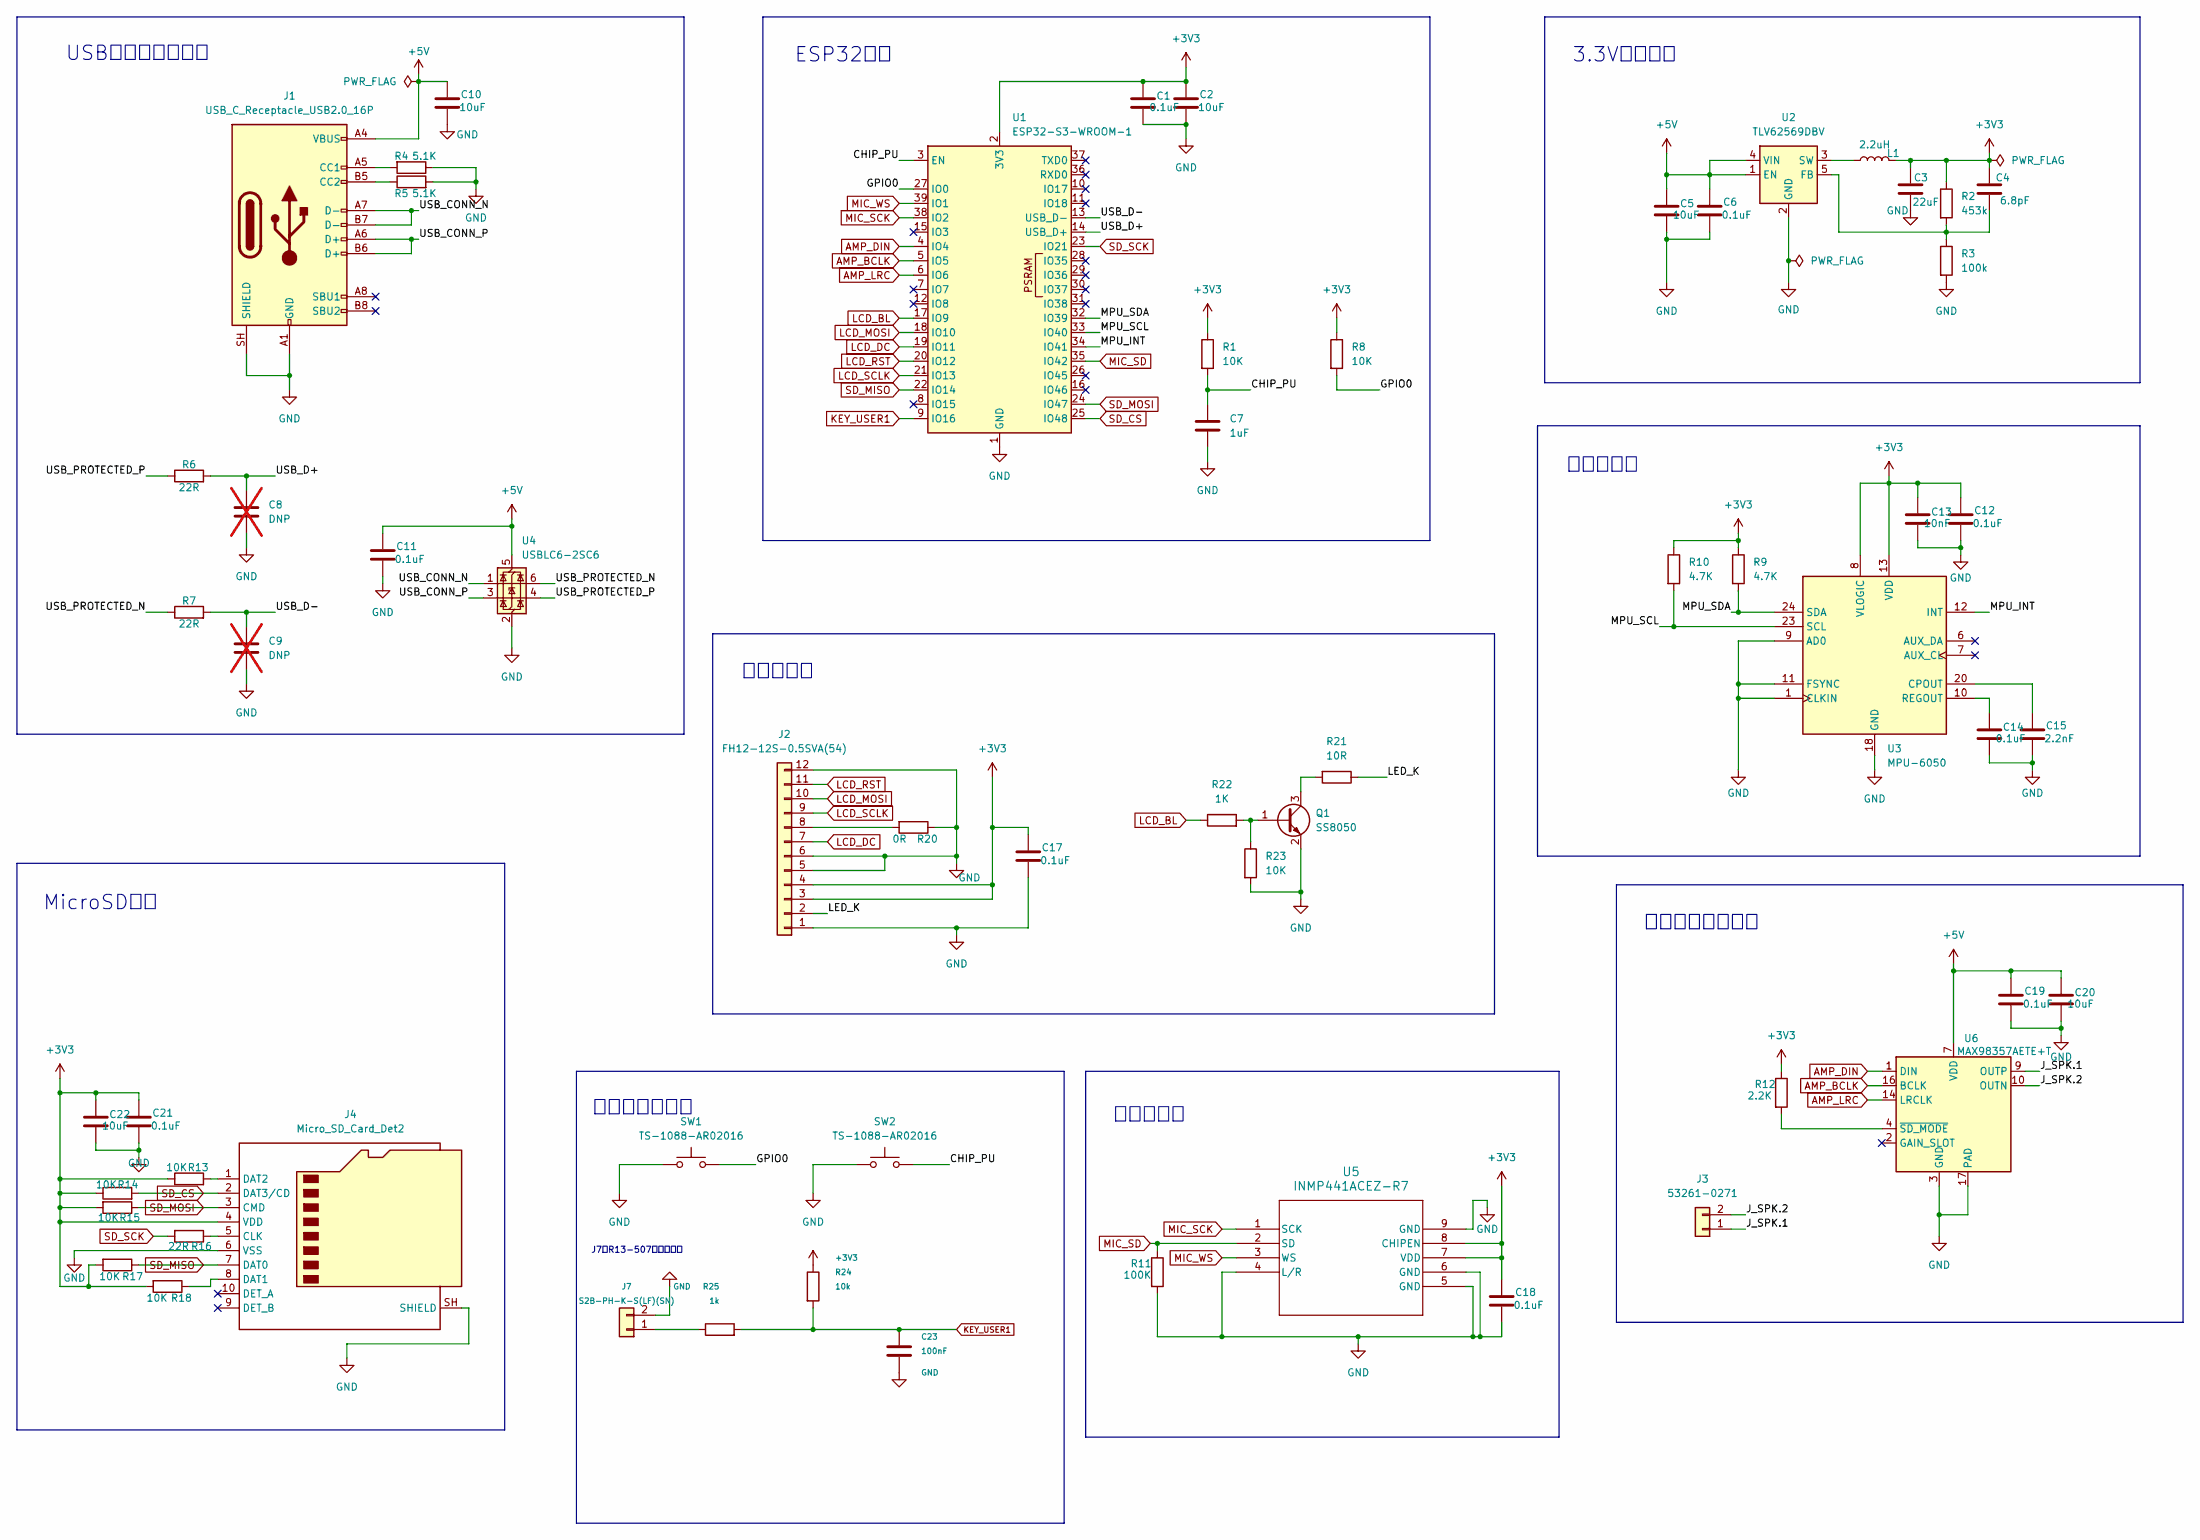
[picture p84: schematic VoxConductor.kicad_sch]

Parts:
C1, C6, C11, C12, C14, C17, C18, C19, C21: 0.1uF; C_0805_2012Metric_Pad1.18x1.45mm_HandSolder
C2, C5, C10, C20, C22: 10uF; C_1206_3216Metric_Pad1.33x1.80mm_HandSolder
C3: 22uF; C_1206_3216Metric_Pad1.33x1.80mm_HandSolder
C4: 6.8pF; C_0805_2012Metric_Pad1.18x1.45mm_HandSolder
C7: 1uF; C_0805_2012Metric_Pad1.18x1.45mm_HandSolder
C8, C9: DNP; C_0805_2012Metric_Pad1.18x1.45mm_HandSolder; not fitted
C13: 10nF; C_0805_2012Metric_Pad1.18x1.45mm_HandSolder
C15: 2.2nF; C_0805_2012Metric_Pad1.18x1.45mm_HandSolder
C23: 100nF; C_0805_2012Metric_Pad1.18x1.45mm_HandSolder
J1: USB_C_Receptacle_USB2.0_16P; USB_C_Receptacle_HRO_TYPE-C-31-M-12
J2: FH12-12S-0.5SVA(54); Hirose_FH12-12S-0.5SVA_Vertical
J3: 53261-0271; Molex_PicoBlade_53261-0271_1x02-1MP_P1.25mm_Horizontal
J4: Micro_SD_Card_Det2; microSD_HC_Molex_104031-0811
J7: S2B-PH-K-S(LF)(SN); JST_PH_S2B-PH-K_1x02_P2.00mm_Horizontal
L1: 2.2uH; L_Bourns-SRN4018
Q1: SS8050; SOT-23
R1, R8, R13, R14, R15, R17, R18, R23: 10K; R_0805_2012Metric_Pad1.20x1.40mm_HandSolder
R2: 453k; R_0805_2012Metric_Pad1.20x1.40mm_HandSolder
R3: 100k; R_0805_2012Metric_Pad1.20x1.40mm_HandSolder
R4, R5: 5.1K; R_0805_2012Metric_Pad1.20x1.40mm_HandSolder
R6, R7, R16: 22R; R_0805_2012Metric_Pad1.20x1.40mm_HandSolder
R9, R10: 4.7K; R_0805_2012Metric_Pad1.20x1.40mm_HandSolder
R11: 100K; R_0805_2012Metric_Pad1.20x1.40mm_HandSolder
R12: 2.2K; R_0805_2012Metric_Pad1.20x1.40mm_HandSolder
R20: 0R; R_0805_2012Metric_Pad1.20x1.40mm_HandSolder
R21: 10R; R_0805_2012Metric_Pad1.20x1.40mm_HandSolder
R22: 1K; R_0805_2012Metric_Pad1.20x1.40mm_HandSolder
R24: 10k; R_0805_2012Metric_Pad1.20x1.40mm_HandSolder
R25: 1k; R_0805_2012Metric_Pad1.20x1.40mm_HandSolder
SW1, SW2: TS-1088-AR02016; SW_SPST_TS-1088-xR020
U1: ESP32-S3-WROOM-1; ESP32-S3-WROOM-1_Thermal_0p3
U2: TLV62569DBV; SOT-23-5
U3: MPU-6050; InvenSense_QFN-24_4x4mm_P0.5mm
U4: USBLC6-2SC6; SOT-23-6
U5: INMP441ACEZ-R7
U6: MAX98357AETE+T; TQFN-16-1EP_3x3mm_P0.5mm_EP1.23x1.23mm

Connections:
+3V3: C1.1, C2.1, C3.1, C4.1, C12.1, C13.1, C17.1, C18.1, C21.1, C22.1, J2.3, J2.4, J4.4 (VDD), L1.2, R1.1, R2.1, R8.1, R9.1, R10.1, R12.1, R13.1, R14.1, R15.2, R17.2, R18.2, R24.1, U1.2 (3V3), U3.8 (VLOGIC), U3.13 (VDD), U5.7 (VDD), U5.8 (CHIPEN)
+5V: C5.1, C6.1, C10.1, C11.1, C19.1, C20.1, J1.A4 (VBUS), J1.A9 (VBUS), J1.B4 (VBUS), J1.B9 (VBUS), U2.1 (EN), U2.4 (VIN), U4.5 (VBUS), U6.7 (VDD), U6.8 (VDD)
/CHIP_PU: C7.1, R1.2, SW2.2, U1.3 (EN)
/GPIO0: R8.2, SW1.2, U1.27 (IO0)
/J_SPK.1: J3.1, U6.9 (OUTP)
/J_SPK.2: J3.2, U6.10 (OUTN)
/LED_K: J2.2, R21.1
/MPU_INT: U1.34 (IO41), U3.12 (INT)
/MPU_SCL: R10.2, U1.33 (IO40), U3.23 (SCL)
/MPU_SDA: R9.2, U1.32 (IO39), U3.24 (SDA)
/USB_CONN_N: J1.A7 (D-), J1.B7 (D-), U4.1 (I/O1)
/USB_CONN_P: J1.A6 (D+), J1.B6 (D+), U4.3 (I/O2)
/USB_D+: C8.1, R6.2, U1.14 (USB_D+)
/USB_D-: C9.1, R7.2, U1.13 (USB_D-)
/USB_PROTECTED_N: R7.1, U4.6 (I/O1)
/USB_PROTECTED_P: R6.1, U4.4 (I/O2)
AMP_BCLK: U1.5 (IO5), U6.16 (BCLK)
AMP_DIN: U1.4 (IO4), U6.1 (DIN)
AMP_LRC: U1.6 (IO6), U6.14 (LRCLK)
GND: C1.2, C2.2, C3.2, C5.2, C6.2, C7.2, C8.2, C9.2, C10.2, C11.2, C12.2, C13.2, C14.2, C15.2, C17.2, C18.2, C19.2, C20.2, C21.2, C22.2, C23.2, J1.A1 (GND), J1.A12 (GND), J1.B1 (GND), J1.B12 (GND), J1.SH (SHIELD), J2.1, J2.5, J2.6, J2.12, J4.6 (VSS), J4.SH (SHIELD), J7.2, Q1.2 (E), R3.2, R4.1, R5.2, R11.2, R20.1, R23.2, SW1.1, SW2.1, U1.1 (GND), U1.40 (GND), U1.41 (GND), U2.2 (GND), U3.1 (CLKIN), U3.9 (AD0), U3.11 (FSYNC), U3.18 (GND), U4.2 (GND), U5.4 (L/R), U5.5 (GND), U5.6 (GND), U5.9 (GND), U6.3 (GND), U6.11 (GND), U6.15 (GND), U6.17 (PAD)
KEY_USER1: C23.1, R24.2, R25.2, U1.9 (IO16)
LCD_BL: R22.1, U1.17 (IO9)
LCD_DC: J2.7, U1.19 (IO11)
LCD_MOSI: J2.10, U1.18 (IO10)
LCD_RST: J2.11, U1.20 (IO12)
LCD_SCLK: J2.9, U1.21 (IO13)
MIC_SCK: U1.38 (IO2), U5.1 (SCK)
MIC_SD: R11.1, U1.35 (IO42), U5.2 (SD)
MIC_WS: U1.39 (IO1), U5.3 (WS)
unnamed: J1.A5 (CC1), R4.2
unnamed: J1.B5 (CC2), R5.1
unnamed: J2.8, R20.2
unnamed: J4.5 (CLK), R16.1
unnamed: J4.8 (DAT1), R18.1
unnamed: J4.1 (DAT2), R13.2
unnamed: J7.1, R25.1
unnamed: Q1.1 (B), R22.2, R23.1
unnamed: Q1.3 (C), R21.2
unnamed: C4.2, R2.2, R3.1, U2.5 (FB)
unnamed: L1.1, U2.3 (SW)
unnamed: C15.1, U3.20 (CPOUT)
unnamed: C14.1, U3.10 (REGOUT)
unnamed: R12.2, U6.4 (~SD_MODE)
SD_CS: J4.2 (DAT3/CD), R14.2, U1.25 (IO48)
SD_MISO: J4.7 (DAT0), R17.1, U1.22 (IO14)
SD_MOSI: J4.3 (CMD), R15.1, U1.24 (IO47)
SD_SCK: R16.2, U1.23 (IO21)

Notes on the sheet:
按键与启动控制
显示屏接口
3.3V降压电源
J7：R13-507，双线直焊
ESP32主控
姿态传感器
USB接口与静电保护
音频功放与扬声器
数字麦克风
MicroSD存储

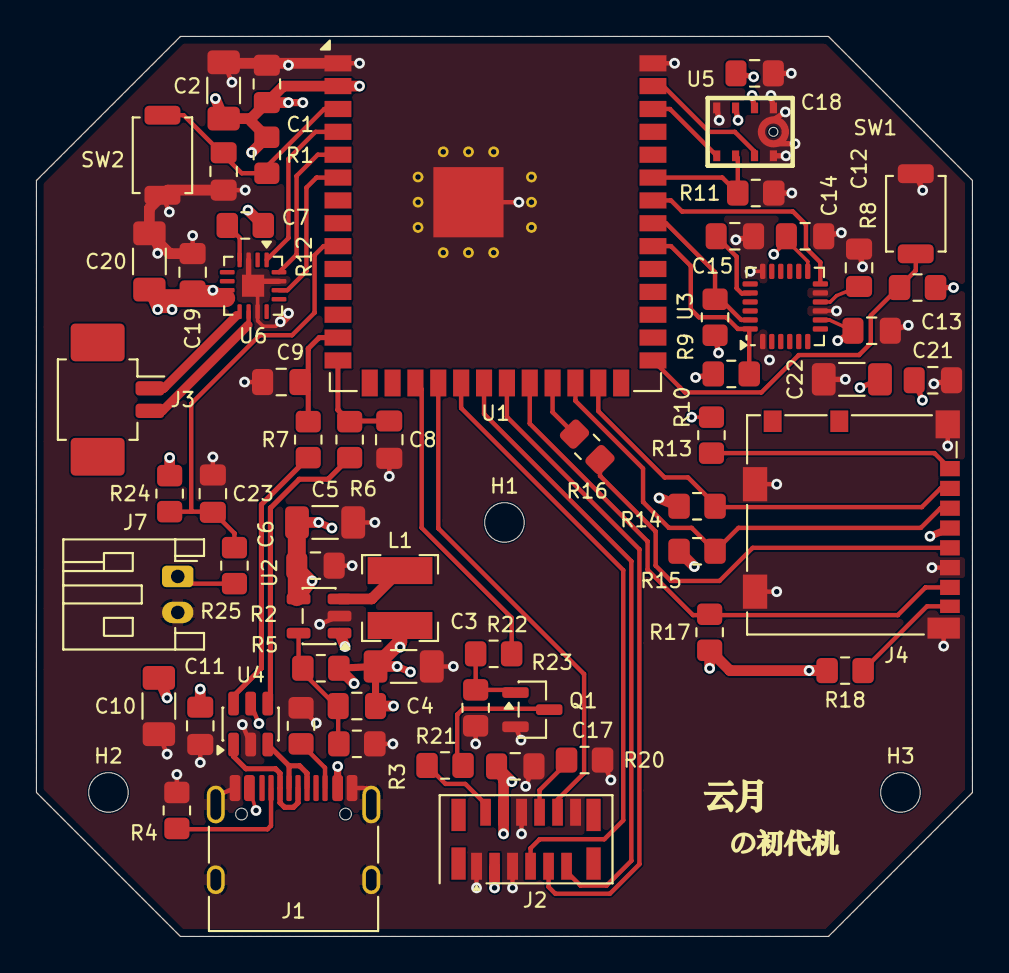
[picture p85: board VoxConductor.kicad_pcb from above]

Board: 4 copper layers, 52.0 x 50.0 mm, 64 parts (0 on the bottom side), 47 nets.

Other parts of the board:
H1, H2, H3: MountingHole_2.2mm_M2
