LighthouseXy/VoxConductor/(commit log)

2026-08-26 feat: publish AmbientDesk V1 prototype
    [BOM.csv, partitions.csv]
2026-08-26 refactor: rename project to VoxConductor
    [partitions.csv]
2026-10-10 docs: showcase current device and development progress
2026-10-10 hardware: consolidate KiCad sources and V3 enclosure delivery
2026-10-11 docs: strengthen technical and hardware guides with complete BOM and voice-masked demos
