LighthouseXy/VoxConductor/docs/images/2026-10-10/assembly-parts-overview.jpg

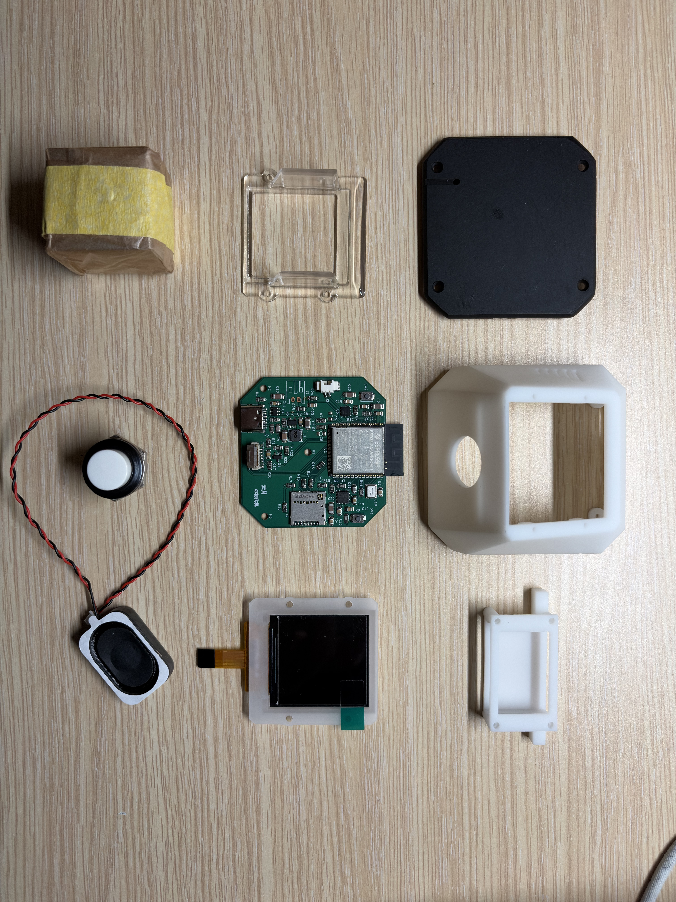
docs/images/2026-10-10/assembly-parts-overview.jpg
